NoobyNull/CNC-Display/README.md

# CNC Display

Touch-panel firmware for a [FluidNC](https://github.com/bdring/FluidNC) CNC router:
a pendant you mount by the machine and run jobs from. It runs on an
**Elecrow CrowPanel Advance 7.0** (ESP32-S3, 800×480, GT911 touch) with
[LVGL](https://lvgl.io) 8.3, and talks to the controller over a 1 Mbaud UART.
Built for one machine (a FoxAlien Masuter 3S 8040 on a Corgi board with an
OpenATC tool rack), but every control is gated on what the controller's own
config says it has.

<p>
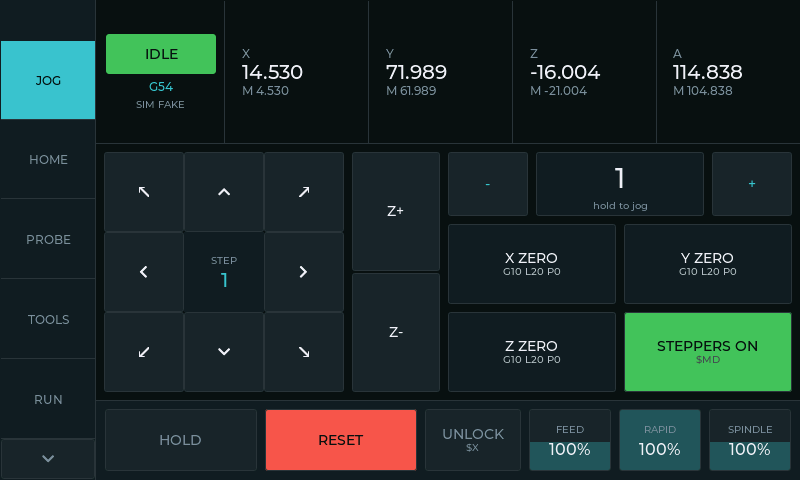
[picture p1: docs/screenshots/jog.png]
Jog page

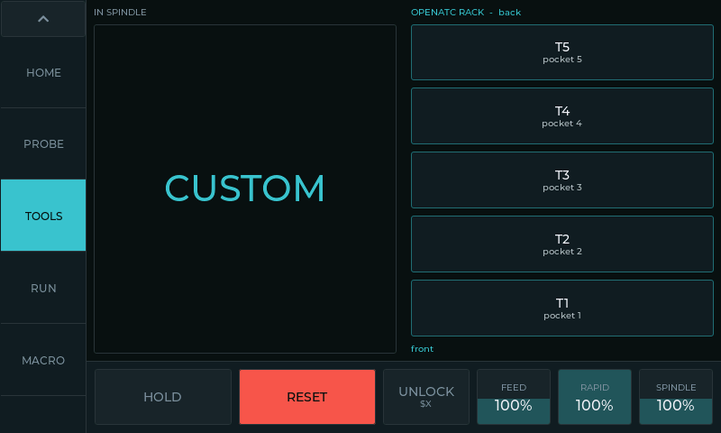
[picture p2: docs/screenshots/tools.png]
Tools page with the OpenATC rack

</p>

## What it does

- **DRO and jog** — work and machine position for every axis the controller
  reports; continuous hold-to-jog, step jog, tap an axis to type a target.
- **Homing walk-through** — when position can't be trusted (fresh link,
  controller restart, an alarm that loses position) a card walks you through a
  checklist, HOME ALL, and an optional tool-length measurement.
- **Tool changes** — a TOOLS page laid out like the machine: five buttons, one per
  OpenATC cartridge, in a column with T1 at the front. Anything else in the spindle
  is the custom tool, fitted and removed by hand. What a tool's card offers follows the
  controller's config: with an M6 macro, tap a tool and LOAD or CANCEL, and the
  macro does the rest; with `atc_manual`, LOAD / CURRENT / UNLOAD and honest text
  about what each will do. Either way the card shows the plan first, every
  by-hand step gets its own card, and jobs that pause for a tool say *which* tool.
- **Overrides** — feed, rapid and spindle open a full-width slider card.
- **Safety** — HOLD / RESET / UNLOCK on every page, never covered by a popup;
  STEPPERS OFF disarms hard limits so pushing the gantry by hand can't trip a
  reset that silently re-enables the motors.
- **Probe, offsets, macros, run from the controller's SD card, calibration,
  diagnostics** — see the screenshots below.
- **Network update** — the panel fetches its own firmware over Wi-Fi, resuming
  a stalled download.

## Screenshots

All of these are the real UI, rendered by the desktop simulator below.

| | | |
|---|---|---|
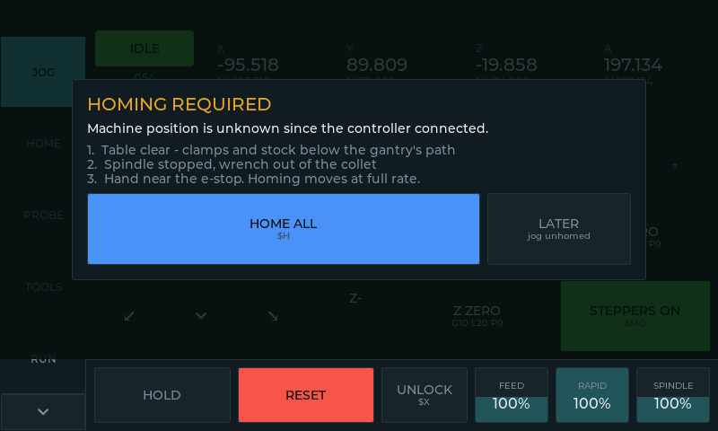
[picture p3: docs/screenshots/homing-walkthrough.png]
Homing walk-through
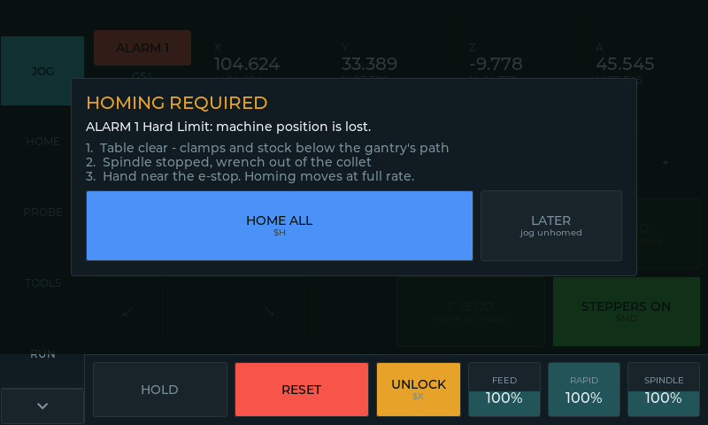
[picture p4: docs/screenshots/alarm.png]
Alarm
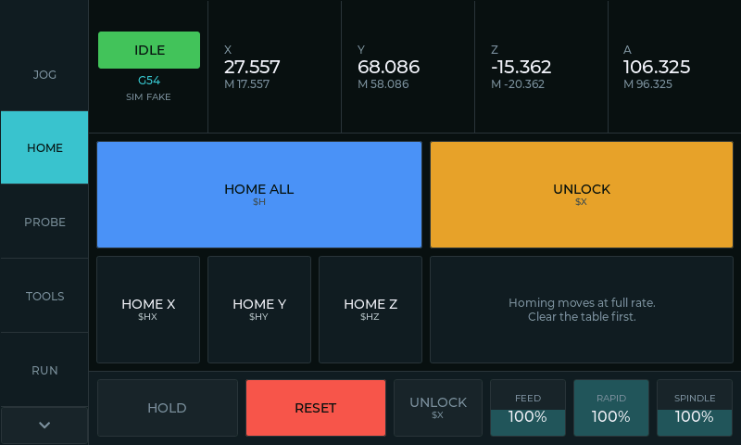
[picture p5: docs/screenshots/home.png]
Home
|  Homing walk-through |  After a hard-limit alarm |  Home |
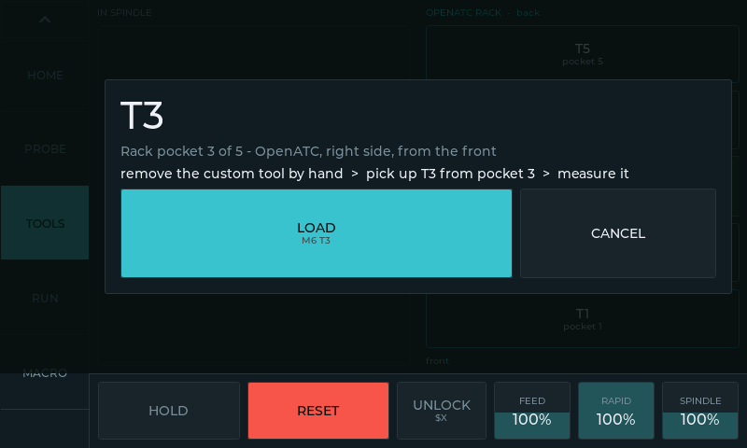
[picture p6: docs/screenshots/tools-load-card.png]
Tools load card
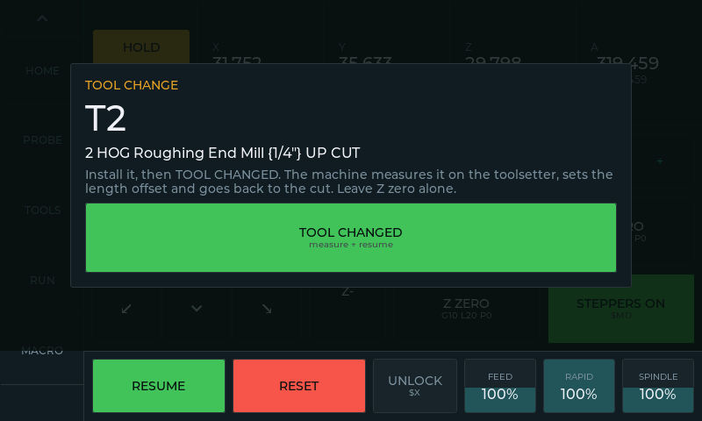
[picture p7: docs/screenshots/tool-change-card.png]
Tool change card
|  Tap a tool: the plan, LOAD / CANCEL |  A job paused for a tool | Tools Tools |
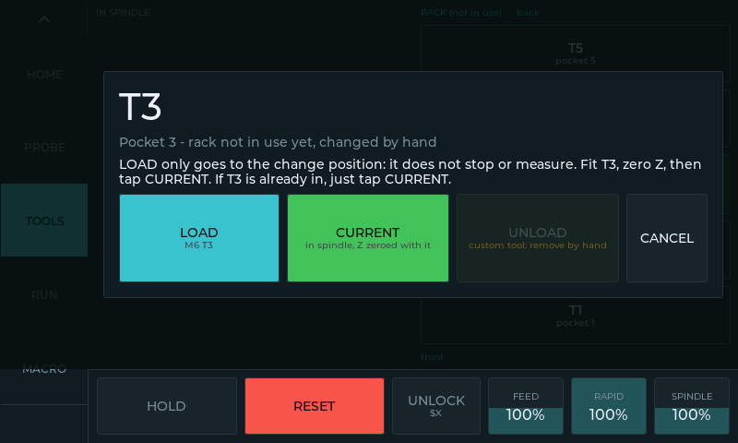
[picture p8: docs/screenshots/tools-manual-card.png]
Tools with atc_manual
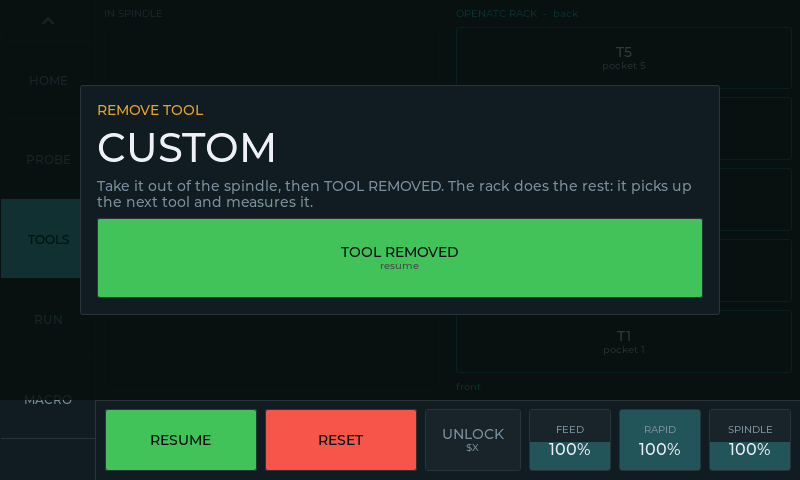
[picture p9: docs/screenshots/tools-remove-card.png]
Remove tool
|  The same card under `atc_manual` |  A custom tool coming out before a pickup | |
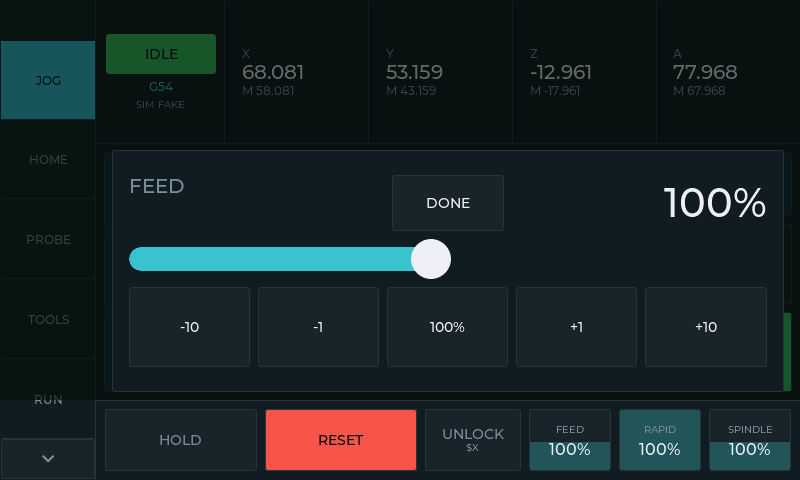
[picture p10: docs/screenshots/feed-override.png]
Feed override
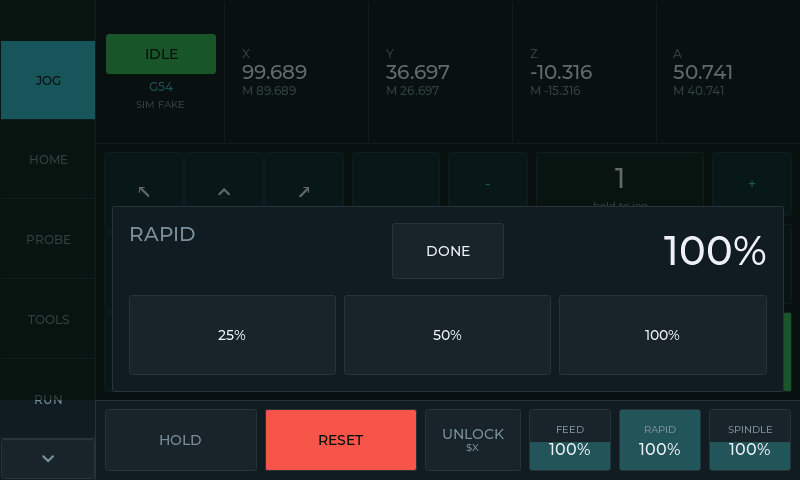
[picture p11: docs/screenshots/rapid-override.png]
Rapid override
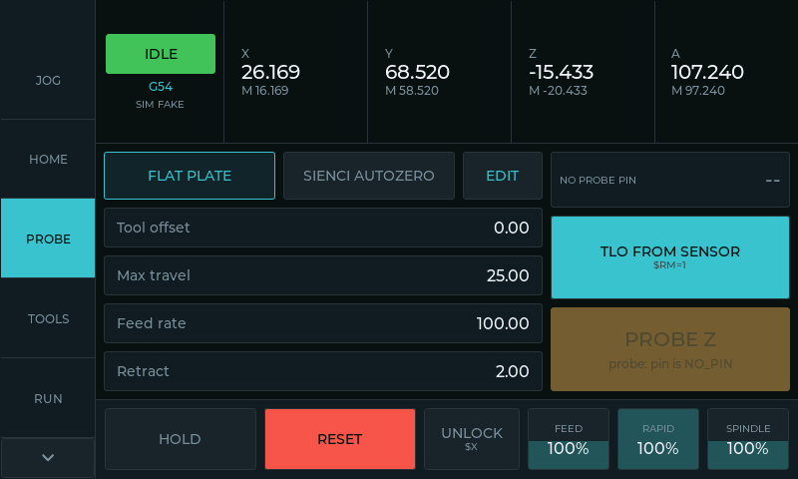
[picture p12: docs/screenshots/probe.png]
Probe
|  Feed override |  Rapid override |  Probe |
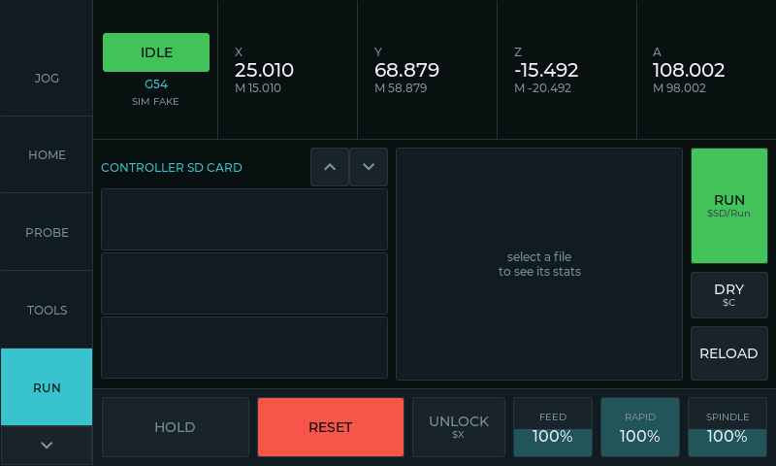
[picture p13: docs/screenshots/run.png]
Run
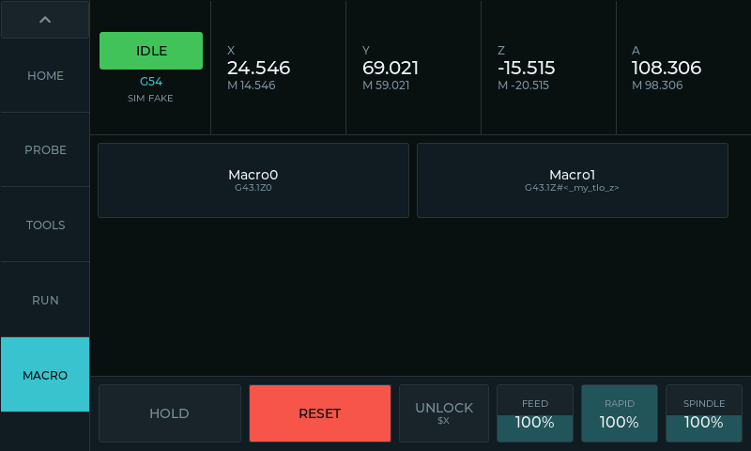
[picture p14: docs/screenshots/macro.png]
Macro
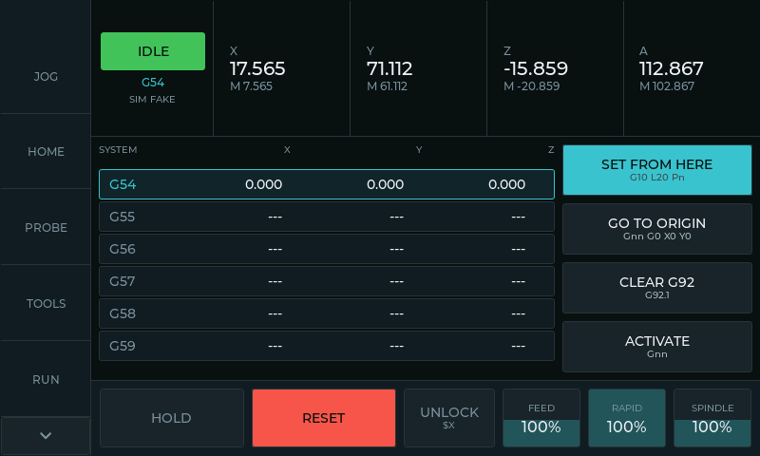
[picture p15: docs/screenshots/offsets.png]
Offsets
|  Run (controller SD card) |  Macros |  Work offsets |
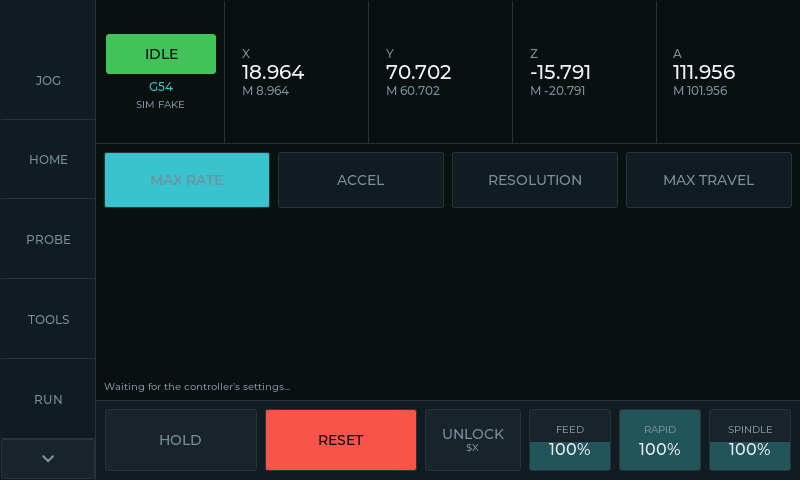
[picture p16: docs/screenshots/motion.png]
Motion
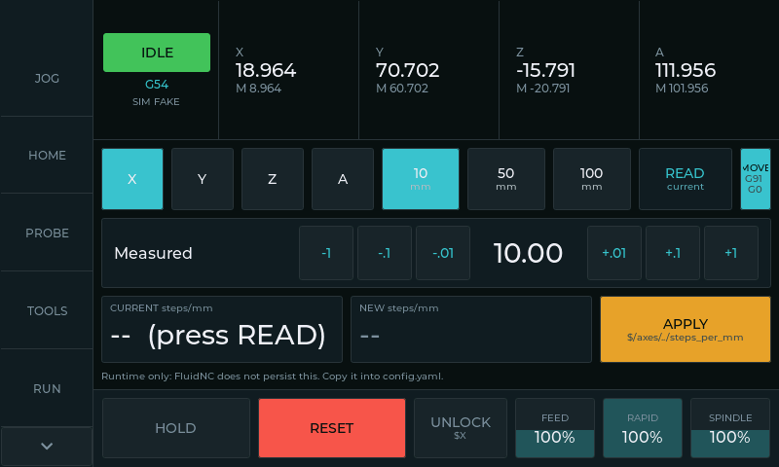
[picture p17: docs/screenshots/calibrate.png]
Calibrate
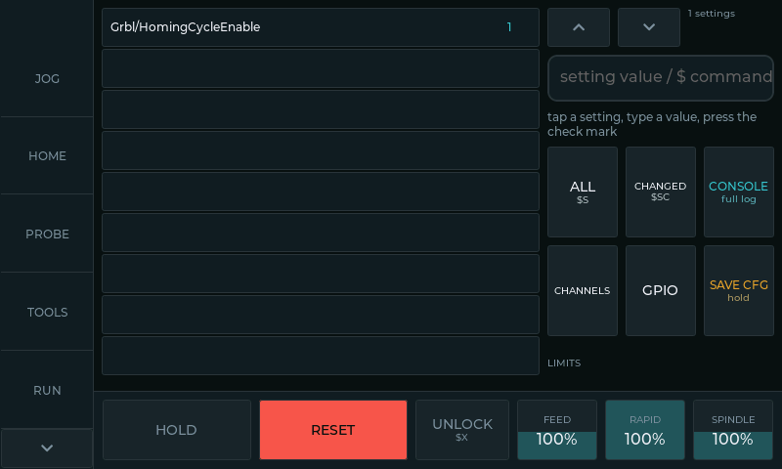
[picture p18: docs/screenshots/diag.png]
Diag
|  Motion settings |  Steps/mm calibration |  Diagnostics |
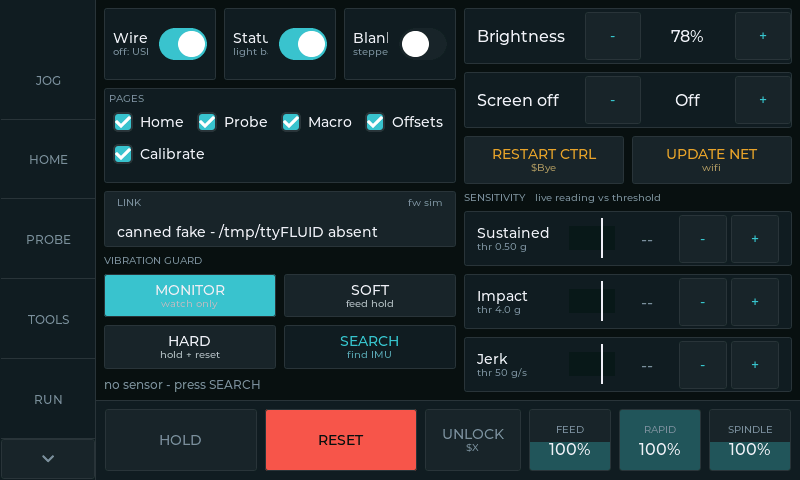
[picture p19: docs/screenshots/setup.png]
Setup
|  Setup | | |

## Building and flashing

[PlatformIO](https://platformio.org) builds everything:

```bash
pio run -e crowadv                 # the firmware
pio test -e native                 # host unit tests (parsers, models)
```

Flashing: the board's ROM bootloader over USB. `tools/flash.sh` and
`tools/flash_cnc101.sh` are the scripts used here (the latter flashes over SSH
from the PC the panel is plugged into). Once a panel is running, **Setup →
UPDATE NET** updates it over Wi-Fi from the URL in `src/model/settings.cpp`.

**Before building your own:** the Wi-Fi network and update URL defaults in
`src/model/settings.cpp` are this shop's; in the public copy the password and
access token read `REDACTED…`. Put your own in, or the network update has
nothing to connect to.

## Simulators

Two ways to run the real UI on a desktop without the hardware. Both compile
`src/ui` and `src/model` unmodified against SDL2 (needs `libsdl2-dev`).

### Desktop panel (`src/sim`)

The panel in a window, against a built-in fake controller:

```bash
pio run -e sim && .pio/build/sim/program
.pio/build/sim/program --page 10 --shot tools.bmp           # one frame, headless (page index)
.pio/build/sim/program --toolchange 2 --shot card.bmp       # a job pausing for T2
```

Window keys: `1`–`5` force Idle / Run / Hold / Alarm / Jog, `6` plays the next
tool change of a sample job, `space` freezes the DRO, `s` saves a screenshot.
`--tap "x,y;x,y>x2,y2"` scripts touches, which is how the screenshots above were
made. The fake controller runs an M6 macro by default; `--atc-manual` makes it
behave like `atc_manual` instead. `--link host:port` or `--link /dev/ttyX` drives a real FluidNC instead.

### FluidNC bench (`sim/`)

A fake FluidNC that loads an actual `config.yaml` and derives everything from
it — which axes, which limit and probe pins, whether homing exists — with a web
page to flip inputs and watch the controller:

```bash
make -C sim
./sim/run.sh              # the bring-up profile
./sim/run.sh equipped     # limits, probe, coolant, door, all present
# then open http://127.0.0.1:8080
```

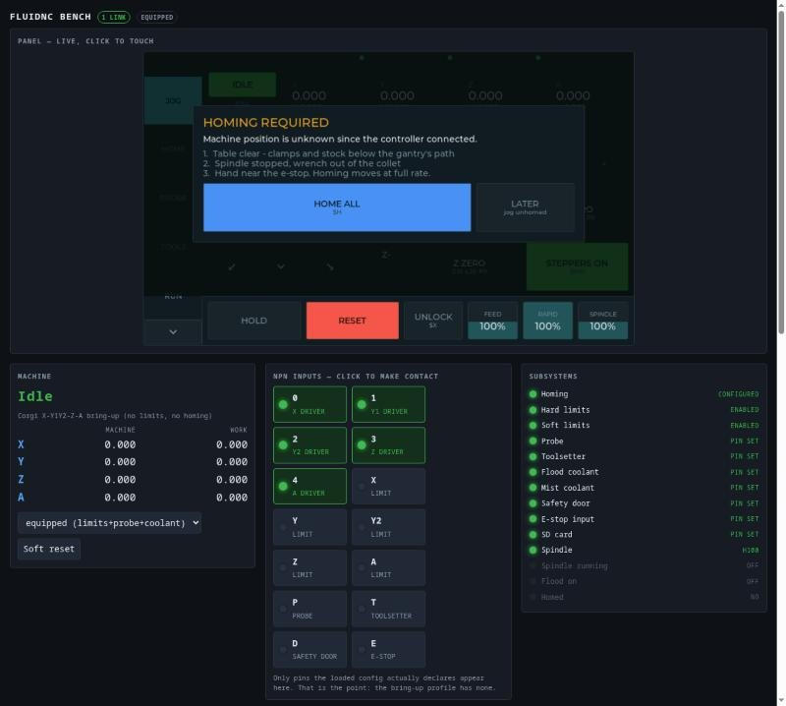
[picture p20: docs/screenshots/bench.jpg]
FluidNC bench


See [`sim/README.md`](sim/README.md) for what is real and what is faked.

## Layout

```
src/ui/        pages, the shell (rail, DRO, safety bar), cards and popups
src/model/     the FluidNC model: state, capabilities, homing, tools, offsets
src/hw/        display, touch, IMU, status LEDs, network update
src/transport/ the UART link and XModem
src/sim/       desktop simulator stand-ins
sim/           FluidNC bench simulator
test/          host unit tests (pio test -e native)
tools/         flashing, config upload, G-code generators
cad/           the panel's mounts and enclosures (FreeCAD)
docs/          engineering notes and handoffs, screenshots
```

The controller side of tool changes — the FluidNC `m6_macro` that drives the
OpenATC rack — lives with the machine's config, not in this repo.

## Credits

The FluidNC model and protocol handling started from Mitch Bradley's
[FluidDial](https://github.com/bdring/FluidDial) (GPLv3; the copy
that was vendored here is in the git history before the rework), and the parser is his
[GrblParser](https://github.com/MitchBradley/GrblParser).

## License

[GNU General Public License v3.0](LICENSE). This project builds on FluidDial,
which is GPLv3, so the whole is too: you may use, modify and share it, and
anything you distribute that is built from it must be shared under the same
terms, with its source.
