NoobyNull/CNC-Display/docs/HANDOFF.md

# Handoff — CNC Console, 2026-08-11

## Session 2026-10-07 — jog crawl, remote update, OTA fixed end to end — read this first

- **Jog/Go-To crawled** (100 mm at ~250 mm/min, seemingly random axis/direction).
  They read `Grbl/MaxRate/<axis>` from the `$S` table on every move, and Diag
  (All/Changed) and Motion edits clear that table and re-request it. In that
  window the lookup fell to `JOG_FALLBACK_RATE` (500 x jog%). Fixed: both keep
  the last rate seen per axis (`page_jog.cpp`, `goto_popup.cpp`).
- **Remote update trigger.** Telnet to FluidNC (192.168.0.5:23) and send
  `$LM=*PANEL:UPDATE` (or `$Msg/Channel=uart_channel2,PANEL:UPDATE`). The panel
  sees `[MSG:PANEL:UPDATE]` and runs `fwupd_net()` — the same function as the
  Setup UPDATE NET button — only when Idle/Alarm; the tap-to-cancel countdown
  still runs. Failures are broadcast back as `[MSG:PANEL-UPDATE FAILED: ...]`.
  Verified live: app1 written, otadata switched to it, panel relinked.
- **Network OTA had been broken twice over:**
  1. Cloudflare's minimum TLS on yax.family had been raised to 1.3. The panel's
     mbedTLS is TLS 1.2 only (`CONFIG_MBEDTLS_SSL_PROTO_TLS1_3` unset) -> HTTP -1
     "fatal alert". Min TLS set back to 1.2 (1.3 stays enabled). **If OTA starts
     failing with HTTP -1 again, check that setting first.**
  2. `Update.begin()` was called before the download and again before flashing;
     the second is refused with no error code ("No Error"). Now called once.
- `display_release_internal_ram()` moves the LVGL draw buffer to PSRAM before
  WiFi. Added on a wrong guess (internal heap turned out fine: 139K/61K free);
  harmless because every radio-up update ends in a reboot.
- **USB flashing via CNC101:** the panel is plugged into CNC101 (ssh alias
  `cnc101`, user cnc, fish shell — wrap remote commands in `bash -c`).
  `tools/flash_cnc101.sh` builds and flashes app0 at 115200 (460800 fails).
  This machine cannot reach 192.168.0.5 directly; CNC101 can.
- Seen in passing: FluidNC rapid override was at 5% (`Ov:100,5,100`, byte 0x98 —
  not the panel, which only sends 100/50/25); reset to 100.
- **The machine is no longer the bring-up config.** Live (synced to
  `CNC-Wiring/config.yaml`): limits, homing, probe/ETS, XY 10000 mm/min @ 800,
  Z 1000 @ 800, 39.882 steps/mm XY, 400 Z. `sim/profiles/corgi_bringup.yaml`
  is now a historical fixture (its tests need a no-homing machine), not the
  live config the sim README describes.
## Session 2026-09-16 — the IMU records now, and two sensor defaults were wrong

The vibration guard kept only `sqrt(ax²+ay²+az²)` and threw the three axes away
every sample. That is enough to notice a machine shaking and useless for working
out **what** is shaking: a scalar cannot be rotated into the machine frame
afterwards and cannot separate an X reversal from Z chatter. The sensor on this
machine is bolted to the **spindle** in an orientation nobody wrote down, so the
frame has to be recovered in post — which only works on raw axes.

**New `src/model/imu_log.{h,cpp}`** — raw 3-axis recorder, two sinks:

- **SD card**, `/imu/NNNN.csv`, the real one. Runs with the link up, so every
  sample carries the FluidNC state and machine position it happened at.
  Controlled by **IMU LOG on the Diag page**.
- **USB console**, 115200, `t_us,ax,ay,az` only. Alive solely when the Setup
  "Wired UART" toggle is OFF, so there is no link and no position — but the host
  PC can hold FluidNC's own CP2102 at the same time (different cable, different
  chip) and own that half of the correlation. `~/imu_capture.py` on the shop PC
  is the other end. Console keys: `r` record, `s` stop, `t` stream, `?` status,
  `h` help.

Samples go into a 2048-record PSRAM ring; `imulog_poll()` drains it from
`loop()`, never from a UI callback — an SD write can stall for tens of ms and
the FluidNC RX ring is only 16K (~160 ms at 1 Mbaud). A full ring drops the
**newest** sample and counts it: a log with a hole that says so is usable, one
silently resampled is not. The card never waits on the console; when both are
running, console lines that will not fit are skipped and counted separately.

### Two ICM-20948 defaults that were quietly wrong

SparkFun's `startupDefault()` leaves the accelerometer at **±2 g** with its
low-pass filter **disabled** (`acc_d473bw_n499bw`, ~500 Hz of noise bandwidth)
and the ODR at 1125 Hz. Both are now set explicitly in `imu_apply_config()`:

- **Aliasing.** Sampling 500 Hz of bandwidth at 50 Hz folds every spindle
  harmonic above 25 Hz back into the band, where it is indistinguishable from
  real low-frequency machine motion. The guard has been reading that since the
  port. The DLPF is now re-picked whenever the rate changes, always below
  Nyquist for the rate actually sampled.
- **±2 g clips below the 4.0 g impact threshold the guard ships with**, so
  `THRESHOLD_ESTOP_PEAK_G` could never fire however hard the machine was hit.
  Not a tuning problem — an unreachable number. Now ±8 g, which still resolves
  0.00024 g.

**This changes what the guard sees.** Less aliased noise in the band, and an
impact threshold that can now actually trigger. Re-check the sensitivity
settings on the Setup page against a real cut before trusting the old numbers.

### Rate

`IMU_RATE_HZ` is 50 (the comment above it claiming 200 has been stale since the
port). 50 Hz resolves 25 Hz — fine for catching an impact, too narrow for bench
and gantry resonances, which live in the tens of Hz. `imu_set_rate()` is new;
the recorder holds 200 Hz while a sink is open and hands it back afterwards,
because 200 Hz costs several percent of the shared I2C bus and that is visible
in the UI. `imu_skips()` counts samples lost to GT911 contention and belongs
next to any log taken at a raised rate.

## Session 2026-08-25 — the Corgi runs FluidNC **v4**, and $S changed — read this first

The controller is **FluidNC v4.0.3**, not v3. This invalidates an assumption
the panel was built on, and it is the root of several things that looked like
UI bugs. Captured live off 192.168.0.5 over the telnet channel (port 23):

- **`$S` on v4 returns the Grbl-compat settings ONLY** — `$Grbl/MaxRate/X`,
  `$Grbl/Acceleration/X`, `$Grbl/HomingCycleEnable` and the network keys. 55
  lines. It does **not** expose the config tree the way v3 did. There is no
  `/probe/pin`, no `/axes/x/motor0/limit_neg_pin`.
  - Consequence: `page_diag.cpp` scanned `$S` for `"/probe/pin"` to decide
    whether the probe lamp exists. On v4 that string never appears, so the
    lamp could never light. Fixed — it now asks `caps.cpp`.
  - The `fnc_settings.h` comment about "~150 lines on the 4-axis config" is a
    v3-era number.
- **Pins live in `$CD`** (the config dump, i.e. config.yaml). That is the only
  way to find out on v4 whether a probe, coolant or door input is configured.
- **`$RI=200` is rejected** (`error:3`). Auto-reporting is configured in the
  YAML instead — the Corgi's `uart_channel2` sets `report_interval_ms: 75`.
- `$Files/ListGCode=/sd` works and is correctly formed. `$Files/List` does not
  exist on v4; `$SD/List` and `$LocalFS/List` do.

**New: `src/model/caps.h`** — one place that answers "what can this machine
do", fed by `$S` and `$CD`. Capabilities are tri-state; anything not reported
stays `CAP_UNKNOWN` and leaves the control **enabled**, because a query that
failed is not evidence the hardware is missing. The Home and Probe pages and
the nav rail all gate off it.

**New: `sim/`** — the desktop bench. Runs the real `src/ui` and `src/model`
against a fake FluidNC v4.0.3 that has the actual Corgi config behind it, so
config-driven UI can be developed without the machine. See `sim/README.md`.

Two bugs fixed and pinned with tests (`pio test -e native`):

- `filelist.cpp` scanned from the first `{`, which is the outer
  `{"files":[...]}` object — so every listing showed its **first file twice**.
- The `$CD` scanner initially ate the `$S` reply, because both are queued at
  link-up and their replies each end in `ok`. It now ignores `$`/`[`/`<`/`{`
  lines and only honours a terminator once the YAML has actually started.

Still open: **the panel only ever browses `/sd`.** Controller flash holds no
G-code on this machine (just `config.yaml`, `favicon.ico`, `index.html.gz`), so
there is nothing to show there — but there is also no way to look.

## Session 2026-08-20 — CrowPanel Advance 7.0 V1.4
## From the parallel session — jog rework notes (since built on the branch)

## Next — jog rework (decided, not built)

Agreed design, with the constraints that shaped it. Nothing here is
implemented; `page_jog.cpp` is untouched.

**Continuous jog speed comes from a panel-side percentage**, not from the step
size. Today `continuous_feed()` is `STEPS[s_step] * 300` — FluidDial's "5x the
step per second" — so 1mm crawls at 300mm/min and the step selector is secretly
a speed selector. Replace with `axis maxrate * jog%`, reading
`$Grbl/MaxRate/<axis>` the way `goto_popup.cpp` already does, and keep `jog%` in
NVS with a -/+ control.

Panel-side rather than the controller's own overrides, and that was a real
fork:
- **RAPID has no +/-.** `Realtime.h` offers only Reset(100%), Medium(50%),
  Low(25%); ExtraLow is marked NOT SUPPORTED. It is a three-position selector,
  not a dial.
- **FEED has fine/coarse +/-** but governs cutting moves. Borrowing it for jog
  means the number set while jogging also scales the next G1 — a nasty surprise
  mid-job.
- Panel-side costs one piece of state the controller does not have, and buys
  full range with no semantic collision and nothing to verify about how FluidNC
  applies overrides to `$J=` (untested, do not assume).

**Step selector becomes `-` / number / `+`**, tap the number for a custom size
via the keypad already built for the goto popup. Step by decade. Keep
`CONTINUOUS_MAX_MM` as a DISTANCE test — it currently reads `STEPS[s_step]`,
and a custom 250mm step must still disable hold-to-jog.

**The coast on release is bounded in TIME, not distance**, and this is why
raising the feed is acceptable. Chunks are sized to `JOG_TICK_MS` (150ms), so
releasing a key completes at most one chunk: 0.15s of motion at any feed. The
distance scales with speed, the exposure does not, and no stop command is
needed — motion ends when chunks stop arriving. That is why JogCancel being
broken on v4.0.4 has never actually bitten. `JOG_TICK_MS` is the single safety
knob; shortening it presses directly on the still-open blocking-send bug, so
change it only after that is fixed.

**Backstops if a jog runs past travel**, checked against the config the
simulator runs (confirm against what is actually in the Corgi's flash, which
HANDOFF records as different):
- `fault_pin: 'gpio.35:low'` and `estop_pin: gpio.36` ARE configured, so a
  closed-loop driver stall raises an alarm — but only if the HB808C `ALM`
  outputs are physically wired. Continuity check at the cabinet, not something
  the panel can report.
- `soft_limits: false` everywhere, and meaningless until the machine homes.
- `hard_limits: false`, even where a `limit_neg_pin` is assigned.

So exactly one of the three is armed, and it depends on unverified wiring.
Endstops are planned; this note is precautionary.

Also worth doing while in here: surface `fault_pin` state on the panel, so a
driver fault reads as "driver fault" rather than an unexplained alarm.

---

## Session 2026-08-20 — CrowPanel Advance 7.0 V1.4 — read this first

The Waveshare 7B went back on warranty (U13 mux dead, section below), and the
firmware now targets the **Elecrow CrowPanel Advance 7.0 V1.4** (env `crowadv`,
800×480, same N16R8 module). Everything below this section describes the 7B and
stands as history; where it contradicts this section, this section wins.

**The link works end-to-end for the first time**: panel → UART0-OUT →
pigtail → Airedale pendant RJ12 → Corgi uart2 (gpio.27 TX / 25 RX @ 1M).
Verified live: DRO tracks, boot log shows `IO Expander BOARD:Airedale v1.1`.

Port facts, each of which cost real time — details in the code comments and in
auto-memory (`crowpanel-advance-wiring`, `corgi-config-mismatch`):

- Pin truth came from Elecrow's factory example
  (`example/V1.3_and_V1.4_and_V1.5/PlatformIO`) and the V1.4 Eagle schematic,
  not from third-party pinout sites — those were garbled.
- **UART0-OUT is 3.3V direct; UART0-IN is a BSS138 shifter pulled to 5V.** The
  IN connector is for 5V Arduino hosts; using it against a 3.3V controller was
  ruled out on purpose.
- **Console and link share GPIO 43/44** (the USB-C is a CH340K on the same
  nets; no native USB). The Setup "Wired UART" toggle picks the owner at boot.
  Flashing over the wire requires the link cable unplugged — or skip the wire:
  **SETUP → hold UPDATE FW flashes `/update.bin` from the SD card** (two-slot
  partition table as of today; the repartition itself was the last forced wire
  flash).
- Backlight/touch-reset/buzzer live on an **STC8H1K28 at I2C 0x30**: one byte
  0–245 sets brightness (0 = full), 250 pulses the GT911 reset. GT911 INT is
  GPIO 1, I2C is 15/16, SD is SPI on 4/5/6 with the **function DIP on
  TF-CARD** (that position also disconnects UART1-OUT and the audio — one of
  three, not à la carte).
- **FluidNC only auto-reports on a uart_channel after it has received
  something** (`UartChannel::_active`). A silent pendant hears silence forever;
  every passive listen during bring-up was doomed. Poll first.
- **`$CD=config.yaml` is FluidNC's undocumented persistent save** — dumps the
  live config tree over the boot file. The DIAG page has a hold-button for it,
  and a free-text `$` command line (tap the edit box with no setting selected).
- **The Corgi's flash config is not `~/Desktop/CNC/corgi_config.yaml`.** Flash
  runs a 3-axis FoxAlien-named config (uart2 pins correct); the desktop file is
  the intended 4-axis spec, fixed but not uploaded. Reconcile before machine
  work.
- Boot splash in `src/ui/splash.cpp`; its timeline starts in `splash_begin()`
  *after* blocking init, because the anim clock is wall-time and boot would
  otherwise spend the whole sweep invisibly.

Build `pio run -e crowadv`; tests unchanged (`pio test -e native`, 83 cases).

---

The firmware moved from the Elecrow CrowPanel Advance 7.0" to the **Waveshare
ESP32-S3-Touch-LCD-7B**. The old board was abandoned because it could not be put
into download mode: its CH340's TX line was dead and EN was shorted to IO0. None
of that survives here — the 7B flashes over native USB.

---

## Session 2026-08-12 (evening) — read this first

**75/75 host tests pass**, flash 14.5%, RAM 20.8%.

### The GT911 was never broken. The watchdog was.

The previous session shipped a watchdog that hard-reset the touch controller
after 5s without a frame, built on the belief that *a healthy GT911 free-runs at
5-10 frames/s while untouched*. **That belief is false**, and it was measured
from a panel already assumed to be broken — the exact trap the previous handoff
warned about, walked into anyway.

What this chip actually does, measured with a finger on the glass:

```
idle=115s                                 <- quiet for two minutes, "stalled"
[touch] frame 64 t=115870 status=0x81     <- finger lands
[touch] press 63,342 t=115870
[touch] frame 65..68  (10-40ms apart)     <- scanning at its 8ms refresh
[touch] lift t=116005
idle=0s  down=1  scans 63->74->88  int=0  <- LVGL received it
```

It reports only while something is happening. Untouched it emits three frames
after reset and then nothing, indefinitely. **Idle silence is its resting state,
not a fault.** So the watchdog spent every session resetting a working
controller every 5 seconds — 27 resets in 170s — each costing 300ms of blocked
UI and a forced `touch_down = false` that ate any press in flight. Its own
backoff could never fire: each reset yielded three frames, which looked like
progress and cleared the futile-reset counter.

Removed entirely: `touch_watchdog()`, `FRESH_STALE_MS`, `s_last_fresh_ms`,
`s_fresh_at_reset`, `s_futile_resets`, `s_reset_count` and its accessor. The
I2C error recovery stays — a real bus fault shows up as `staterr`, not silence.
**Do not add a no-frames watchdog back.** There is a blunt comment in
`touch.cpp` where it used to live.

The chip's stored config was read for the first time and is intact — checksum
valid, 1024x600, INT falling-edge, 8ms refresh, `lowpower=3s`. `lowpower` looked
like the culprit until the frame timestamps showed the quiet starting ~20ms
after reset, not 3s. `gt911_dump_config()` prints all of it at boot; it is
one-shot and only runs with a USB host attached.

### Jog keys are disabled when there is no controller

`send_jog_line()` is ack-gated on UART, so every press parks in
`fnc_send_line()`'s `while (_ackwait)` until the 2000ms timeout — inside the
same `lv_timer_handler()` pass that reads touch. Held past 400ms it is worse:
`jog_chunk()` re-sends every 150ms, each send costing more than the tick that
scheduled it, so the timer is permanently overdue, the input read is starved,
and the release that would call `jog_stop()` never arrives.

`page_jog_tick()` now greys the ten direction keys out while
`state == Disconnected`. `lv_obj_hit_test()` rejects `LV_STATE_DISABLED`
outright, so the press never reaches an event handler.

**This makes the jog page inert on a bench with no controller.** Run the
simulator (below) and the keys come back by themselves.

### STILL OPEN — the blocking send

Disabling the keys does **not** fix the dangerous case. A *connected* controller
that stops acking — busy planner, ALARM, XOFF, a cable glitch — blocks
identically, because `state != Disconnected`. That is the case that happens
mid-cut, when a frozen panel means no HOLD and no RESET.

It is not jog-specific either: `zero_cb` and `motors_off_cb` go `send_linef` ->
`vsend_linef` -> `send_line` -> `fnc_send_line(s, 2000)`. X/Y/Z ZERO and
STEPPERS OFF freeze the panel ~2s per press with the link down.

The fix is one place — the UI must never wait on an ack. `show_ok()` already
exists in `FluidNCModel.cpp` and already decrements a jog-window counter, so
acks are visible app-side: a chunk can **skip** when one is outstanding instead
of blocking, which also stops the planner queue growing.

### The simulator is fixed — five faults, stacked

`~/Projects/FluidNC`, run from `simrun/`. The previous handoff blamed
`ttybridge.py`; **the bridge was innocent**.

> **FluidNC ITSELF MUST STAY STOCK.** Every fix below lives in `simrun/` —
> config and NVS data, nothing else. The first attempt at this fixed four of the
> five by editing `capture/Platform.h`, `capture/i2s_out.cpp` and
> `platformio.ini`, and that was thrown away. A simulator that only works
> against a patched FluidNC proves nothing about the real controller, and the
> patch is a permanent liability every time upstream moves. If a future fix
> seems to need a FluidNC source change, it is the wrong fix.

The host build's constraints are fixed, so the config bends to them: ESP32-S3
pin table (legal `0-21` and `35-48`), `MAX_N_I2SO 0`, `MAX_N_UARTS 2`,
`Spindles/VFD/*` excluded. `MAX_N_SIMULATOR 1` and
`DEFAULT_STEPPING_ENGINE = SIMULATOR` come from stock `posix/Platform.h`.

| Fault | Fix, entirely in `simrun/` |
|---|---|
| Telnet 23 / HTTP 80 are privileged ports. Arduino-Emulator's `EthernetServer::begin_()` loops `while (::bind(...) < 0) { delay(1000); }` **for ever**, so startup never completed | `native_nvs/Telnet.Enable` + `HTTP.Enable`, one `0x00` byte each (`EnumSetting` loads via `get_i8`, `OFF = 0`; the key's `/` becomes `.` in the filename) |
| `gpio.23/32/33` do not exist in the S3 pin table | remapped in config to `gpio.20/40/41`. Motion parameters untouched |
| Every `I2SO.n` disable pin is an "Unknown pin type", and the `i2so:` section an ignored key | `i2so:` section dropped; the five `disable_pin`s are `NO_PIN`. The simulator engine never drives them |
| `uart2` (expansion) exceeds `MAX_N_UARTS 2`, and `Huanyang:` is an ignored key because the host build excludes the VFD sources | `uart2:`, `uart_channel2:` and `Huanyang:` sections dropped. No spindle and no Airedale in the sim |
| `engine: I2S_STREAM` is not a registered host engine, so it silently fell back to `step_engines[0]` (Timed) — which demands gpio step pins, failing all five motors | `engine: Simulator` with `sim.0-3` step/dir pins; `StandardStepper::validate()` has an explicit `sim` escape hatch |

Any one of them alone kept it in Alarm with `$X` refusing to clear
(`error:152`). Verified against **stock** FluidNC: zero `ERR` lines at boot,
`Stepping:Simulator`, `$J=G91F1000X10` -> `ok`, MPos 0 -> 10 -> 20, and the
panel links over the FTDI at `state=5`.

**`sim.N` is an axis, not a pin** — `sim.0`=X, `sim.1`=Y, `sim.2`=Z — and the
same sim pin is valid for both step and dir. Y1 and Y2 share `sim.1`.

**Two gotchas, both of which cost real time:**

1. FluidNC's host build reads `simrun/native_localfs/config.yaml`, **not**
   `simrun/config.yaml`. They are different files; the outer one is stale and
   unused. Edit the localfs copy.
2. FluidNC's config parser takes the rest of the line as the value, so a
   trailing `# comment` after a pin becomes **part of the pin name** —
   `Cannot write to pin NO_PIN        # SIM ONLY...`. Notes go on their own line.

### Next on the sim

After the handshake `rx` froze at 51 and `tx` at 59 — the link is up and acking,
but no status reports flow, so the DRO will not track a jog live. Unsolved.

### Diagnostics added, all deliberately kept

`[touch] press x,y` / `lift` on every touch, `[touch] frame N t= status=` for the
first 8 frames after a reset, `int=` and `stat=` on the 2s status line, and
`[jog] chunk blocked Nms` when a jog send costs more than 20ms. The press log is
what proved the controller healthy; the frame timestamps are what killed the
`lowpower` theory.

---

## Session 2026-08-12 (earlier)

Everything below the next divider is still accurate except where this section
contradicts it. **73/73 host tests pass**, flash 14.4%, RAM 20.6%.

### Added

| | |
|---|---|
| Screen blanking | SETUP -> "Screen off", 0-60min in 5s, **default Off** (opt-in) |
| Brightness | now 10-100% in 5% steps; storage stays 0-255 |
| Jog | hold a direction key for continuous motion at <=1mm; tap the pad centre to cycle the step x10 |
| CAL page | new nav slot: command 10/50/100mm, measure, apply corrected steps_per_mm |
| Sensor bars | SETUP thresholds are horizontal bars of live-vs-threshold; guard buttons 2x2; jerk histogram removed from the UI |
| Touch | now INT-driven (~7 reads/s, was 50); presses latched so a tap between two LVGL reads is never lost; stall watchdog with backoff |
| IMU | 200Hz -> 50Hz. **Do not go lower**: jerk is rate-independent arithmetic but bandwidth is not — 10Hz resolves 5Hz and a 20ms impact falls between samples, leaving the guard blind while still appearing armed |

### Two bugs shipped and fixed the same session — both worth remembering

**The backlight never came back.** `screen_idle_tick()` decided whether to touch
the backlight by comparing the screensaver's state before and after updating it,
but the touch driver clears that same flag when it swallows the wake tap. No
transition left to observe, `EXIO_DISP` never re-enabled, panel dark until a
power cycle. Fixed by tracking what the backlight *is* doing against what the
screensaver *wants*. **Never infer a hardware edge from state another layer can
also move.**

**A stuck touch killed the panel.** The wake-tap swallow waited for a release.
The GT911 holds its last reported state when it stops producing fresh scans, so
`touch_down` stayed asserted, the release never came, every sample was swallowed
for ever. Fixed with a 600ms cap on the swallow. **Any gate that can only be
opened by an event from hardware is a gate hardware can leave shut.**

Neither was caught by the host tests, and the first could not have been — the
pure module was correct both times, the faults were in the hardware follower.
The regression test for the second one fails against the old implementation.

The console line now carries `scroff=<n>min idle=<n>s [BLANK]`. That diagnostic
turned "I don't think the timeout worked" into a fact in one reading, twice.
Leave it in.

### Verified on hardware this session

- Blanking fires at exactly `idle=301s` on a 5min setting, and stays blank.
- Panel links to a real FluidNC v4.0.4 (the simulator) over the FTDI, locks
  115200, primes offsets and the file list, tracks state live.

### NOT verified

- **The CAL page has never talked to a controller.** `$/axes/<x>/steps_per_mm`
  read-back and apply are untested against anything real.
- **The jog changes have never moved a machine.**
- **The vibration bars have never seen an IMU.**

### Open questions left on the table

1. **Panel power.** Do **not** run the panel off the Airedale's RJ12 5V — that
   port was sized for a FluidDial (~100mA), and a 7" panel with backlight is
   500-800mA through 26AWG phone cable. ~0.5V drop at 800mA over 2m, and 5V has
   no headroom. Feed it at its own PH2.0 `POWER/GND/5V` input from a buck at the
   panel, **cut the RJ12 5V conductor**, keep RJ12 GND for the UART reference.
2. **File flow undecided.** The panel already does both directions —
   `upload_start()` sends `$XR=`, `pathload_start()` sends `$XS=`. If G-code
   lives on the controller's SD (put there over WiFi), nothing more is needed:
   list it and `$SD/Run=`. A panel-side copy needs a new sink in
   `path_loader.cpp:19`. Decide before building.
3. **USB thumb drive is a dead end.** The 7B's native USB-C has 5.1K pulldowns
   on CC1/CC2 (sink) and VBUS hard-tied to the 5V rail with no switch — it is
   wired as a device. Confirmed from the Waveshare schematic. A microSD
   extension ribbon solves the real problem; keep it **short**, the card runs
   SDMMC 1-bit at 20MHz (`sdcard.cpp:27`), not SPI.
4. **`JogCancel` (0x85) did not stop a jog on FluidNC v4.0.4** — neither raw
   (which is what `GrblParserC.c:572` sends) nor UTF-8 encoded, while `!` worked
   every time. Unexplained. Continuous jog therefore re-issues bounded chunks
   and never depends on that byte. Worth settling on real hardware.

### The GT911 stalls, and it is not cured

**The open bug.** After a burst of touch activity the GT911 stops setting its
data-ready bit and never resumes. Not a bus fault: `polls` climbs, `scans`
freezes, `lockfail=0`, `staterr=0` — the chip answers every transaction and
reports no frames. `touch_poll()` keeps the last state when no frame arrives, so
`touch_down` freezes and the panel looks dead. A power cycle clears it.

**Each watchdog reset yields exactly three more frames, then stalls again.**
103 -> 106 -> 109, every time. That regularity is the lead.

**Untried:** this driver has never written a GT911 config — no refresh rate, no
INT trigger mode — it runs on whatever the chip has stored, and we now drive INT
as an interrupt without knowing what mode it thinks it is in. Read
`0x8047..0x80FF` and check the INT trigger byte at `0x804D` before writing
anything; a bad checksum at `0x80FF` bricks touch until the chip is re-flashed.

**Ruled out, with evidence — do not re-test:** bus wedging (`staterr=0`), the IMU
starving the bus (`lockfail=0`), a GPIO4/RGB conflict (RGB uses
14/38/18/17/10/39/0/45/48/47/21/1/2/42/41 + 46/3/5/7), screen blanking
(reproduced seconds after boot, screen lit), the screensaver swallowing input
(`idle` climbs during the stall), and the interrupt conversion itself.

**Two wrong turns worth not repeating.** "Idle silence is normal for a GT911" is
false — a healthy chip produces ~5-10 frames/s untouched. That was concluded from
a chip already wedged, and a watchdog was narrowed to the wrong condition on the
strength of it. *Never characterise normal behaviour from the device you are
debugging.* And the first watchdog storm-reset every 5s at 300ms of blocked UI
each; it now backs off after three futile attempts.

Full write-up: `/tmp/HANDOFF-display-responsiveness-fix.md`.

### The simulator rig is broken

`~/Projects/FluidNC/simrun` no longer answers commands on the pty or a pipe. It
boots fully (config parses, `fault_pin`/`estop_pin` reported) then loops on
`Emulator - Error: bind failed` after `HTTP started on port 80`. Root cause not
isolated. It was working earlier the same day; the confound was three orphaned
`program` instances fighting over ports 80/23, and clearing them did **not**
restore it.

`ttybridge.py` gained `--serial <port> --baud <n>` to serve the pty and a real
UART at once. The pty half stopped delivering once the panel joined. Suspect
that change before suspecting the simulator.

**Kill simulator processes by PID, never by pattern.** `pkill -f`, and any
`/proc` scan matching a string that also appears in your own command line, kills
the agent session (exit 144). Happened again this session.

---

## Status

**First hardware bring-up is done.** The panel draws, touch works, the UI is up
and interactive. `13.6%` flash of a 6 MB app partition, `20.6%` RAM, 58/58 host
tests pass.

The jog acceptance test passes: press a jog key, slide off without lifting, the
axis stops (`LV_EVENT_PRESS_LOST`). That only worked after the GT911 press-state
fix below — before it, the press never survived long enough to be lost.

**The link is proven, against a stand-in controller.** An FTDI on the UART
terminal answering `?` with a 4-axis Grbl status report brings the panel fully
up: it locks the baud, leaves `Disconnected`, fires `$#` and
`$Files/ListGCode=/sd` from `prime_link_if_up()`, and the DRO grows its **A
column and tracks it live**. So the transport, GrblParserC, the priming path and
the multi-axis layout are all confirmed — only the real machine at the far end
is untested.

Reproduce it with `fakefluidnc.py` (see below): it answers status polls and
pushes a report every 200ms, which is what `$RI=200` asks for. Without the
periodic push the panel decides the link went away.

**Still not verified against hardware:**

- **The real controller.** See the Airedale baud/parity note under *Still open* —
  the stand-in worked because it spoke 115200 8N1, which is what the panel
  already hunts for. The Corgi as configured does not.
- **The vibration guard.** No IMU has ever successfully sat on this bus, so the
  jerk histogram, thresholds and smoothed peak are covered by host tests only.
  The one that was wired held an I2C line low and took out all touch until it
  was unplugged — see below.

---

## Bringing the panel up with no machine attached

An FTDI on the UART terminal is enough to exercise everything above the wire.
`tools/fakefluidnc.py` answers `?` with a 4-axis report and `ok` to every line,
so `send_line()` never spins in `_ackwait`:

```bash
python3 tools/fakefluidnc.py /dev/ttyUSB0 115200 120
```

Two things that cost time working this out:

- **"Wired UART" persists in NVS.** With the Setup toggle off, `s_active` stays
  `TRANSPORT_NONE` and `fnc_putchar()` writes nothing at all — the panel is
  silent on the wire and it looks exactly like miswiring. Check the toggle before
  suspecting TX/RX.
- **The UART1/UART2 switch (SW1)** routes GPIO 43/44 through the FSUSB42UMX mux
  (U13) to either the CH343 USB-C port ("UART1") or the H3 PH2.0 terminal
  ("UART2"). The earlier revision of this doc had it right; the "two terminals"
  correction was wrong — per the Waveshare wiki, "6 and 7 [USB TO UART port and
  UART terminal] are the same UART, selected by switch". H3 pin order is
  **3V3 · GND · RX · TX**.
- **This board's H3 terminal is factory-dead** (confirmed 2026-08-15): 0 V even
  on its 3V3 pin with a seated plug, while the I2C header next to it reads 3.3 V
  with the same cable. Firmware, GPIO 43/44, mux, and switch all verified good —
  internal loopback passes, and a full two-way link ran through the CH343 side.
  Root cause isolated 2026-08-16: **U13 (FSUSB42UMX mux) is internally dead on
  its terminal-side channel**. Proven by elimination: ESP→R107→mux common side
  reads 499Ω and carried live 1 Mbaud data via the CH343 path; mux→H3 traces
  beep; H3 legs reflowed. Fix: warranty swap, hot-air replace U13, or bypass
  bodge (R107 mux-side pad → H3 pin 4, module RXD0 castellation → H3 pin 3,
  SW1 left on UART2).
- `init_fnc_uart()` now logs setup error codes and runs a silicon-internal
  loopback self-test at boot (`[uart] internal loopback: n=4 data=PING` = the
  transmitter provably works, wiring problems are downstream of the chip).
- **Which Type-C is which:** `303a:1001` is the native USB (flashing + `Serial`
  console); `1a86:55d3` is the CH343 USB-UART. The VID tells you which port the
  cable is in when the silkscreen does not.

---

## Bring-up: what actually went wrong

Five days of assumptions died on contact with the hardware. In order of how long
each cost:

### The panel was white because LovyanGFX cannot express these timings

`Bus_RGB::config_t` stores every porch and pulse width in an **`int8_t`**
(`Bus_RGB.hpp:85-90`, still true on upstream master). Waveshare's real values —
`hsync_pulse_width 162`, `hsync_back_porch 152` — wrap to **-94** and **-104**.
The horizontal timing generator gets garbage, the panel never syncs, and the
screen sits white with the backlight lit.

Everything else checked out and wasted hours: the pin map matches Waveshare's
`rgb_lcd_port.h` exactly, so do the timings, the PCLK and the io-extender.

### Then it was static, because LovyanGFX has no bounce buffer

`Panel_RGB::initFrameBuffer()` unconditionally puts the whole framebuffer in
PSRAM — its `use_psram` field is literally marked `unimplemented`, and the code
comments itself as "provisional implementation ... ToDo: split allocation".
Streaming 1.2 MB per frame straight out of PSRAM while LVGL writes into it
produces static-TV noise. Dropping PCLK to 21 MHz reduced it; nothing removed it.

**The driver is now ESP-IDF `esp_lcd_rgb_panel` directly** (`display_hw.cpp`):
`uint32_t` timings so the true 162/152 are restored, two DRAM bounce buffers
(`1024*10` px), full 30 MHz. LovyanGFX is no longer in the display path.

### Touch worked all along; we were throwing the press away

`touch_poll()` treated GT911 status `0x00` as a finger lift. It means "no fresh
scan since you last cleared the buffer" — the normal case, since we poll at 50Hz
and the controller refreshes slower. `touch_down` was dropping to false between
refreshes, flickering the press faster than LVGL samples the input device.
Press-and-hold on a jog key was impossible. Now the previous state stands unless
bit 7 is set.

### An SD card can stop the board booting entirely

A faulty microSD in the slot pulls the 3.3 V rail down hard enough that the chip
never starts — **no USB enumeration at all**, which is below firmware and below
boot mode. Symptom is indistinguishable from a dead board or a charge-only cable.
A known-good card behaves perfectly. If the panel is completely dark, pull the
card before suspecting anything else.

### A miswired I2C device takes out every input on the panel

An ICM-20948 wired wrong held a line low and wedged the bus. `ESP_ERR_INVALID_STATE`
on every transaction from then on — and since the GT911 shares SDA 8 / SCL 9,
**all touch died, safety bar included**. `touch_poll()` now counts consecutive
failures and re-inits the bus after 25 (~0.5 s), and `imu_probe()` recovers the
bus after a failed probe, because SparkFun's `begin()` against a missing device
is what wedges it in the first place.

---

## WiFi was removed

The WiFi/Telnet transport is gone: `wifi_link.{h,cpp}` deleted, `TRANSPORT_WIFI`,
the Telnet host/port settings and the Setup credentials UI with it.

The ESP32-S3's WiFi stack blacks out the flash cache, and arduino-esp32 ships its
prebuilt libs with **`CONFIG_LCD_RGB_ISR_IRAM_SAFE` unset** — so the RGB panel's
ISR cannot run during those blackouts, the DMA loses sync and the display tears
and drifts. Bounce buffers do not cover it. It cost 623 KB of flash and the
machine link is a cable anyway.

`display_resync()` survives that removal and is called after every **NVS write**,
which blanks the cache the same way — the brightness +/- buttons write a key per
press.

---

## Hardware

ESP32-S3-WROOM-1-**N16R8** (16 MB flash, 8 MB octal PSRAM), 1024×600 RGB565
panel behind an ST7262, GT911 touch, CH32V003 I2C io-extender, CH343P USB-UART,
native USB, RS485 (SP3485) and CAN (TJA1051).

### GPIO map

| Pins | Use |
|---|---|
| 0,1,2,3,5,7,10,14,17,18,21,38,39,40,41,42,45,46,47,48 | RGB panel |
| 4 | GT911 TP_IRQ — also the address strap, see below |
| 8 (SDA), 9 (SCL) | I2C: GT911 `0x5D`, io-extender `0x24` |
| 11 (CMD), 12 (CLK), 13 (D0) | TF card, **SDMMC 1-bit** |
| 15 (TX), 16 (RX) | RS485 terminal, unused so far |
| 19, 20 | native USB **or** CAN — the io-extender picks |
| **43, 44** | UART0 pads → FluidNC link (UART2 peripheral) |
| 26–37 | octal PSRAM + flash, unusable |
| 6 | genuinely free and unconnected. The only one. |

### io-extender (0x24)

Not a plain expander — a CH32V003 with a register map. `src/hw/io_expander.cpp`
reimplements Waveshare's driver because theirs seeds the output shadow with
`0xFF`, and bit 5 is `CAN_SEL`.

| Line | Function |
|---|---|
| EXIO1 | GT911 reset |
| EXIO2 | backlight enable (DISP) |
| EXIO3 | panel reset |
| EXIO4 | TF card DAT3 — **must idle high** for SDMMC mode |
| EXIO5 | `0` = USB-C is native USB, `1` = it becomes the CAN PHY |
| EXIO6 | panel VCOM rail |
| PWM reg `0x05` | backlight brightness, **inverted**: 0 is brightest |

---

## Flashing

Plug into the Type-C marked **USB** (not the one marked UART). That is the
native USB-Serial-JTAG peripheral on GPIO 19/20, and it is both the flashing
port and the debug console.

```bash
pio run -e ws7b -t upload
```

If the port does not enumerate, hold BOOT while plugging in, then release.

The board switch labelled UART routes GPIO 43/44 to *either* the CH343 or the
UART terminal. **Set it to the terminal and leave it.** The FluidNC link lives
there permanently and never has to be given up to update the board — which is
what the old UPDATE/PENDANT link mode existed to work around. That mode, its
NVS key and its Setup-page buttons are gone.

---

## What changed in the port

- **`platformio.ini`** — 16 MB flash, `partitions_16mb.csv`, `ARDUINO_USB_MODE=1`
  + `ARDUINO_USB_CDC_ON_BOOT=1`. Still the pioarduino platform: `espressif32@6.9.0`
  cannot add octal PSRAM to the heap, and the N16R8 has the same OPI PSRAM the
  CrowPanel did.
- **`src/hw/io_expander.{h,cpp}`** — new, replaces `lib/PCA9557` (deleted).
- **`src/hw/display_hw.cpp`** — new pin map, 1024×600, Waveshare's timings.
  Backlight is no longer a LovyanGFX `Light_PWM`; it is a register write.
- **`src/hw/touch.cpp`** — `gt911_reset()` added. The GT911 latches its I2C
  address from INT at the moment RST is released, and RST is on the extender
  while INT is a GPIO, so both have to be driven by hand and in order.
- **`src/hw/sdcard.cpp`** — `SD` over SPI became `SD_MMC` 1-bit. There is no CS
  on a GPIO to give the SPI library, and the slot is wired for SDMMC anyway.
- **`src/ui/theme.h`** — `SCREEN_W/H` now come from `display_hw.h` instead of
  being a second copy. `CONTENT_H` grew from 256 px to 376.
- **`src/ui/view_expanded.cpp`** — canvas and log-line count derive from the
  screen size rather than being 800×400 and 13.

---

## Things a future session should not have to rediscover

- **The first `ioexp_write()` publishes all eight bits.** Seeding the shadow
  byte with `0xFF` sends `CAN_SEL` high, which hands the USB-C to the CAN
  transceiver and disconnects the port you flash and debug through.
- **Panel timings are Waveshare's, not a generic ST7262 table.** A 162-clock
  hsync pulse looks wrong and is correct for this panel.
- **PCLK is the tuning knob.** 30 MHz × 2 bytes is 60 MB/s out of PSRAM while
  LVGL writes to it. Tearing, shearing or a rolling band → drop
  `LCD_PCLK_HZ` in `display_hw.cpp` to 21 MHz first.
- **`Wire.begin(8, 9)` must run before `ioexp_init()`**, which must run before
  `display_init()` — the extender gates the VCOM rail and the backlight.
- **No IMU on this board.** The CrowPanel had an ICM-20948; the 7B does not.
  `imu_begin()` reports absent and the vibration guard stays inert until one is
  plugged into the I2C terminal. Intended, not a bug.
- **`touch.cpp` is adapted, not copied.** The hotkey project's version delayed
  LVGL's press report by 120 ms to tell taps from swipes and suppressed input
  after 30 px of movement. A jog key must register on contact.
- **Never chain `send_line()` calls at boot.** `fnc_send_line()` spins in
  `while (_ackwait)` until the previous line is acked or its 2000 ms timeout
  expires; with no controller attached that freezes the panel before the first
  frame is painted.
- **`handle_other_line()` must sit above the early returns** in `handle_other()`.
  The file-list reply is the `'{'` case that returns into `handle_json()`.
- **`myAxes` is the WORK position** — `show_dro()` has already subtracted WCO.
  Machine position is `myAxes + myWco`.
- **CNC-TW's jerk threshold is unsafe as written** (see below).

## A defect found in CNC-TW worth fixing there too

`/home/matthew/Desktop/CNC-TW` escalates to e-stop on **jerk alone**. Jerk is a
per-sample delta over the sample interval, so any vibration large enough to
reach the 0.5 g RMS hold threshold also produces jerk far above 50 g/s — at its
200 Hz sample rate a 0.5 g swing is already 100 g/s. The feed-hold tier is
therefore unreachable and every rough cut becomes an e-stop.

This port gates jerk on magnitude: it only counts when the deviation is also at
least half the peak threshold — an impact is fast **and** large.
`test_sustained_vibration_does_not_escalate_to_estop` pins the behaviour.

---

## Reference

| | |
|---|---|
| Spec | `docs/superpowers/specs/2026-08-08-cnc-console-design.md` |
| Plan + execution notes | `docs/superpowers/plans/2026-08-08-cnc-console.md` |
| Layout study | https://claude.ai/code/artifact/29f1b135-2fd7-40dc-b26b-bc20692e0f22 |
| Board wiki | https://www.waveshare.com/wiki/ESP32-S3-Touch-LCD-7B |
| Vendor demos | https://github.com/waveshareteam/ESP32-S3-Touch-LCD-7B |
| Build | `pio run -e ws7b` |
| Tests | `pio test -e native` (65 cases) |
| Repo | `https://git.yax.family/matthew/CNC-Disply` |

### Topology

```
Waveshare 7B ──UART 1M──► Airdale (passthrough) ──► Corgi (FluidNC)
```

The Airdale is a passthrough, not the controller. FluidNC runs on the Corgi, and
its SD card is unreachable inside a sealed box — which is why the panel's own
card is the G-code source.

### Layout: everything derives from the panel now

The port left the CrowPanel's constants in place and the extra 120 px showed as
dead space on every page. All of it is now computed from `CONTENT_H` / `SCREEN_H`
rather than fixed, so a future panel reflows on its own:

| Was | Now | Where |
|---|---|---|
| `NAV_VISIBLE 5` | 6 | `shell.cpp` — 5 exactly filled the 480px CrowPanel |
| `ROWS 3` (files) | 4 | `page_run.cpp` |
| `ROWS 5` (settings) | 8 | `page_diag.cpp` |
| `VISIBLE_ROWS 6` (WCS) | 9 | `page_offsets.cpp` — G54–G59 with no scrolling |
| `PAD = U*30` | `CONTENT_H - U*2` | `page_jog.cpp` |

The derivation reproduces every one of the old constants exactly when fed the
CrowPanel's 240px page — which is how we know they were stale rather than chosen.

**The DRO follows `n_axes` from FluidNC** instead of clamping to 3, so the Corgi's
A axis appears on its own. Readout font steps 40 → 28 → 20 px as cells narrow,
picked off cell width, since a 40px `-1234.567` clips at four columns.

### Still open

- **RS485 on GPIO 15/16 is unused.** It is the better long-cable link to the
  machine if the Corgi end ever gets a transceiver.
- ~~**`corgi_config.yaml:184`** passthrough baud mismatch~~ — **not a mismatch.**
  `passthrough_baud`/`passthrough_mode` are read only by `Uart::enterPassthrough()`
  (`Uart.cpp:99`), reached only via the `$Uart/Passthrough` command, which
  forwards firmware uploads through the Corgi to a downstream MCU. Normal pendant
  traffic uses `uart2`'s own `baud: 1000000` / `mode: 8N1` — exactly what
  `transport.cpp:12` probes first. 57600/8E1 is the Airedale's reflash rate and
  should stay.
- **The keyboard is a singleton** — `w_keyboard()` returns one object and both
  `page_diag.cpp` and `page_setup.cpp` used to attach their own `kb_done_cb` to
  it. Setup's is gone with the WiFi fields; if a second page ever needs the
  keyboard, the handlers will fight.
- **LVGL's shift key is labelled `ABC`**, bottom-left of the second row. Not
  discoverable. Custom keymaps would fix it, ~20 lines.
- **CNC-TW still escalates to e-stop on jerk alone** (see above). Not fixed
  there. Its `smoothed_peak`, `rms_rate` and `margin` feed a 5-level feed-override
  ladder this panel does not have — only `smoothed_peak` was ported.
- **`xtensa/config/core.h` includes `"../hal.h"`, which does not exist.** GCC
  survives on search-path fallback; clangd does not, so every file reaching
  `<Arduino.h>` shows one editor-only error. The build is unaffected.
