NoobyNull/CNC-Display/cad/lean_to_mount_template.pdf

## Lean-to - table drill template (PRINT AT 100% SCALE, Letter landscape)

Seen from above. Bottom edge of the dashed outline = FRONT (operator side).

4 x 1/4-20, drill at the crosshairs. Circles = the part’s 6.8 mm holes.

Centres 181.26 mm across, 48.10 mm front to back; front pair 10.6 mm behind the front edge.

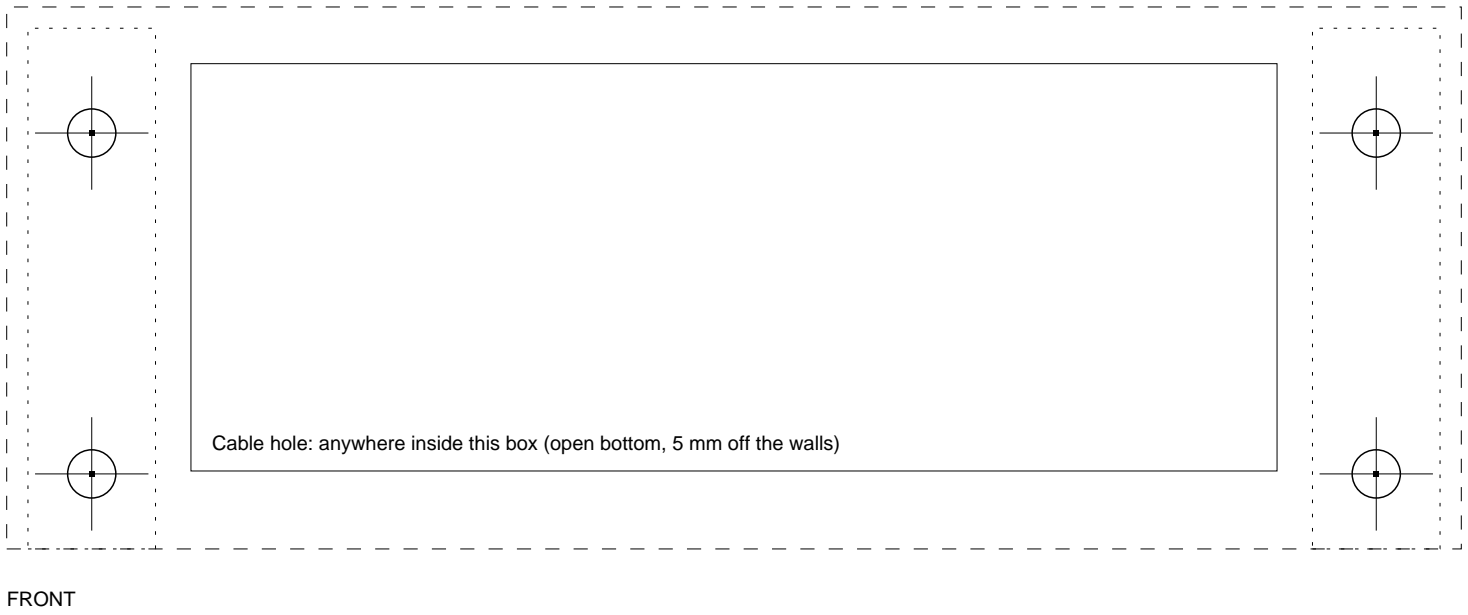
[picture p21: figure]
FRONT

Cable hole: anywhere inside this box (open bottom, 5 mm off the walls)

= 100.0 mm exactly, or the print is scaled

Check against the printed shell before drilling: it should sit on the dashed outline.
