NoobyNull/CNC-Display/cad/switch_plate_template.pdf

## Corgi switch plate - wood cutout template (PRINT AT 100% SCALE)

Solid line = cut line, 149 x 99 mm, slop included. Dashed = finished plate footprint.

= 100.0 mm exactly, or the print is scaled

Corners: R4 or tighter; square corners are fine (extra clearance).
