NoobyNull/CNC-Display/cad/renders/arm-joint-section.png

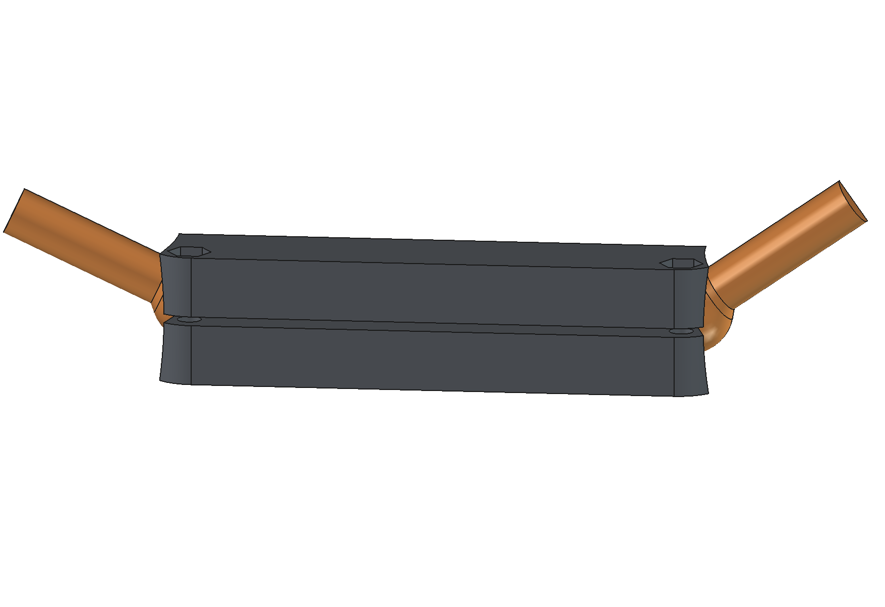
cad/renders/arm-joint-section.png
