NoobyNull/CNC-Display/cad/renders/arm-tray.png

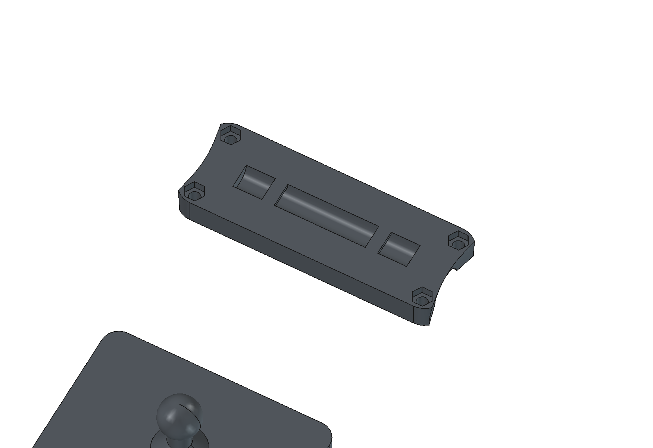
cad/renders/arm-tray.png
