NoobyNull/CNC-Display/cad/renders/back-vesa-face.png

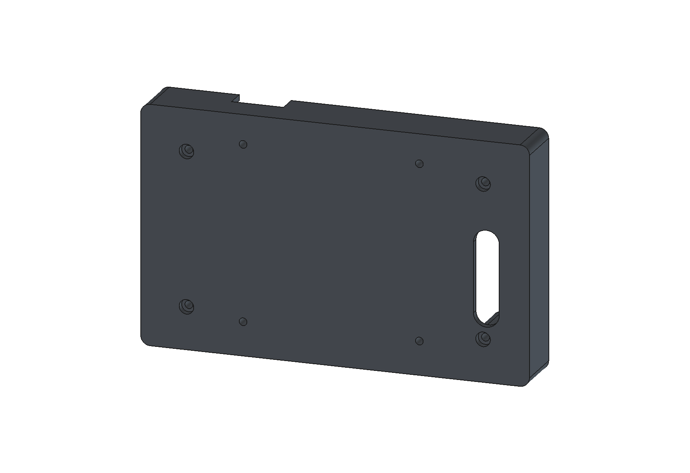
cad/renders/back-vesa-face.png
