NoobyNull/CNC-Display/cad/renders/cable-route.png

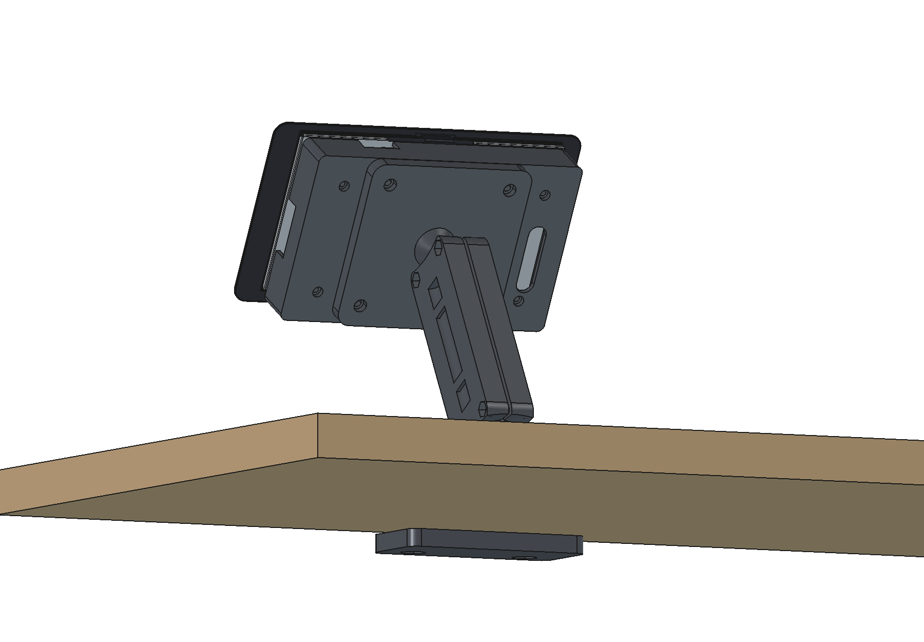
cad/renders/cable-route.png
