NoobyNull/CNC-Display/cad/renders/fitted.png

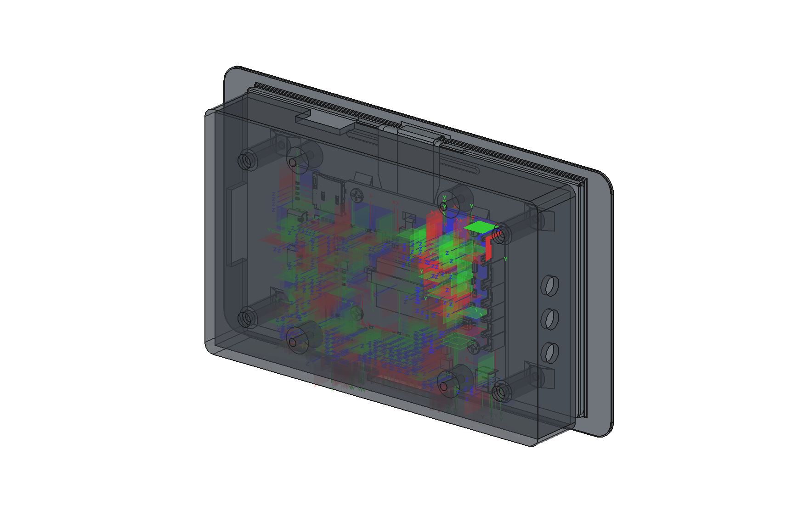
cad/renders/fitted.png
