NoobyNull/CNC-Display/cad/renders/inside.png

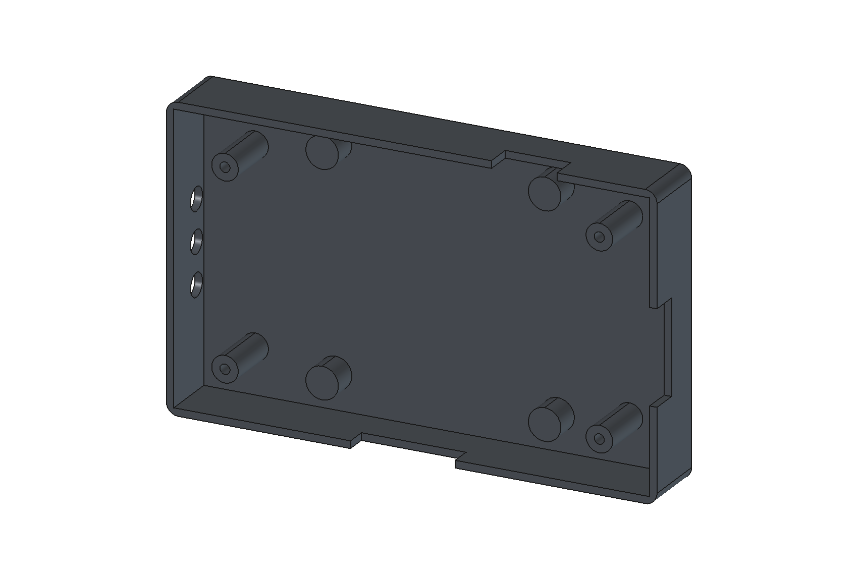
cad/renders/inside.png
