NoobyNull/CNC-Display/cad/renders/arm-parts.png

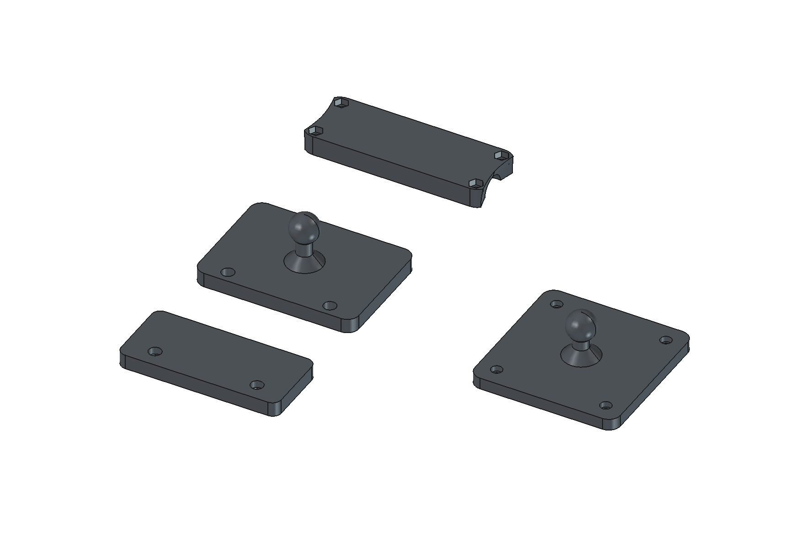
cad/renders/arm-parts.png
