NoobyNull/CNC-Display/cad/switch_plate_print.3mf

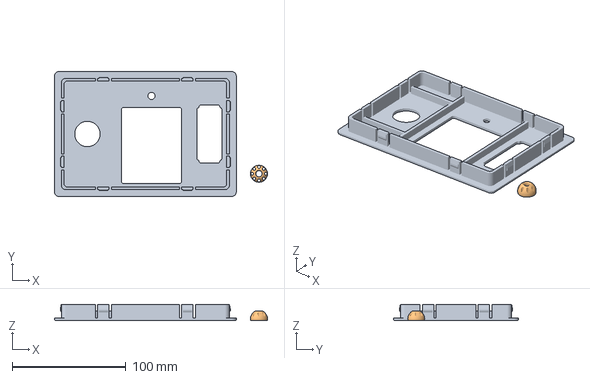
[picture p29: CAD file, 2026-10-01]
cad/switch_plate_print.3mf
187.5 x 110.0 x 14.4 mm
