NoobyNull/CNC-Display/cad/lean_to.step

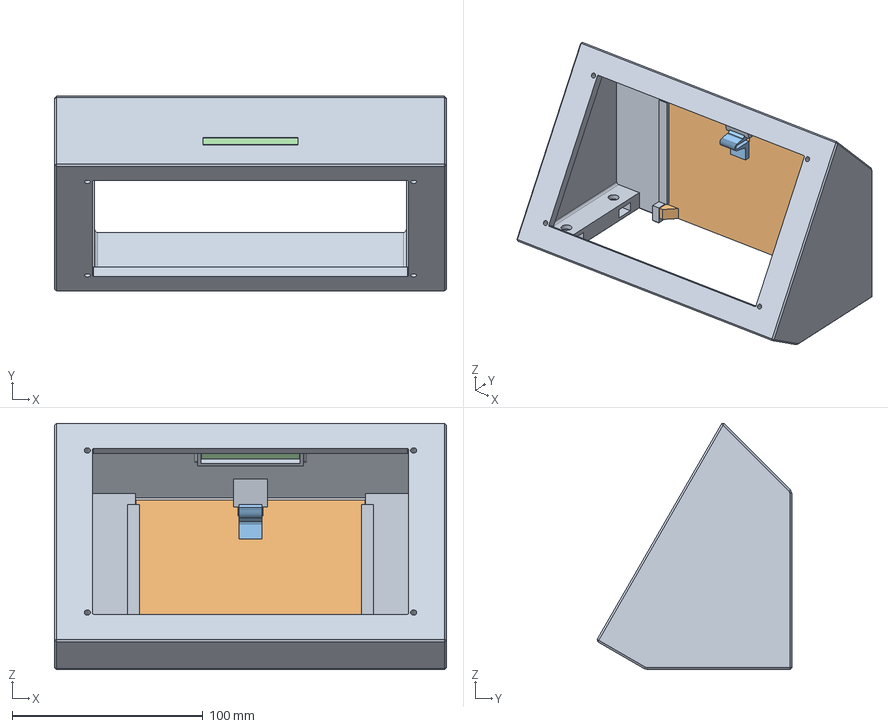
[picture p30: CAD file, 2026-10-01]
cad/lean_to.step
205.3 x 102.0 x 128.9 mm
