NoobyNull/CNC-Display/cad/switch_plate.step

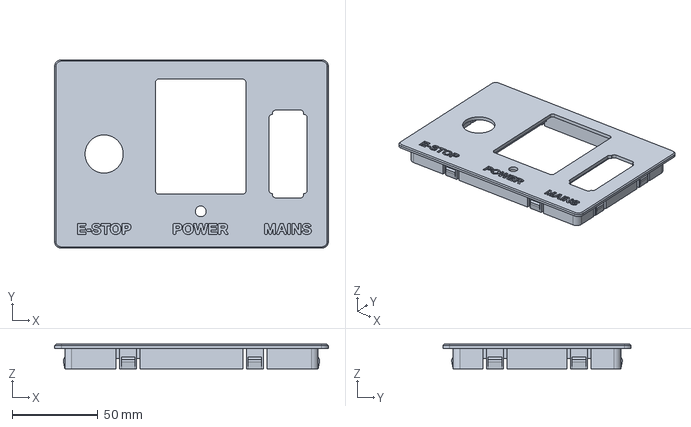
[picture p31: CAD file, 2026-09-07]
cad/switch_plate.step
160.0 x 110.0 x 14.4 mm
