NoobyNull/CNC-Display/cad/estop_box.step

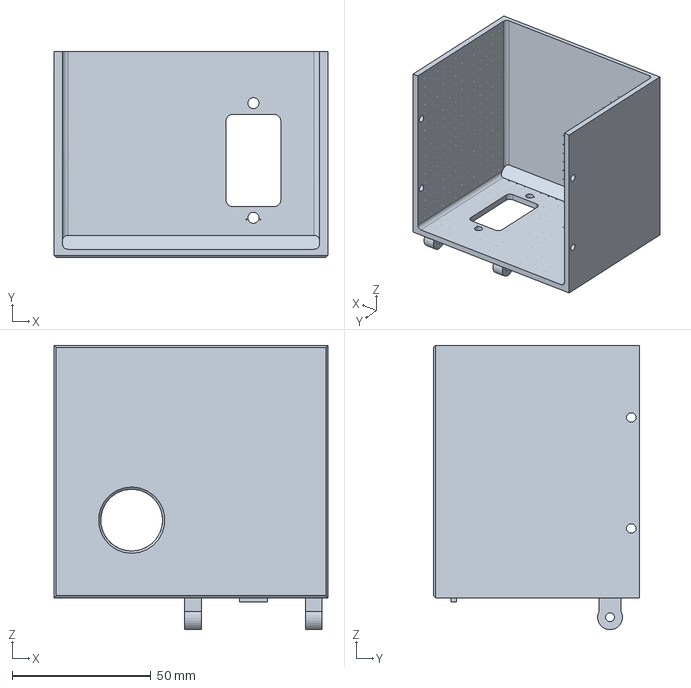
[picture p32: CAD file, 2026-08-23]
cad/estop_box.step
98.8 x 74.3 x 102.5 mm
