NoobyNull/CNC-Display/cad/psu_post.step

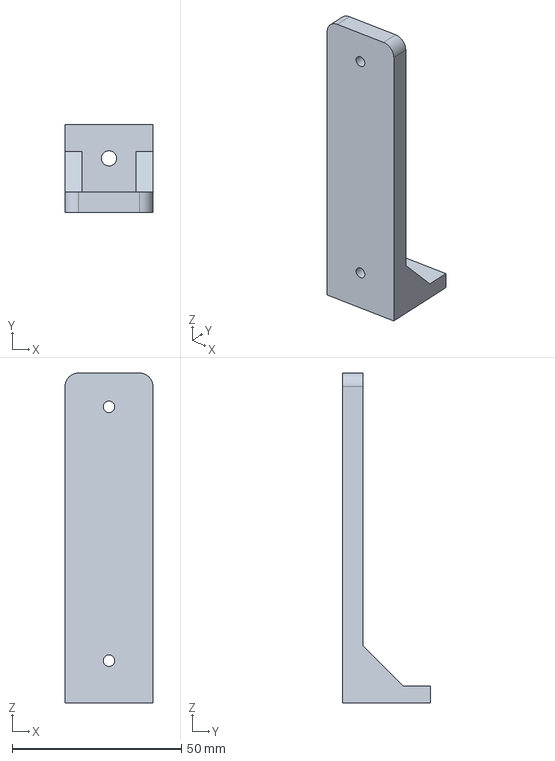
[picture p33: CAD file, 2026-08-23]
cad/psu_post.step
26.0 x 26.0 x 97.5 mm
