NoobyNull/CNC-Display/cad/psu_plate.step

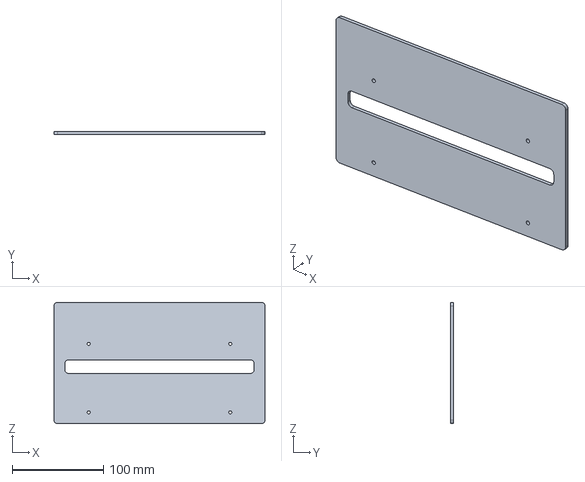
[picture p34: CAD file, 2026-08-23]
cad/psu_plate.step
231.0 x 3.00 x 133.0 mm
