NoobyNull/CNC-Display/cad/advance_plate.step

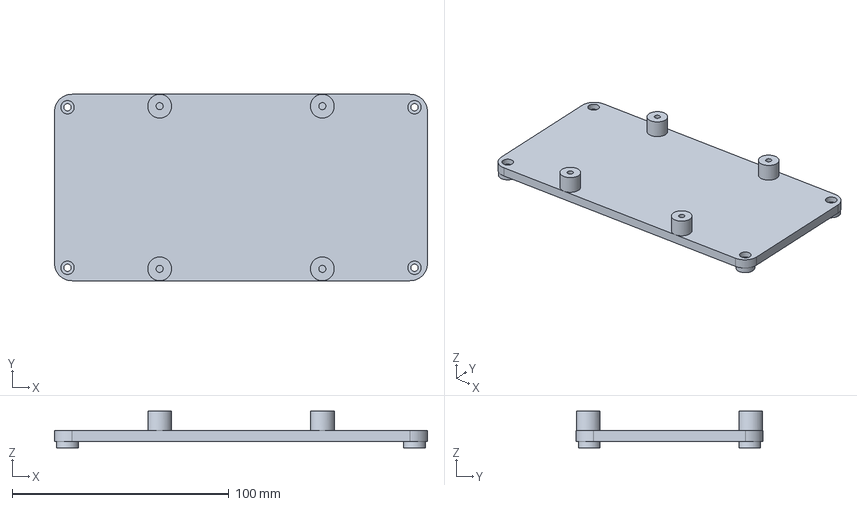
[picture p35: CAD file, 2026-08-22]
cad/advance_plate.step
172.0 x 86.0 x 17.0 mm
