NoobyNull/CNC-Display/cad/cabinet_lid.step

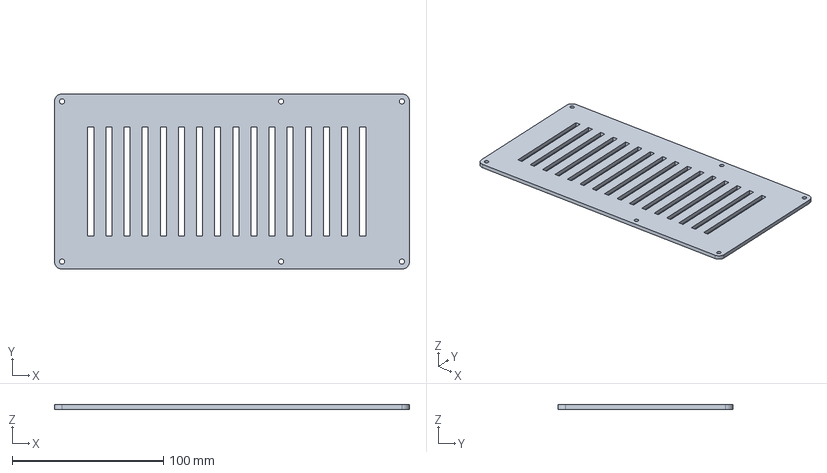
[picture p36: CAD file, 2026-08-22]
cad/cabinet_lid.step
234.9 x 116.0 x 3.00 mm
