NoobyNull/CNC-Display/cad/cabinet_tray.step

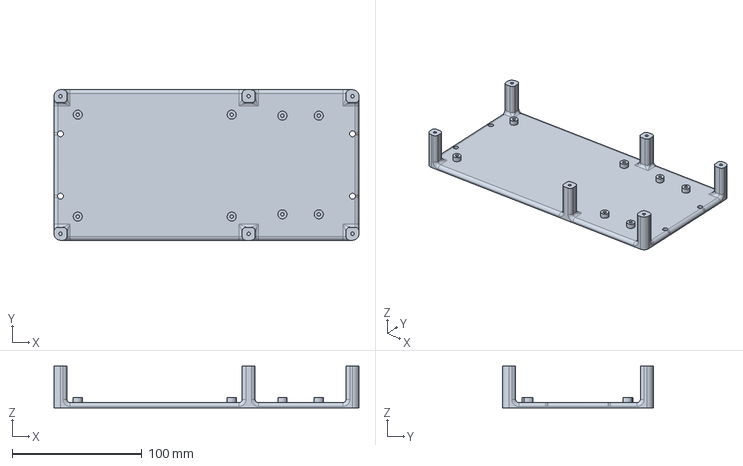
[picture p37: CAD file, 2026-08-22]
cad/cabinet_tray.step
234.9 x 116.0 x 32.0 mm
