NoobyNull/CNC-Display/cad/arm_armhalf.step

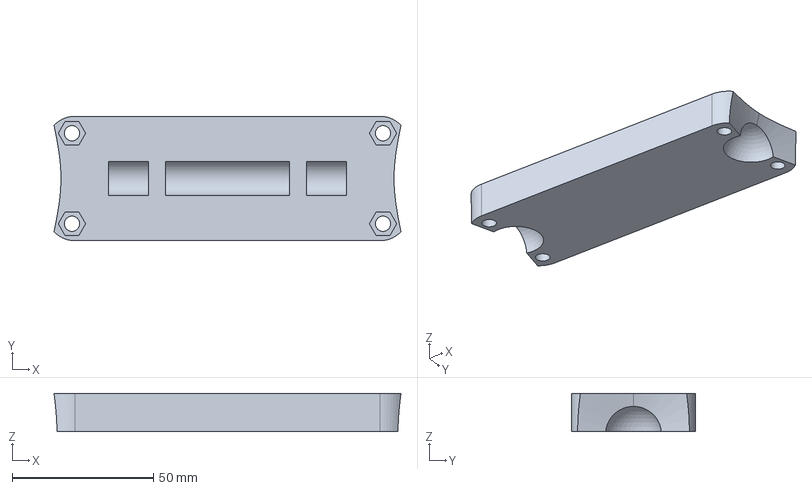
[picture p38: CAD file, 2026-08-21]
cad/arm_armhalf.step
122.7 x 44.0 x 13.5 mm
