NoobyNull/CNC-Display/cad/arm_vesaplate.step

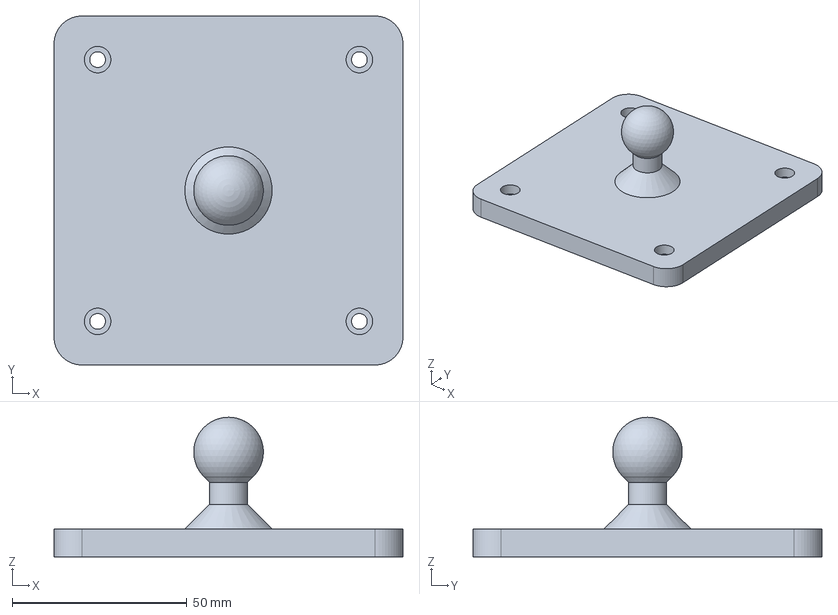
[picture p39: CAD file, 2026-08-21]
cad/arm_vesaplate.step
100.0 x 100.0 x 40.0 mm
