NoobyNull/CNC-Display/cad/back_cover.step

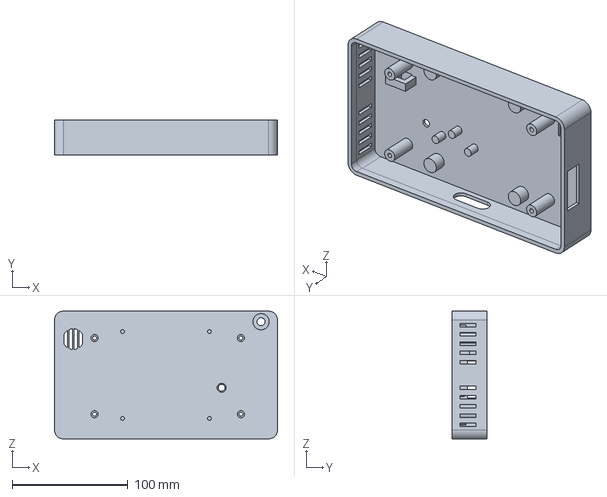
[picture p40: CAD file, 2026-08-21]
cad/back_cover.step
192.4 x 30.4 x 110.2 mm
