NoobyNull/CNC-Display/cad/arm_baseplate.step

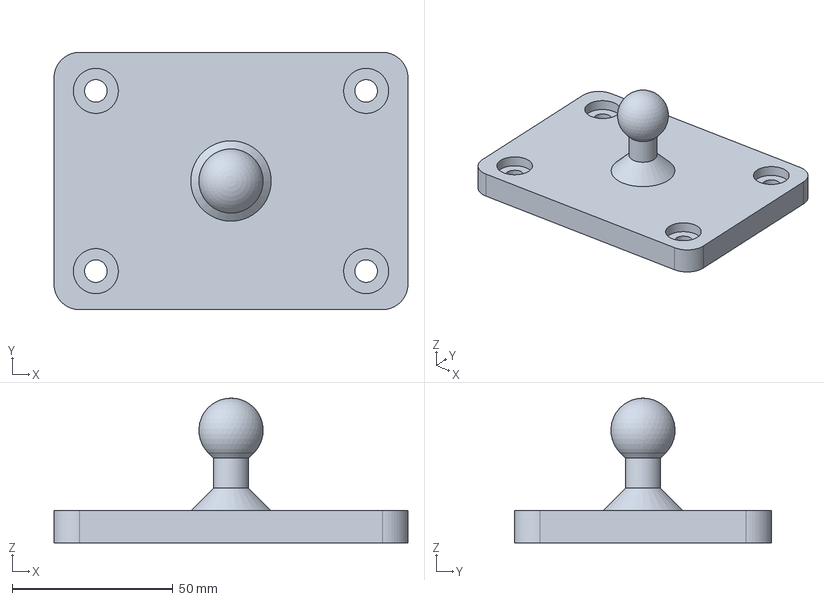
[picture p41: CAD file, 2026-08-21]
cad/arm_baseplate.step
110.0 x 80.0 x 45.0 mm
