NoobyNull/CNC-Display/cad/arm_clampbar.step

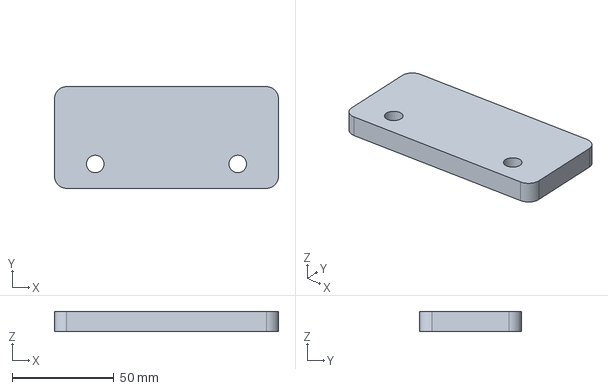
[picture p42: CAD file, 2026-08-11]
cad/arm_clampbar.step
110.0 x 50.0 x 10.0 mm
