NoobyNull/CNC-Display/(list of files, cad)

Other CAD files:
lean_to.FCStd
