NoobyNull/CNC-Display/cad/renders/assembled-side.png

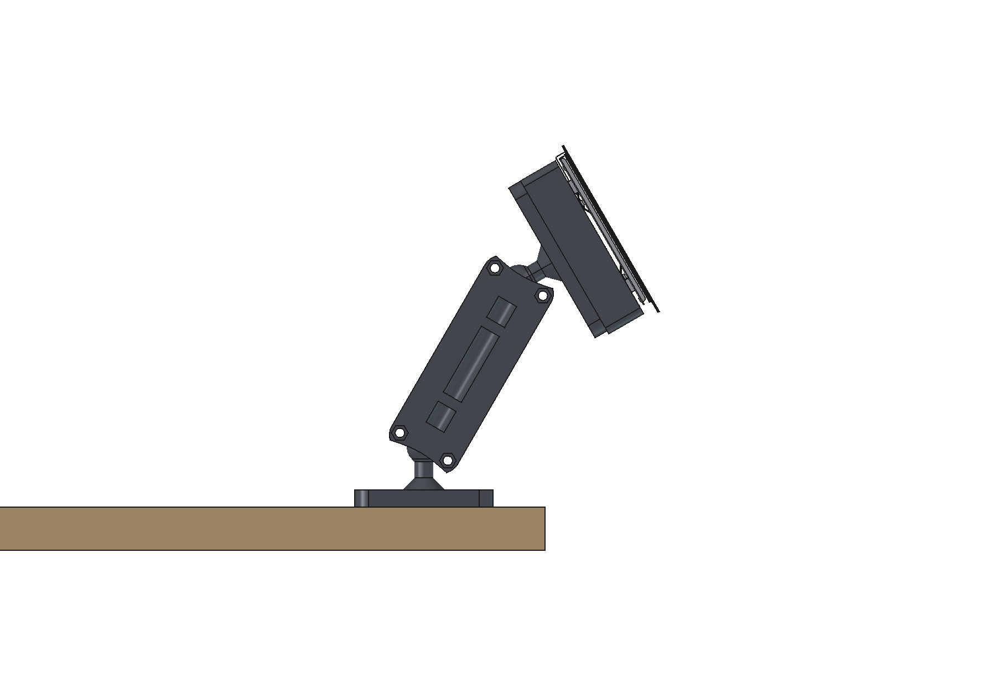
cad/renders/assembled-side.png
