NoobyNull/CNC-Display/cad/renders/assembled.png

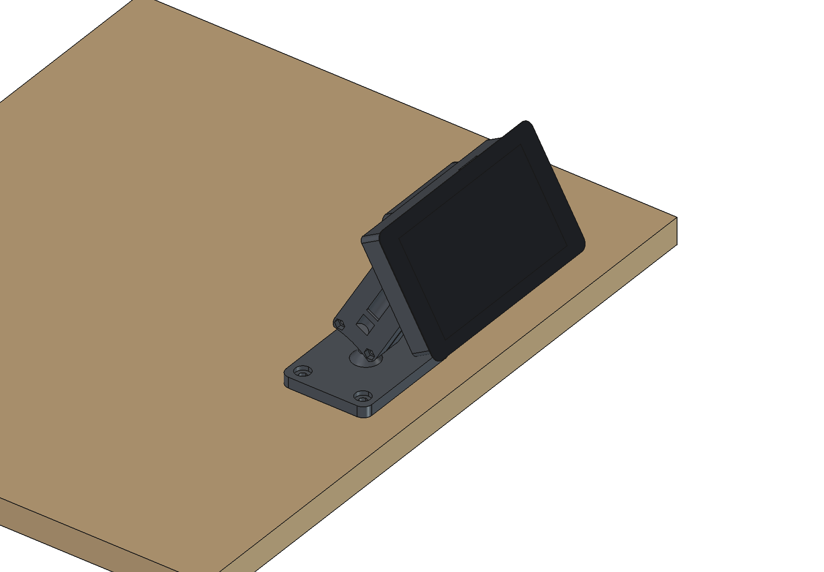
cad/renders/assembled.png
