NoobyNull/CNC-Display/cad/renders/assembly_front.png

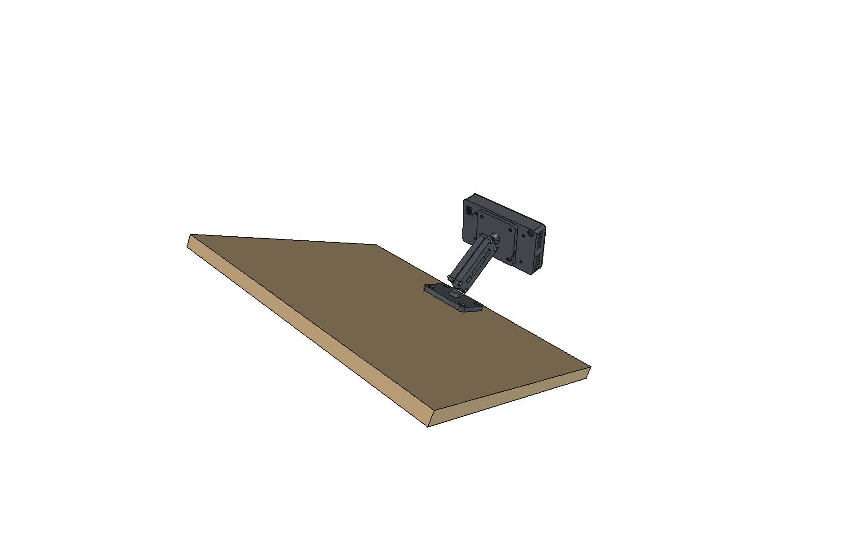
cad/renders/assembly_front.png
