NoobyNull/CNC-Display/cad/renders/assembly_interior.png

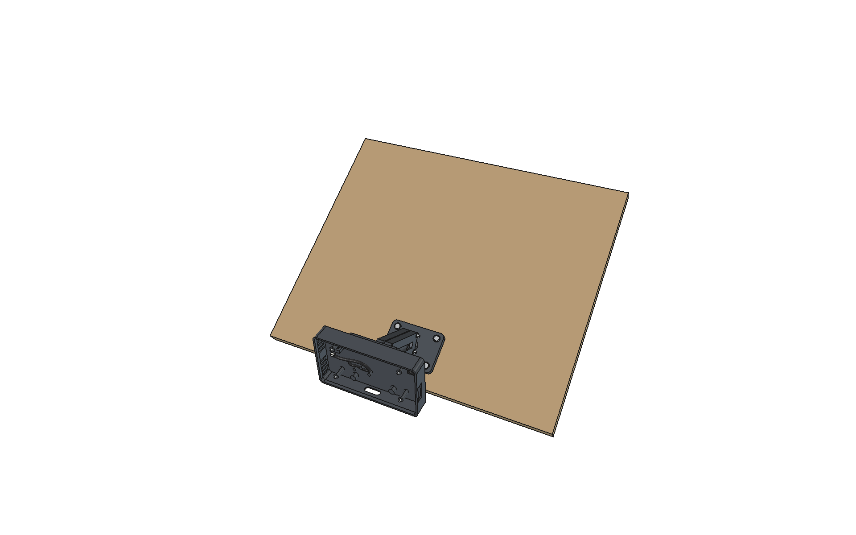
cad/renders/assembly_interior.png
