NoobyNull/CNC-Display/cad/renders/assembly_rear.png

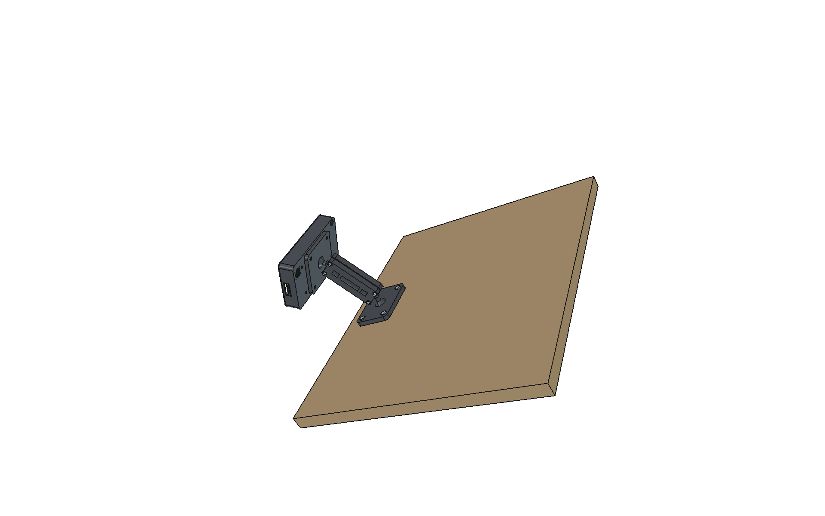
cad/renders/assembly_rear.png
