NoobyNull/CNC-Display/src/model/caps.cpp

#include "model/calibration.h"
#include "model/config_store.h"
#include <ctype.h>
#include "model/caps.h"
#include "model/fnc_settings.h"
#include "model/FluidNCModel.h"
#include <string.h>
#include <stdio.h>
#include <stdlib.h>

static cap_state_t s_homing      = CAP_UNKNOWN;
static cap_state_t s_hard_limits = CAP_UNKNOWN;
static cap_state_t s_soft_limits = CAP_UNKNOWN;
static cap_state_t s_probe       = CAP_UNKNOWN;
static cap_state_t s_toolsetter  = CAP_UNKNOWN;
static cap_state_t s_flood       = CAP_UNKNOWN;
static cap_state_t s_mist        = CAP_UNKNOWN;
static cap_state_t s_door        = CAP_UNKNOWN;
static cap_state_t s_estop       = CAP_UNKNOWN;

static uint32_t s_gen = 0;
static bool     s_settled = false;

static size_t s_mcount = 0;
static char   s_mname[CAPS_MACRO_MAX][CAPS_MACRO_NAME_MAX];
static char   s_mbody[CAPS_MACRO_MAX][CAPS_MACRO_NAME_MAX];
static int    s_mtlo = -1;
static caps_atc_t s_atc = CAPS_ATC_NONE;

struct axis_t {
    char  letter;
    float v[CAPS_FIELD_COUNT];
    bool  seen;
};
static axis_t s_axes[CAPS_MAX_AXES];
static int    s_naxes = 0;

// $CD scan state: which top-level YAML section the scanner is inside.
static bool     s_dumping  = false;   // $CD sent, reply not finished
static bool     s_started  = false;   // the YAML itself has begun arriving
static uint32_t s_deadline = 0;       // give up waiting for it to begin
static char     s_section[24] = "";
static int      s_axis = -1;            // axis whose block we are inside, within axes:
static float    s_ax_rate[6], s_ax_travel[6];

float caps_axis_max_rate(int a)   { return a >= 0 && a < 6 ? s_ax_rate[a] : 0.0f; }
float caps_axis_max_travel(int a) { return a >= 0 && a < 6 ? s_ax_travel[a] : 0.0f; }

// What the config uses each ESP32 GPIO for, e.g. 32 -> "x/motor0/limit_neg
// (pu low)". Built from the same $CD dump by tracking the YAML key path, so it
// follows whatever config the controller runs. Labels Diag's $GD output.
static const int CAPS_GPIO_MAX = 49;
static char s_gpio_role[CAPS_GPIO_MAX][44];
static char s_path[6][24];                 // key per indent level (2 spaces)
static uint16_t s_hlmask = 0;

static void note_pin_role(const char* line) {
    int indent = 0;
    while (line[indent] == ' ') indent++;
    const char* k = line + indent;
    if (*k == '-' || *k == '#') return;
    const char* colon = strchr(k, ':');
    if (!colon) return;
    const int depth = indent / 2;
    if (depth >= 6) return;
    size_t kl = (size_t)(colon - k);
    if (kl >= sizeof(s_path[0])) kl = sizeof(s_path[0]) - 1;
    memcpy(s_path[depth], k, kl);
    s_path[depth][kl] = 0;

    const char* v = colon + 1;
    while (*v == ' ' || *v == '\'' || *v == '"') v++;   // YAML writers may quote "a:b"
    // axes/<x>/motor<n>/hard_limits: true -> bit axis*2+n
    if (depth == 3 && strcmp(s_path[0], "axes") == 0 && strcmp(s_path[3], "hard_limits") == 0 &&
        strncmp(s_path[2], "motor", 5) == 0 && strncasecmp(v, "true", 4) == 0) {
        const char* ax = strchr("xyzabc", tolower((unsigned char)s_path[1][0]));
        const int   m  = s_path[2][5] - '0';
        if (ax && s_path[1][0] && (m == 0 || m == 1)) s_hlmask |= (uint16_t)(1u << ((ax - "xyzabc") * 2 + m));
    }
    if (strncmp(v, "gpio.", 5) != 0) return;
    char* end;
    const long n = strtol(v + 5, &end, 10);
    if (end == v + 5 || n < 0 || n >= CAPS_GPIO_MAX) return;

    // "axes/x/motor0/limit_neg_pin" -> "x/motor0/limit_neg"
    char role[44] = "";
    for (int d = 0; d <= depth; d++) {
        if (d == 0 && strcmp(s_path[0], "axes") == 0) continue;
        if (role[0]) strncat(role, "/", sizeof(role) - strlen(role) - 1);
        strncat(role, s_path[d], sizeof(role) - strlen(role) - 1);
    }
    const size_t rl = strlen(role);
    if (rl > 4 && strcmp(role + rl - 4, "_pin") == 0) role[rl - 4] = 0;
    // Attributes (":pu:low") in brackets, colons as spaces.
    if (*end == ':') {
        char attrs[16];
        snprintf(attrs, sizeof(attrs), "%s", end + 1);
        for (char* c = attrs; *c; c++) {
            if (*c == ':') *c = ' ';
            if (*c == '\'' || *c == '"') { *c = 0; break; }
        }
        snprintf(s_gpio_role[n], sizeof(s_gpio_role[n]), "%s (%s)", role, attrs);
    } else {
        snprintf(s_gpio_role[n], sizeof(s_gpio_role[n]), "%s", role);
    }
}

const char* caps_gpio_role(int gpio) {
    if (gpio < 0 || gpio >= CAPS_GPIO_MAX || !s_gpio_role[gpio][0]) return nullptr;
    return s_gpio_role[gpio];
}

static const char* AXIS_LETTERS = "XYZABC";

void caps_reset() {
    s_axis = -1;
    for (int i = 0; i < 6; i++) s_ax_rate[i] = s_ax_travel[i] = 0.0f;
    s_homing = s_hard_limits = s_soft_limits = CAP_UNKNOWN;
    s_probe = s_toolsetter = s_flood = s_mist = CAP_UNKNOWN;
    s_door = s_estop = CAP_UNKNOWN;
    s_naxes = 0;
    memset(s_axes, 0, sizeof(s_axes));
    s_dumping = false;
    s_section[0] = 0;
    s_settled = false;
    s_mcount = 0;
    s_gen++;
}

uint32_t caps_generation() { return s_gen; }
bool     caps_settled()    { return s_settled; }

size_t      caps_macro_count() { return s_mcount; }
const char* caps_macro_name(size_t i) { return i < s_mcount ? s_mname[i] : ""; }
const char* caps_macro_body(size_t i) { return i < s_mcount ? s_mbody[i] : ""; }
int         caps_tlo_macro() { return s_mtlo; }
caps_atc_t  caps_atc() { return s_atc; }
uint16_t    caps_hard_limit_mask() { return s_hlmask; }
int caps_macro_num(size_t i) {
    const char* n = caps_macro_name(i);            // "Macro0".."Macro3"
    if (strlen(n) != 6 || strncasecmp(n, "Macro", 5) != 0) return -1;
    return (n[5] >= '0' && n[5] <= '3') ? n[5] - '0' : -1;   // FluidNC has four slots
}

// A macro that runs a file named tlo_measure (the SD-card convention here:
// Macro1 = $SD/Run=/sd/.macros/tlo_measure.nc) applies the length offset
// inside the file, where the config text cannot show it.
static bool names_tlo_measure(const char* b) {
    static const char KEY[] = "tlo_measure";
    for (; *b; b++)
        if (strncasecmp(b, KEY, sizeof(KEY) - 1) == 0) return true;
    return false;
}

static bool applies_tlo(const char* b) {
    if (names_tlo_measure(b)) return true;
    static const char PAT[] = "G43.1Z";
    for (; *b; b++) {
        const char* p = b;
        size_t k = 0;
        while (*p && PAT[k]) {
            if (*p == ' ') { p++; continue; }
            if (toupper((unsigned char)*p) != PAT[k]) break;
            p++; k++;
        }
        if (PAT[k]) continue;
        while (*p == ' ') p++;
        if (*p == '#' || *p == '[') return true;
    }
    return false;
}

cap_state_t caps_homing()      { return s_homing; }
cap_state_t caps_probe()       { return s_probe; }
cap_state_t caps_toolsetter()  { return s_toolsetter; }
cap_state_t caps_flood()       { return s_flood; }
cap_state_t caps_mist()        { return s_mist; }
cap_state_t caps_hard_limits() { return s_hard_limits; }
cap_state_t caps_soft_limits() { return s_soft_limits; }
cap_state_t caps_safety_door() { return s_door; }
cap_state_t caps_estop()       { return s_estop; }

const char* caps_why(cap_state_t c, const char* what) {
    if (c != CAP_ABSENT) return nullptr;
    static char b[64];
    snprintf(b, sizeof(b), "no %s configured", what ? what : "hardware");
    return b;
}

// --- $S half ---------------------------------------------------------------

static const char* setting_value(const char* name) {
    for (size_t i = 0; i < fncset_count(); i++) {
        const fnc_setting_t* s = fncset_at(i);
        if (s && strcmp(s->name, name) == 0) return s->value;
    }
    return nullptr;
}

static cap_state_t bool_setting(const char* name) {
    const char* v = setting_value(name);
    if (!v) return CAP_UNKNOWN;
    return (v[0] == '0' && v[1] == 0) ? CAP_ABSENT : CAP_PRESENT;
}

void caps_refresh_from_settings() {
    // Homing: FluidNC reports 0 when no axis declares a homing cycle, which is
    // exactly the bring-up Corgi's state. $H answers error:5 there.
    s_homing      = bool_setting("Grbl/HomingCycleEnable");
    s_hard_limits = bool_setting("Grbl/HardLimitsEnable");
    s_soft_limits = bool_setting("Grbl/SoftLimitsEnable");

    s_naxes = 0;
    memset(s_axes, 0, sizeof(s_axes));
    for (int i = 0; AXIS_LETTERS[i]; i++) {
        char name[32];
        bool any = false;
        axis_t a{};
        a.letter = AXIS_LETTERS[i];
        for (int f = 0; f < CAPS_FIELD_COUNT; f++) {
            snprintf(name, sizeof(name), "Grbl/%s/%c", caps_field_name((caps_field_t)f), a.letter);
            const char* v = setting_value(name);
            if (v) { a.v[f] = strtof(v, nullptr); any = true; }
        }
        // An axis exists in $S only if the controller has one configured, so
        // presence of any of its four keys is the axis count.
        if (any && s_naxes < CAPS_MAX_AXES) {
            a.seen = true;
            s_axes[s_naxes++] = a;
        }
    }
    s_gen++;
}

void caps_poll() {
    // The settings table only ever grows within a dump, so its size is a
    // sufficient change signal — and unlike fncset_dirty_take() it can be read
    // by any number of consumers.
    static size_t last = (size_t)-1;
    size_t n = fncset_count();
    if (n != last) {
        last = n;
        caps_refresh_from_settings();
    }

    // A $CD that never produced a dump must not leave the scanner armed
    // forever, or a stray YAML-shaped console line months later would be read
    // as configuration. Firmware without $CD leaves every pin CAP_UNKNOWN,
    // which keeps the affected controls enabled.
    if (s_dumping && !s_started && (int32_t)(milliseconds() - s_deadline) > 0) {
        s_dumping = false;
        s_probe = s_toolsetter = s_flood = s_mist = CAP_UNKNOWN;
        s_door = s_estop = CAP_UNKNOWN;
        s_settled = true;      // gave up: the splash gate must not wait for ever
        s_gen++;
    }
}

int  caps_axis_count() { return s_naxes; }
char caps_axis_letter(int i) { return (i >= 0 && i < s_naxes) ? s_axes[i].letter : '?'; }

float caps_axis_value(caps_field_t f, int i) {
    if (i < 0 || i >= s_naxes || f < 0 || f >= CAPS_FIELD_COUNT) return 0.0f;
    return s_axes[i].v[f];
}

float caps_axis_steps(int i)  { return caps_axis_value(CAPS_STEPS, i); }
float caps_axis_rate(int i)   { return caps_axis_value(CAPS_RATE, i); }
float caps_axis_accel(int i)  { return caps_axis_value(CAPS_ACCEL, i); }
float caps_axis_travel(int i) { return caps_axis_value(CAPS_TRAVEL, i); }

const char* caps_field_name(caps_field_t f) {
    switch (f) {
        case CAPS_STEPS:  return "Resolution";
        case CAPS_RATE:   return "MaxRate";
        case CAPS_ACCEL:  return "Acceleration";
        case CAPS_TRAVEL: return "MaxTravel";
        default:          return "";
    }
}

const char* caps_setting_for(caps_field_t f, int axis) {
    static char b[32];
    snprintf(b, sizeof(b), "Grbl/%s/%c", caps_field_name(f), caps_axis_letter(axis));
    return b;
}

// --- $CD half --------------------------------------------------------------

void caps_request_config() {
    cfg_clear();
    s_dumping  = true;
    s_started  = false;
    s_deadline = (uint32_t)milliseconds() + 15000;
    s_section[0] = 0;
    // Assume absent, then let the dump prove otherwise: a configured pin always
    // appears in the dump, a missing one never does, so "absent" could not be
    // reached by waiting for a line that will not come.
    s_probe = s_toolsetter = s_flood = s_mist = CAP_ABSENT;
    s_door = s_estop = CAP_ABSENT;
    s_mcount = 0;              // empty slots are the common case, dump proves otherwise
    s_mtlo = -1;
    s_hlmask = 0;
    s_atc = CAPS_ATC_NONE;
    memset(s_gpio_role, 0, sizeof(s_gpio_role));
    send_line("$CD");
}

// "NO_PIN", empty, or absent all mean not configured.
static bool pin_set(const char* v) {
    if (!v) return false;
    while (*v == ' ') v++;
    if (!*v) return false;
    // Values can be quoted when they carry modifiers: 'I2SO.4:low'.
    if (*v == '\'' || *v == '"') v++;
    return strncasecmp(v, "NO_PIN", 6) != 0;
}

// Value after "key:" on a YAML line, or nullptr if this line is not that key.
static const char* yaml_value(const char* line, const char* key) {
    const char* p = line;
    while (*p == ' ') p++;
    size_t n = strlen(key);
    if (strncmp(p, key, n) != 0 || p[n] != ':') return nullptr;
    p += n + 1;
    while (*p == ' ') p++;
    return p;
}

// The dump's terminator. GrblParserC swallows "ok"/"error:N" (show_ok /
// show_error) before handle_other ever sees them, so without this call the
// scanner never learned the dump had ended: s_dumping stayed set for the whole
// session and swallowed every plain reply line after it -- $GD's GPIO dump
// arrived as a bare "ok" -- and caps never settled. Only a dump whose YAML has
// actually started is ended: $CD is queued behind other commands, whose own
// oks arrive first.
void caps_reply_end() {
    if (!s_dumping || !s_started) return;
    s_dumping = false;
    s_settled = true;
    s_gen++;
}

bool caps_feed_line(const char* line) {
    if (!s_dumping || !line || !*line) return false;

    // A config dump is YAML and contains none of these. Letting them through
    // rather than swallowing them means a mis-timed dump flag can never cost
    // the settings table, the console or the DRO their data — it only costs
    // this scanner a capability it will re-read on the next dump.
    if (line[0] == '$' || line[0] == '[' || line[0] == '<' || line[0] == '{') return false;

    // A top-level key (unindented, ends in ':') opens a section. Everything
    // else is read relative to whichever section is open, which is what makes
    // 'pin:' under 'probe:' distinguishable from any other 'pin:'.
    bool top = (line[0] != ' ' && line[0] != '\t' && line[0] != '#' && strchr(line, ':'));

    // Until the YAML actually starts, nothing is consumed and no terminator is
    // honoured. $CD is queued alongside $#, $S and the file list, and their
    // replies each end in their own "ok" — treating the first one seen as the
    // end of the config dump is what previously left every pin unread.
    if (!s_started) {
        if (!top) return false;
        s_started = true;
    }

    // FluidNC terminates command output with ok / error. Anything after that
    // belongs to the console again. (On the panel the parser consumes those
    // itself and reports them through caps_reply_end(); matching them here
    // covers a feed that passes them through.)
    if (strcmp(line, "ok") == 0 || strncmp(line, "error", 5) == 0) {
        caps_reply_end();
        return true;
    }

    note_pin_role(line);
    cfg_feed_line(line);   // the whole tree, for any screen to look up

    if (top) {
        const char* colon = strchr(line, ':');
        size_t n = (size_t)(colon - line);
        if (n >= sizeof(s_section)) n = sizeof(s_section) - 1;
        memcpy(s_section, line, n);
        s_section[n] = 0;
        s_axis = -1;
        return true;
    }

    // axes: / x: / steps_per_mm: ... Two-space keys that are one letter open an
    // axis block; deeper keys (motor0: and friends) are not the axis's own.
    if (strcmp(s_section, "axes") == 0) {
        int ind = 0;
        while (line[ind] == ' ') ind++;
        const char* k = line + ind;
        if (ind == 2 && k[1] == ':' ) {
            const char* ax = strchr("xyzabc", k[0] | 0x20);
            s_axis = (ax && *ax) ? (int)(ax - "xyzabc") : -1;
        } else if (ind == 4 && s_axis >= 0) {
            const char* av;
            if ((av = yaml_value(line, "steps_per_mm")))       cal_set_steps(s_axis, (float)atof(av));
            if ((av = yaml_value(line, "max_rate_mm_per_min"))) s_ax_rate[s_axis]   = (float)atof(av);
            if ((av = yaml_value(line, "max_travel_mm")))       s_ax_travel[s_axis] = (float)atof(av);
        }
    }

    const char* v;
    // Under whichever section names the spindle, so matched by key alone. An
    // atc wins, as it does in Spindle::tool_change().
    if ((v = yaml_value(line, "m6_macro")) && s_atc == CAPS_ATC_NONE && *v && *v != '\'' && *v != '"') s_atc = CAPS_ATC_MACRO;
    if ((v = yaml_value(line, "atc")) && *v && *v != '\'' && *v != '"') s_atc = CAPS_ATC_MANUAL;
    if (strcmp(s_section, "probe") == 0) {
        if ((v = yaml_value(line, "pin")))            s_probe      = pin_set(v) ? CAP_PRESENT : CAP_ABSENT;
        if ((v = yaml_value(line, "toolsetter_pin"))) s_toolsetter = pin_set(v) ? CAP_PRESENT : CAP_ABSENT;
    } else if (strcmp(s_section, "coolant") == 0) {
        if ((v = yaml_value(line, "flood_pin"))) s_flood = pin_set(v) ? CAP_PRESENT : CAP_ABSENT;
        if ((v = yaml_value(line, "mist_pin")))  s_mist  = pin_set(v) ? CAP_PRESENT : CAP_ABSENT;
    } else if (strcmp(s_section, "control") == 0) {
        if ((v = yaml_value(line, "safety_door_pin"))) s_door  = pin_set(v) ? CAP_PRESENT : CAP_ABSENT;
        if ((v = yaml_value(line, "estop_pin")))       s_estop = pin_set(v) ? CAP_PRESENT : CAP_ABSENT;
    }
    // Macro0..Macro3 are read wherever they appear, not only under a 'macros:'
    // header: the dump this controller sends has the Macro lines without it, and
    // a section test made every macro vanish ("no TLO macro in config").
    {
        const char* sp = line;
        while (*sp == ' ') sp++;
        if (strncasecmp(sp, "Macro", 5) == 0 && sp[5] >= '0' && sp[5] <= '3' && sp[6] == ':') {
            const char* colon = strchr(sp, ':');
            if (colon && s_mcount < CAPS_MACRO_MAX) {
                char name[CAPS_MACRO_NAME_MAX];
                size_t n = (size_t)(colon - sp);
                if (n >= sizeof(name)) n = sizeof(name) - 1;
                memcpy(name, sp, n); name[n] = 0;
                const char* val = colon + 1;
                while (*val == ' ') val++;
                // Values can be quoted; the subtitle wants the bare g-code.
                char body[CAPS_MACRO_NAME_MAX];
                size_t bn = strlen(val);
                while (bn && (val[bn-1] == ' ' || val[bn-1] == '\r')) bn--;
                if (bn >= 2 && ((val[0] == '\'' && val[bn-1] == '\'') ||
                                (val[0] == '"'  && val[bn-1] == '"'))) { val++; bn -= 2; }
                if (bn >= sizeof(body)) bn = sizeof(body) - 1;
                memcpy(body, val, bn); body[bn] = 0;
                // Empty slots must not become buttons.
                if (body[0]) {
                    if (s_mtlo < 0 && applies_tlo(val)) s_mtlo = (int)s_mcount;
                    snprintf(s_mname[s_mcount], CAPS_MACRO_NAME_MAX, "%s", name);
                    snprintf(s_mbody[s_mcount], CAPS_MACRO_NAME_MAX, "%s", body);
                    s_mcount++;
                }
            }
        }
    }
    return true;
}
