NoobyNull/CNC-Display/src/hw/fw_update.cpp

#include "hw/fw_update.h"
#include "hw/sdcard.h"
#include "hw/display_hw.h"
#include "hw/stc8.h"
#include "hw/touch.h"
#include "ui/theme.h"
#include "model/console_log.h"
#include "model/settings.h"
#include "transport/transport.h"

#include <Arduino.h>
#include <Update.h>
#include <WiFi.h>
#include <WiFiClientSecure.h>
#include <HTTPClient.h>
#ifdef HAS_SD_CARD
#include <SD.h>
#endif
#include <lvgl.h>
#include <stdio.h>
#include <string.h>

// Firmware fetched over WiFi from the repo, staged in PSRAM (or on the SD card
// in a HAS_SD_CARD build), then flashed from there. WiFi exists
// ONLY inside the update: the RGB panel ISR is not IRAM-safe, so the radio
// (and the OTA writes themselves) glitch the scanout — which is fine, because
// the whole affair ends in a reboot. The radio is forced off on every exit
// path. The update is blocking, and a power loss mid-write is safe — the boot
// selector keeps pointing at the running slot until Update.end() commits.

// Staging file on the panel's SD, and how hard the download tries.
#ifdef HAS_SD_CARD
static const char* const FW_PART        = "/fw/update.part";
#endif
static const int         FETCH_TRIES    = 5;
static const uint32_t    FETCH_STALL_MS = 15000;
// Both phases copy through this; static because a 4K stack array next to a
// TLS session is a lot to ask of the loop task's stack.
static uint8_t buf[4096];

// Where the download is staged: the SD card when the slot is wired in (DIP on
// TF-CARD), else PSRAM (DIP on WM, where the status bar takes the pin). Both
// resume the same way; the card only adds room to spare.
#ifdef HAS_SD_CARD
static bool     s_to_sd;
static File     s_part;
#else
static const bool s_to_sd = false;   // built without the card
#endif
static uint8_t* s_ram;
static size_t   s_ram_cap, s_ram_len;

static bool stage_open(size_t* have) {            // what is already staged
#ifdef HAS_SD_CARD
    if (s_to_sd) {
        s_part = SD.open(FW_PART, FILE_APPEND);
        *have = s_part ? s_part.size() : 0;
        return (bool)s_part;
    }
#endif
    *have = s_ram_len;
    return true;
}
static void stage_restart() {                     // server ignored the range
#ifdef HAS_SD_CARD
    if (s_to_sd) { s_part.close(); s_part = SD.open(FW_PART, FILE_WRITE); return; }
#endif
    s_ram_len = 0;
}
static bool stage_reserve(size_t total) {         // RAM only, once the size is known
    if (s_to_sd || s_ram) return true;
    s_ram_cap = total ? total : 4 * 1024 * 1024;  // chunked: room for any app slot
    s_ram     = (uint8_t*)ps_malloc(s_ram_cap);
    return s_ram != nullptr;
}
static bool stage_write(const uint8_t* p, size_t n) {
#ifdef HAS_SD_CARD
    if (s_to_sd) return s_part.write(p, n) == n;
#endif
    if (s_ram_len + n > s_ram_cap) return false;
    memcpy(s_ram + s_ram_len, p, n);
    s_ram_len += n;
    return true;
}
static void stage_close() {
#ifdef HAS_SD_CARD
    if (s_to_sd && s_part) s_part.close();
#endif
}

// ---------------- progress modal ----------------
static lv_obj_t *s_m, *s_note;
static volatile bool s_cancel = false;

// The updates run INSIDE an LVGL event callback, i.e. inside lv_timer_handler
// — which refuses re-entrant calls, silently. So nothing here may lean on the
// timer loop: painting is lv_refr_now (re-entrant safe), touch is read from
// the GT911 driver directly, and nothing here animates:
// a moving widget is a framebuffer write while the flash cache is off. This is
// why the modal was once completely invisible.
static void ui_pump() {
    // WiFi activity and OTA flash writes blank the flash cache; the RGB ISR is
    // not IRAM-safe, so the DMA desyncs and the screen turns to garbage.
    // Restart it on a frame boundary a few times a second to stay readable.
    static uint32_t s_last_resync = 0;
    uint32_t now = millis();
    if (now - s_last_resync > 300) {
        s_last_resync = now;
        display_resync();
    }
    touch_poll();                              // its timer is frozen with us
    lv_refr_now(NULL);
}

static void ui_open(const char* title) {
    s_cancel = false;
    s_m = lv_obj_create(lv_layer_top());
    lv_obj_remove_style_all(s_m);
    lv_obj_set_size(s_m, LV_HOR_RES, LV_VER_RES);
    lv_obj_set_style_bg_color(s_m, C_BG, 0);
    lv_obj_set_style_bg_opa(s_m, LV_OPA_COVER, 0);
    lv_obj_add_flag(s_m, LV_OBJ_FLAG_CLICKABLE);
    lv_obj_add_event_cb(s_m, [](lv_event_t*) { s_cancel = true; }, LV_EVENT_CLICKED, nullptr);

    lv_obj_t* t = lv_label_create(s_m);
    lv_label_set_text(t, title);
    lv_obj_set_style_text_font(t, &lv_font_montserrat_28, 0);
    lv_obj_set_style_text_color(t, C_TEXT, 0);
    lv_obj_align(t, LV_ALIGN_CENTER, 0, -U * 8);

    s_note = lv_label_create(s_m);
    lv_label_set_text(s_note, "updating - do not power off - reboots itself when done");
    lv_obj_set_style_text_font(s_note, &lv_font_montserrat_14, 0);
    lv_obj_set_style_text_color(s_note, C_WARN, 0);
    lv_obj_align(s_note, LV_ALIGN_CENTER, 0, -U * 4);

    ui_pump();
}

static void ui_note_set(const char* txt, lv_color_t c) {
    lv_label_set_text(s_note, txt);
    lv_obj_set_style_text_color(s_note, c, 0);
    ui_pump();
}

static void ui_close() {
    if (s_m) { lv_obj_del(s_m); s_m = nullptr; }
}

// Armed-with-escape: buttons fire on a plain tap (long-press proved flaky on
// the glass), so the modal counts down and any tap during it cancels.
static bool ui_countdown() {
    uint32_t start = millis();
    for (int sec = 3; sec > 0; sec--) {
        char b[48];
        snprintf(b, sizeof(b), "starting in %d - touch to cancel", sec);
        ui_note_set(b, C_ACCENT);
        uint32_t t0 = millis();
        while (millis() - t0 < 1000) {
            ui_pump();
            delay(20);
            // Direct read: LVGL's input timer is frozen while we block. The
            // 400ms grace lets the launching tap's finger clear the glass.
            if ((s_cancel || touch_is_down()) && millis() - start > 400) return false;
        }
    }
    return true;
}

static bool cancelled() {
    clog_add("[MSG:UPDATE: cancelled]");
    ui_close();
    display_resync();
    return false;
}

// True from the moment WiFi.begin runs. Once the radio has been up, the only
// reliable way back to a clean screen is a reboot: the radio leaves the RGB
// scanout desynced in ways display_resync cannot always undo (seen live —
// persistent scanline glitches after a failed update, unfixable by resync).
static bool s_radio_used = false;

static void fail(const char* what) {
    char e[96];
    snprintf(e, sizeof(e), "[MSG:UPDATE: %s]", what);
    clog_add(e);
    // Also up the link as a broadcast, so a remote $LM=*PANEL:UPDATE sees why
    // on telnet -- the glass is the only other place it shows, and the panel
    // reboots 4s later. Raw bytes: the send queue is not pumped in here.
    char up[128];
    snprintf(up, sizeof(up), "$LM=*PANEL-UPDATE FAILED: %s\n", what);
    for (const char* p = up; *p; ++p) fnc_putchar((uint8_t)*p);
    Update.abort();
    WiFi.mode(WIFI_OFF);
    // The reason goes on the glass: after a radio failure the panel reboots,
    // and the console log dies with it.
    char n[120];
    snprintf(n, sizeof(n), "FAILED: %s%s", what,
             s_radio_used ? " - rebooting" : "");
    ui_note_set(n, C_CRIT);
    uint32_t t0 = millis();
    while (millis() - t0 < 4000) { ui_pump(); delay(30); }
    if (s_radio_used) ESP.restart();
    ui_close();
    delay(50);
    display_resync();      // radio never ran; a resync is enough
}

// ---------------- network update ----------------

#ifdef HAS_SD_CARD
// One-time credential bootstrap: /wifi.txt on the SD card, lines
//   ssid
//   password
//   url            (optional; default is the repo's fw branch)
// cached into NVS so later network updates need no card at all.
static bool creds_from_sd() {
    if (!sd_open("/wifi.txt")) return false;
    static char buf[256];
    size_t n = sd_read((uint8_t*)buf, sizeof(buf) - 1);
    sd_close();
    if (!n) return false;
    buf[n] = 0;
    char* lines[3] = { nullptr, nullptr, nullptr };
    int li = 0;
    lines[li++] = buf;
    for (char* p = buf; *p && li < 3; p++) {
        if (*p == '\n') { *p = 0; lines[li++] = p + 1; }
    }
    for (int i = 0; i < li; i++) {              // trim CR and trailing junk
        char* e = lines[i] + strlen(lines[i]);
        while (e > lines[i] && (e[-1] == '\r' || e[-1] == '\n' || e[-1] == ' ')) *--e = 0;
    }
    if (!lines[0] || !*lines[0] || !lines[1]) return false;
    settings_set_wifi(lines[0], lines[1]);
    if (li > 2 && lines[2] && *lines[2]) settings_set_update_url(lines[2]);
    clog_add("[MSG:UPDATE: wifi credentials read from SD]");
    return true;
}
#endif

bool fwupd_net() {
    // The modal opens FIRST: every failure after this point is on-screen.
    // "Held the button and nothing happened" must not be a reachable state.
    ui_open("NETWORK UPDATE");
    if (!ui_countdown()) return cancelled();
#ifdef HAS_SD_CARD
    // wifi.txt on the SD overrides stored creds whenever it is present — not
    // only when none are stored, or a baked-in default with a bad password
    // could never be corrected without a cable.
    creds_from_sd();
#endif
    if (!*settings_wifi_ssid()) {
#ifdef HAS_SD_CARD
        fail("no wifi creds - put wifi.txt (ssid/pass) on the SD");
#else
        fail("no wifi creds");
#endif
        return false;
    }
    ui_note_set("joining wifi...", C_DIM);

    s_radio_used = true;
    display_release_internal_ram();
    WiFi.mode(WIFI_STA);
    WiFi.begin(settings_wifi_ssid(), settings_wifi_pass());
    uint32_t t0 = millis();
    while (WiFi.status() != WL_CONNECTED) {
        if (millis() - t0 > 20000) {
            // A bare timeout is undiagnosable. Scan and say whether the SSID
            // is even visible from here (ESP32 = 2.4GHz only) and how loud:
            // not visible = wrong band / out of range; visible = bad password
            // (or an AP mode the S3 cannot join, e.g. WPA3-only).
            ui_note_set("join failed - scanning...", C_DIM);
            WiFi.disconnect();
            int n = WiFi.scanNetworks();
            char e[96];
            bool found = false;
            int  rssi  = 0;
            for (int i = 0; i < n; i++) {
                if (WiFi.SSID(i) == settings_wifi_ssid()) {
                    found = true;
                    rssi  = (int)WiFi.RSSI(i);
                    break;
                }
            }
            if (found) snprintf(e, sizeof(e), "join timeout - '%s' visible at %ddBm - check password",
                                settings_wifi_ssid(), rssi);
            else       snprintf(e, sizeof(e), "join timeout - '%s' not in scan (%d nets) - 2.4GHz? range?",
                                settings_wifi_ssid(), n);
            fail(e);
            return false;
        }
        ui_pump();
        delay(50);
    }
    char ip[48];
    snprintf(ip, sizeof(ip), "%s  fetching...", WiFi.localIP().toString().c_str());
    ui_note_set(ip, C_DIM);

    // Phase 1: download. A stall or a dropped connection costs a reconnect,
    // not the download: the retry asks for the missing bytes only (HTTP
    // Range; Gitea behind Cloudflare answers 206). Each update starts fresh,
    // so a part left by an older image is never resumed into a newer one.
#ifdef HAS_SD_CARD
    s_to_sd = sd_present();
    if (s_to_sd) { sd_mkdir("/fw"); SD.remove(FW_PART); }
#endif

    const char* url = settings_update_url();
    const bool https = strncmp(url, "https:", 6) == 0;
    size_t total = 0;          // whole image, once a response has said
    bool   ok    = false;
    for (int attempt = 1; attempt <= FETCH_TRIES && !ok; attempt++) {
        size_t have;
        if (!stage_open(&have)) { fail("SD card: cannot write /fw"); return false; }

        WiFiClientSecure tls;
        WiFiClient       plain;
        HTTPClient       http;
        if (https) tls.setInsecure();           // Cloudflare cert chain, no store
        if (!http.begin(https ? (WiFiClient&)tls : plain, url)) { stage_close(); fail("bad update URL"); return false; }
        // Cloudflare fronting the Gitea returns error 1010 without a browser-ish UA.
        http.setUserAgent("Mozilla/5.0 (X11; Linux) CNC-Console");
        http.setFollowRedirects(HTTPC_STRICT_FOLLOW_REDIRECTS);
        http.setTimeout(15000);
        if (have) {
            char r[32]; snprintf(r, sizeof(r), "bytes=%u-", (unsigned)have);
            http.addHeader("Range", r);
        }
        const int code = http.GET();
        if (code == HTTP_CODE_OK && have) {      // server ignored the range: start over
            stage_restart(); have = 0;
        } else if (code != HTTP_CODE_OK && code != HTTP_CODE_PARTIAL_CONTENT) {
            // -1 is "connect failed" and says nothing more; the TLS error and
            // the internal heap are what tell DNS, handshake and out-of-RAM apart.
            char tl[48] = "";
            if (https && code < 0) tls.lastError(tl, sizeof(tl));
            char e[96]; snprintf(e, sizeof(e), "HTTP %d %s (int heap %u/%u)", code, tl,
                                 (unsigned)heap_caps_get_free_size(MALLOC_CAP_INTERNAL),
                                 (unsigned)heap_caps_get_largest_free_block(MALLOC_CAP_INTERNAL));
            http.end(); stage_close();
            if (code > 0) { fail(e); return false; }   // a real answer: retrying will not help
            clog_add(e);
            continue;
        }
        const int len = http.getSize();          // this response's body; -1 when chunked
        if (len > 0) total = have + (size_t)len;
        if (total && total < 0x40000) { http.end(); stage_close(); fail("file too small to be firmware"); return false; }
        if (!stage_reserve(total)) { http.end(); fail("no PSRAM for download buffer"); return false; }

        WiFiClient* stream = http.getStreamPtr();
        uint32_t idle = millis();
        size_t   shown = (size_t)-1;
        while (http.connected() && (!total || have < total)) {
            size_t avail = stream->available();
            if (!avail) {
                if (millis() - idle > FETCH_STALL_MS) break;      // stalled: reconnect
                ui_pump();
                delay(10);
                continue;
            }
            idle = millis();
            size_t n = stream->readBytes(buf, avail > sizeof(buf) ? sizeof(buf) : avail);
            if (n && !stage_write(buf, n)) {
                http.end(); stage_close();
                fail(s_to_sd ? "SD card write failed" : "download bigger than its buffer");
                return false;
            }
            have += n;
            const size_t pct = total ? have * 100 / total : 0;
            if (pct / 5 != shown) {
                shown = pct / 5;
                char note[64];
                snprintf(note, sizeof(note), "Downloading%s %u%%%s -- do not power off",
                         s_to_sd ? " to SD" : "", (unsigned)pct, attempt > 1 ? " (resumed)" : "");
                ui_note_set(note, C_WARN);
            }
        }
        http.end();
        stage_close();
        ok = total ? have == total : have > 0x40000;   // chunked: end of stream is the end
    }
    WiFi.mode(WIFI_OFF);
    if (!ok) { fail("incomplete download"); return false; }

    // Phase 2: flash from the staged copy. The writes glitch the scanout no matter
    // what, so say what happens, cut the backlight, and burn it in the dark —
    // the reboot into the splash is the "done" signal. Update.end() verifies
    // the image before the boot selector moves, so a bad file cannot brick.
    ui_note_set("Updating -- please wait for the reboot", C_WARN);
    uint32_t t_note = millis();
    while (millis() - t_note < 1800) { ui_pump(); delay(30); }    // let it be read
    stc8_display(false);

#ifdef HAS_SD_CARD
    File f;
    if (s_to_sd) f = SD.open(FW_PART, FILE_READ);
    const size_t size = s_to_sd ? (f ? f.size() : 0) : s_ram_len;
#else
    const size_t size = s_ram_len;
#endif
    ok = size && Update.begin(size);
    if (ok) {
        size_t w = 0;
        while (w < size) {
            const uint8_t* src;
            size_t n;
#ifdef HAS_SD_CARD
            if (s_to_sd) { n = f.read(buf, sizeof(buf)); src = buf; }
            else
#endif
            { n = size - w > sizeof(buf) ? sizeof(buf) : size - w; src = s_ram + w; }
            if (!n || Update.write((uint8_t*)src, n) != n) { ok = false; break; }
            w += n;
        }
        ok = ok && Update.end(true);
    }
#ifdef HAS_SD_CARD
    if (f) f.close();
    if (ok && s_to_sd) SD.remove(FW_PART);
#endif
    if (ok) {
        delay(200);
        ESP.restart();                     // boot restores the backlight
    }
    stc8_display(true);
    display_resync();
    fail(size ? Update.errorString() : "SD card: cannot read the download");
    return false;
}
