NoobyNull/CNC-Display/src/transport/transport.h

#pragma once
#include <stdint.h>

// The wired UART link to the FluidNC controller, fixed at FNC_BAUD. GrblParserC
// only ever sees fnc_putchar/getchar, so nothing above this layer knows how the
// bytes get there.
//
// A WiFi/Telnet transport used to sit alongside this one and was removed: the
// ESP32-S3's WiFi stack blacks out the flash cache, and the RGB panel's ISR is
// not IRAM-safe in arduino-esp32's prebuilt libs, so the display tore and
// drifted whenever the radio worked. The machine link is a cable. The baud
// hunt went the same way once OTA landed: the pendant end is known hardware.

void        transport_init();
void        transport_poll();       // reconnection poke while the controller is silent
const char* transport_label();      // e.g. "UART 1M", "NO LINK"
const char* transport_detail();     // longer status for the Setup page

// Called when the Setup "Wired UART" toggle changes so the link comes up
// without a reboot.
void transport_settings_changed();

extern "C" {
void fnc_putchar(uint8_t c);
int  fnc_getchar();
bool fnc_rx_waiting();
}
