NoobyNull/CNC-Display/src/model/FluidNCModel.h

// Copyright (c) 2023 Mitch Bradley
// Use of this source code is governed by a GPLv3 license that can be found in the LICENSE file.

#pragma once
#include "GrblParserC.h"

// Same states as FluidNC except for the last one
enum state_t {
    Idle = 0,   // Must be zero.
    Alarm,      // In alarm state. Locks out all g-code processes. Allows settings access.
    CheckMode,  // G-code check mode. Locks out planner and motion only.
    Homing,     // Performing homing cycle
    Cycle,      // Cycle is running or motions are being executed.
    Hold,       // Active feed hold
    Jog,        // Jogging mode.
    DoorOpen,
    DoorClosed,
    GrblSleep,     // Sleep state.
    ConfigAlarm,   // You can't do anything but fix your config file.
    Critical,      // You can't do anything but reset with CTRL-x or the reset button
    Disconnected,  // We can't talk to FluidNC
};

// Variables and functions to model the state of the FluidNC controller

extern state_t     state;
extern const char* my_state_string;

extern int                n_axes;
extern pos_t              myAxes[6];   // WORK position (wco already subtracted)
extern pos_t              myWco[6];    // work coordinate offset; machine = myAxes + myWco
extern bool               myLimitSwitches[6];
extern bool               myProbeSwitch;
extern const char*        myCtrlPins;

// Stepper-driver health, carried in Pn: as digits (0=X 1=Y1 2=Y2 3=Z 4=A,
// present while the driver is online). Armed on first sighting.
bool drv_pin(int n);
bool drv_feature_armed();
bool drv_axis_ok(char axis);
extern const char*        myFile;
extern file_percent_t     myPercent;
extern override_percent_t myFro;
extern override_percent_t myRro;   // rapid override; FluidDial discarded this
extern override_percent_t mySro;
extern uint32_t           myFeed;
extern uint32_t           mySpeed;
extern int                lastAlarm;
extern bool               inInches;
extern uint32_t           mySelectedTool;

#include "cmd/cmd.h"
#include "link/link.h"

char        axisNumToChar(int axis);
const char* mode_string();

void set_disconnected_state();
