NoobyNull/CNC-Display/(commit log)

2026-08-09 Initial commit: design spec and FluidDial reference source
    Adds the approved design for a FluidNC control console on an Elecrow
    CrowPanel Advance 7.0" (800x480, ESP32-S3), talking to FluidNC over a
    wired UART at 1 Mbaud.
    Vendors FluidDial-main unmodified as reference. The spec cites specific
    line numbers in it (SystemArduino.cpp:133 for the 1 Mbaud UART init,
    ProbingScene.cpp:29 for the probe sequence, FilePreviewScene.cpp:78 for
    $SD/Run), and those citations are worthless unless the exact source they
    refer to is pinned alongside them.
    Claude-Session: https://claude.ai/code/session_013dTPh4PiMQaX7ihqXREgzx
2026-08-09 build: PlatformIO skeleton, panel bring-up, UART2 transport, G-code path parser
    touch.cpp is adapted rather than copied: its gesture layer delayed LVGL press
    reports by 120ms to disambiguate taps from swipes and suppressed input after
    30px of movement. A jog key must register on contact, and a swipe starting on
    one would change page mid-cut. The GT911 read path is unchanged.
    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
2026-08-09 model: offsets parser, console log, XModem-1K receiver — 32 host tests passing
2026-08-09 model: port FluidNCModel with compat shims for FluidDial's Scene/FileParser plumbing
    Every shim is either a real reimplementation (schedule_action, request_redisplay,
    resetFlowControl, bootlog_printf) or an honest no-op with its reason stated in
    model_compat.h. The handle_other() fan-out sits above the early returns because
    the file-list reply is the '{' case that returns into handle_json().
    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
2026-08-09 fix: machine DRO, file-list repaint on scroll, rapid override
    Three defects found by self-review after the build was green:
    - myAxes is the WORK position (show_dro subtracts wco), so the DRO printed the
    same value twice and labelled one 'M'. The model now keeps myWco[] and the
    machine line is myAxes + myWco.
    - The Run page's scroll buttons moved s_scroll but page_run_tick() early-returned
    on the file-list dirty flag, so rows never repainted. Split view-dirty from
    model-dirty.
    - show_overrides() received the rapid override and dropped it. Added myRro and
    populated all three override cells, tinted when off 100%.
    Cla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
2026-08-09 fix: no boot wait on the controller link
    setup() chained send_line("$#") and filelist_request(). fnc_send_line() spins
    in while(_ackwait) until the previous line is acked or its 2000ms timeout
    expires, so with no controller attached the panel froze for ~2s before the
    first frame was painted.
    Boot now sends only XON and a status-report request (single putchar, no ack
    expected) and paints frame one immediately. Offsets and the file list are
    primed once from loop(), the first time state != Disconnected.
    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
2026-08-09 fix: I2C init and the OPI PSRAM toolchain
    Flashing exposed two defects that only appear on real hardware.
    Wire.begin(19, 20) was never called, so every GT911 and PCA9557 transaction
    failed with 'NULL TX buffer pointer'. The bus must come up before
    display_init(), which drives the PCA9557 immediately.
    espressif32@6.9.0 (arduino-esp32 2.0.17 / IDF 4.4) could not add this board's
    OPI PSRAM to the heap: 'External RAM could not be added to heap!' followed by
    an abort loop at cpu_start, and only 434KB of PSRAM visible when it did limp
    through. That pin came from FluidDial, which targets an M5 Stamp S3 and a
    plain-ESP32 CYD - neither has OPI PSRAM. Switched to the pioarduino platform
    that Elcrow-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
2026-08-09 tools: two-adapter flash script, link watchdog, UART byte counters
    The CrowPanel's onboard CH340 has a dead TX line. Proven by putting the chip in
    ROM download mode and sending a hand-built SLIP sync packet: CH340 got 0 bytes
    back, an FTDI on the same pin got 1344. Its DTR->GPIO0 and RTS->EN still work,
    so it drives reset fine. tools/flash.sh uses the CH340 for reset and the FTDI
    for data.
    Also adds a 1Hz link watchdog. Previously the boot-time status request was the
    only one ever sent, so a link that was not ready at boot stayed dead forever.
    It now re-pokes a disconnected link and logs state plus RX/TX byte counts,
    which is what distinguishes 'wired wrong' (rx stays 0) from 'wrong baud'
    (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
2026-08-09 feat: runtime transport selection with UART/WiFi toggles in Setup
    The wired pins and the WiFi link are now both first-class transports chosen at
    runtime, not at build time. transport.cpp owns fnc_putchar/fnc_getchar and
    dispatches to whichever is live; uart.cpp's entry points became uart_putc/getc.
    - Setup page: switches for Wired UART and WiFi, an SSID/password pair with an
    on-screen keyboard, and a live link-status readout. All NVS-backed.
    - Hunting: while disconnected, cycles UART between 1M and 115200 (the same pins
    carry the Airdale pendant or an FTDI) and falls back to WiFi when enabled.
    Stops the moment FluidNC answers, resumes if the link drops.
    - WiFi is Telnet, discovered vi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
2026-08-09 feat: panel SD card as G-code source, uploaded to the controller via $XR
    The controller lives in a sealed box, so its SD card is unreachable. The panel's
    own slot becomes the source: browse it, then push the file to the controller
    with $XR=<path> and run it with $SD/Run= as usual.
    Copying rather than streaming line-by-line is deliberate. Once the file is on
    the controller it runs from the controller's own storage, so the pendant can be
    unplugged mid-cut without stopping the job. A streaming sender would make the
    panel a single point of failure for the whole run.
    - xmodem_tx.cpp: XModem-1K transmitter, the mirror of the receiver. Data is
    pulled through a callback, so a 1MB job never needs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
2026-08-09 feat: browse and edit FluidNC settings from the Diag page
    Editing live $ settings rather than rewriting config.yaml: most take effect
    immediately with no restart, and a bad value is rejected with an error instead
    of leaving the controller with a config file it cannot parse.
    - fnc_settings.cpp parses the '$<name>=<value>' reply lines from $S and $SC,
    including the URI decoding FluidNC applies to characters Grbl would misread
    (ProcessSettings.cpp:125). A repeated name updates in place rather than
    appending a duplicate row.
    - Diag page is now a paged list of ~150 settings: tap one, edit the value with
    the on-screen keyboard, and it writes '$name=value'. FluidNC's ok or error:N
    reply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
2026-08-09 feat: ICM-20948 vibration guard with monitor/soft/hard modes
    Ports CNC-TW's sensor and analysis onto the display. The IMU shares the panel's
    existing I2C bus (SDA 19 / SCL 20) alongside the GT911 at 0x5D and the PCA9557
    at 0x18 — the ICM-20948 sits at 0x68/0x69, so no address clash and no new pins.
    Reads take the same i2c mutex touch uses, and skip the sample rather than block
    if the bus is busy: a missed sample at 200Hz is invisible, a stalled UI is not.
    Found and fixed a real defect while porting. CNC-TW escalates to e-stop on jerk
    alone, but jerk is a per-sample delta over the sample interval, so any vibration
    large enough to reach the 0.5g RMS hold threshold also produces jerk far abo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
2026-08-09 feat: UPDATE / PENDANT link mode so the board is always flashable
    GPIO 43/44 can be the programming console or the FluidNC link, never both —
    one is 115200 log text, the other a 1 Mbaud machine link. Until now that was a
    build-time decision, which meant flashing a pendant-mode build left no console
    and put app traffic on the pins esptool needs.
    UPDATE (default) console owns 43/44, wired transport disabled
    PENDANT FluidNC owns 43/44, console parks on the unconnected GPIO 42
    Defaults to UPDATE so a freshly flashed board is always recoverable and
    watchable. Settings load before Serial.begin() because they decide which pins
    the console gets. Switching takes effect on restart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
2026-08-09 docs: session handoff — wiring state, the flashing blocker, and hard-won details
    Records what a fresh session would otherwise have to rediscover: the GPIO map as
    measured, why the toolchain must be pioarduino, the CH340's dead TX line, and
    the EN/IO0 short that is currently preventing download mode.
    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
2026-08-11 feat: port to Waveshare ESP32-S3-Touch-LCD-7B
    The CrowPanel is abandoned: its CH340 TX line was dead and EN was shorted to
    IO0, so it could not be put into download mode. This board flashes over native
    USB on a Type-C that shares nothing with the machine link.
    Panel goes 800x480 -> 1024x600 with Waveshare's timings. The PCA9557 is replaced
    by the 7B's CH32V003 io-extender, which gates the VCOM rail, the backlight, the
    GT911 reset and the USB/CAN mux. Its driver is reimplemented rather than vendored
    because the vendor's seeds the output shadow with 0xFF, and bit 5 hands the USB-C
    to the CAN transceiver -- disconnecting the port we flash and debug through.
    The SD slot is wired for SDMMC with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
2026-08-11 feat(cad): rear enclosure for the 7B with a VESA 75 mount
    Enclosed back cover, 165.40 x 102.15 x 23.30, screwed to the display bracket's
    four M3 holes and carrying a VESA 75 pattern so the panel goes on a table arm.
    Built as a parametric script rather than a click-modelled body so the numbers
    stay editable and traceable. Every panel dimension is measured off Waveshare's
    STEP, not the datasheet picture, and the result is checked against that STEP by
    boolean interference -- zero clashes, with a positive control at +4mm that does
    clash, so the check is known to be live.
    Openings: three cable holes in the right wall next to the PH2.0 bank for power,
    UART and I2C; a slot in the left wall for bo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
2026-08-11 feat(cad): ball-and-socket table mount for the panel
    The other half of the mount: the back cover carried a VESA 75 pattern but
    nothing to bolt it to. Four printed parts -- base plate with a ball, under-table
    clamp bar, two identical arm halves forming a double socket, and a VESA plate
    with a ball.
    Range is measured, not assumed: sweeping each neck against the assembled socket
    in 5 degree steps gives +/-40 deg per joint before interference, plus free roll
    about each ball axis. The socket mouth is 19.80mm against a 20.00mm ball, so the
    ball is captive before the bolts are touched.
    The angles fall out of printability. A sphere on a vertical neck needs a 45 deg
    blend to avoid an unsupported un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
2026-08-11 feat(cad): pose the whole stack as one assembly
    Panel, back cover, VESA plate, arm, base, clamp bar and a slab of table, placed
    so the geometry can be checked before anything is printed. Zero interference
    among all printed parts, the panel and the table.
    Posed in panel coordinates -- the frame the vendor STEP already uses -- because
    the panel is the one thing already correctly placed, and that lets the vendor
    model drop in with no transform at all. The table comes out tilted in that
    frame; TABLE_NORMAL is world up.
    Both balls sit at 30 degrees, inside the measured +/-40, and the resulting pose
    falls out rather than being chosen: screen 30 degrees above horizontal,
    100-200mm above the table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
2026-08-11 feat(cad): route the loom out the back and down a tray on the arm
    The three side-wall exits put the cables into free space beside the panel with
    nothing to follow, which is exactly what snags. They are now one 11x30 stadium
    slot through the REAR wall, pointing down at the arm -- where the loom is going
    anyway. It sits in the corridor right of the VESA plate and between the two M3
    columns, so nothing around it is thin, and it is a stadium rather than a
    rectangle so no corner sits under a wire.
    The arm gets a Ø12 channel down its outer face with two moulded bridges
    spanning it: thread the loom under them and it is captive with no zip tie and
    nothing proud to catch. Both halves carry one, so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
2026-08-11 feat(cad): bolt the base flat to the bench, drop the clamp
    Four holes on an 84x56 rectangle, Ø7 through with a Ø14x4 flat counterbore so a
    1/4in lag or M6 head sinks flush on a washer. SCREW_CLR/SCREW_HEAD_D size them
    for anything else; a 90 degree countersink swaps in for flat-head screws.
    ClampBar is deleted along with the base's two M8 clamp holes, the edge-overhang
    positioning they needed, and the bar's nut traps. The plate is now symmetric and
    sits fully on the bench.
    The load is undemanding: the panel hangs 167mm forward of the base, 0.74 N.m of
    tipping, and with the screw rows 56mm apart that is 13 N shared between the rear
    pair -- under 7 N of pull-out each.
    Assembly updated to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
2026-08-11 feat(cad): export every part in its print orientation
    cad/export_print.py writes cad/print/ -- four STLs plus a combined 3MF. Each
    part comes out already the right way up and seated on Z=0, so they drop onto the
    plate with no rotating: cover rear-face down, arm half socket-face up, both
    plates ball-up.
    Meshed at 0.04mm linear / 0.2 deg angular. Not cosmetic -- the ball and socket
    are a running fit on 0.25mm of clearance and a coarse tessellation would eat
    most of it. All four verified solid, manifold and self-intersection free.
    Seating is done on the mesh, never on the shape. Shape.BoundBox is the loose
    NURBS-pole box on anything curved: on the arm half it reads ~9mm below the real
    undersi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
2026-08-12 fix(display): drive the RGB panel through esp_lcd, not LovyanGFX
    The panel came up white with the backlight lit. LovyanGFX's Bus_RGB::config_t
    stores every porch and pulse width in an int8_t, so Waveshare's real timings —
    hsync pulse 162, back porch 152 — wrapped to -94 and -104. The horizontal timing
    generator got garbage and the panel never synced. Still true on LovyanGFX
    master, so there was no version to upgrade to.
    Correcting that got a picture, and it was static. Panel_RGB::initFrameBuffer()
    puts the whole framebuffer in PSRAM unconditionally — use_psram is marked
    `unimplemented` and the code calls itself a provisional implementation — so
    1.2 MB per frame streams out of PSRAM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
2026-08-12 fix(touch): keep the press between GT911 refreshes, and unwedge the bus
    touch_poll() treated status 0x00 as a finger lift. It means "no fresh scan since
    you last cleared the buffer" — the normal case, since we poll at 50Hz and the
    controller refreshes slower. touch_down dropped to false between refreshes,
    flickering the press faster than LVGL samples the input device, which made
    press-and-hold on a jog key impossible and mostly read as no touch at all.
    Also recovers a wedged I2C bus. A miswired ICM-20948 on the I2C terminal held a
    line low; every transaction returned ESP_ERR_INVALID_STATE from then on, and
    since the GT911 shares SDA 8 / SCL 9 that took out all touch input including the
    sa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
2026-08-12 refactor: remove the WiFi/Telnet transport
    The ESP32-S3's WiFi stack blacks out the flash cache, and arduino-esp32 ships
    its prebuilt libs with CONFIG_LCD_RGB_ISR_IRAM_SAFE unset — so the RGB panel's
    ISR cannot run during those blackouts, the DMA loses sync, and the display tears
    and drifts whenever the radio works. Bounce buffers do not cover it, and the
    setting is not ours to change.
    The machine link is a cable. Telnet was a fallback that cost 623 KB of flash
    (1,476,535 -> 852,911) and 8% of RAM to keep.
    Deletes wifi_link.{h,cpp}, TRANSPORT_WIFI, the Telnet host/port settings, the
    SSID/password fields and the Setup toggle.
    display_resync() stays and now fires after every NVS write, wh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
2026-08-12 fix(ui): derive the layout from the panel, and show every axis FluidNC reports
    The port carried the CrowPanel's constants over and the 7B's extra 120 px showed
    as dead space on every page. Each of these exactly filled a 480px screen and
    nothing reflowed into the 600px one:
    NAV_VISIBLE 5 -> 6 rail ended 120px short of the bottom
    ROWS 3 -> 4 run: file list
    ROWS 5 -> 8 diag: settings
    VISIBLE_ROWS 6 -> 9 offsets: G54-G59 now fits without scrolling
    PAD = U*30 -> CONTENT_H - U*2 jog: pad and Z column
    They are computed from CONTENT_H / SCREEN_H now. The formula reproduces every
    old constant exactly when fed the CrowPanel's 240px page, which is how w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
2026-08-12 feat(vibration): jerk histogram, adjustable sensitivity, smoothed peak
    Three gaps against CNC-TW, the module this analyser was ported from.
    PEAK_DECAY was ported as 0.98 where CNC-TW uses 0.995. Per-sample decay
    compounds: at 200Hz that is 0.98^200 = 0.017 against 0.995^200 = 0.37, so an
    impact was wiped to under 2% within a second when it should still read 37%. The
    peak exists so a spike survives long enough to be seen; the fast value defeated
    that. Transcription slip, not a deliberate port change.
    smoothed_peak was never ported — CNC-TW smooths peak at alpha 0.10, slower than
    the 0.15 it uses for RMS. RMS already averages a 128-sample window while peak is
    a single decaying extreme, so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
2026-08-12 docs: record the bring-up, and make clangd usable
    HANDOFF.md rewritten around what actually went wrong on first hardware contact:
    the int8_t timing wrap, the missing bounce buffer, the GT911 press state, a
    faulty SD card that stops the chip enumerating at all, and a miswired I2C device
    taking out every input on the panel. Each cost real time and none is guessable
    from the code.
    Adds .clangd. compile_commands.json did not exist, and once generated every
    entry invokes xtensa-esp32s3-elf-g++ with flags clang does not know — clangd
    aborts a command at the first unrecognised flag, so it never reached the 352
    include paths and reported every LVGL type as unknown. Stripping them plus the
    toolcha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
2026-08-12 docs: the link is proven, and the stand-in that proves it
    An FTDI on the UART terminal answering '?' with a 4-axis Grbl report brings the
    panel fully up: it locks the baud, leaves Disconnected, fires $# and the file
    list from prime_link_if_up(), and the DRO grows its A column and tracks it live.
    Transport, GrblParserC, priming and the multi-axis layout are all confirmed
    against hardware now — only the real controller is untested.
    The handoff said all of that was unverified; it was committed twenty minutes
    before the test passed.
    Adds tools/fakefluidnc.py, plus the two things that cost time getting there: the
    Wired UART toggle persists in NVS and makes the panel silent on the wire in a wa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
2026-08-12 feat(ui): let the panel go dark when nothing is happening
    A shop panel left lit overnight is a shop panel with burn-in. Setup gets a
    "Screen off" row beside Brightness: 5-minute steps to an hour, 0 = Off, which
    is the default. A display that blanks unasked next to a running spindle is the
    wrong surprise, so it is opt-in.
    Two decisions worth stating:
    Only a machine that is genuinely still lets the panel blank. Idle, Disconnected
    and Sleep count as still; motion, homing, hold and every alarm state hold the
    screen lit, and going busy wakes a blanked panel rather than merely holding off
    the countdown. An alarm raised in the dark is an alarm nobody acts on.
    The tap that wakes it never reaches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
2026-08-12 feat(jog): hold to jog continuously, tap the centre to change step
    Two things the pad could not do. Holding a direction key moved exactly one step
    and stopped; the centre of the pad was a label.
    Holding now gives continuous motion in that direction, past LVGL's 400ms
    long-press. Feed tracks the selected step -- FluidDial's "5x the step per
    second" -- so the same key creeps at 0.01mm and traverses at 1mm, and the step
    selector doubles as a speed selector. Above 1mm it stays tap-only: a press at
    10mm is a deliberate discrete move, and a held key that ran away at coarse
    resolution is the wrong thing to have under a thumb.
    Tapping the pad centre walks the step by a factor of ten and wraps,
    0.0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
2026-08-12 fix(ui): the backlight never came back, and add steps/mm calibration
    The screen-off feature shipped with a bug that bricks the panel until it is
    power-cycled. screen_idle_tick() decided whether to touch the backlight by
    comparing the screensaver's state before and after updating it -- but the touch
    driver clears that same flag itself when it swallows the wake tap. By the time
    the tick ran there was no transition left to see, EXIO_DISP was never
    re-enabled, and since both sides then read "not blanked" forever, nothing could
    recover it. The panel stayed dark with touch working underneath, which reads
    exactly like a frozen display.
    display_hw.cpp now tracks what the backlight is actually doing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
2026-08-13 feat(ui): brightness in percent, and make the screensaver observable
    Brightness read 0-255 on screen, which means nothing to anyone standing at the
    machine. It is now 10-100% in 5% steps. Storage and set_backlight() stay 0-255 —
    only the display and the step are in human units. The 10% floor is the old
    "never fully dark" guard (25/255) kept deliberately: an unreadable panel next to
    a running spindle is a hazard.
    The link diagnostic now carries the screensaver's state — scroff, the LVGL idle
    seconds, and whether it is blanked. Added because "I don't think the screen
    timeout worked" could not be answered without it, and guessing produced two
    wrong theories before the data produced the rig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
2026-08-13 fix(ui): a stuck touch could disable the panel until a power cycle
    The wake-tap swallow waited for the finger to lift before letting input through
    again. The GT911 keeps its last reported state when it stops producing fresh
    scans, so touch_down stayed asserted, the release never arrived, and every
    sample was swallowed from then on. The panel looked frozen; touch was gone until
    it was power cycled. Reported from the machine, and visible in the console trace
    as idle= pinned at 0 for seventy seconds, since the swallow path also kept
    resetting LVGL's activity clock.
    The swallow is now bounded at 600ms as well as by the release. Comfortably past
    a tap, far short of anything anyone would call unr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
2026-08-13 feat(ui): sensor thresholds as horizontal bars against the live reading
    Three stacked -/value/+ rows told you what the thresholds were set to and
    nothing about the cut happening in front of you. Each row is now name and
    threshold, a bar, the live reading, then - and +.
    The bar measures the reading against its own threshold rather than against the
    setting's absolute range. 0.5g on a 0-5g scale is a bar that never moves; what
    matters is how much of the margin a cut is using. So the threshold sits at a
    fixed 70% on all three bars, they all read the same way, and the space past the
    tick is the overshoot you are not supposed to see. Green, amber from 75%, red
    past the tick — amber before it ra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
2026-08-13 fix(touch): recover a stuck press, and instrument the input
    Adds [touch] down/scans/resets to the console, and a watchdog that resets the
    GT911 when a press is stuck.
    The instrumentation earned its place immediately by disproving the theory it was
    written to support. The first version of this watchdog fired whenever the
    controller stopped reporting, on the assumption that a healthy GT911 scans
    continuously. It does not: the data-ready bit means "something changed", and
    with no finger on the glass it legitimately says nothing for as long as you
    leave it alone. Measured — a few scans after reset, then silence. So the
    watchdog was resetting the controller every five seconds for the crime of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
2026-08-13 fix(touch): watch for stalled frames, with a backoff, and locate stalls
    Counters for polls, mutex failures and status errors, so a dead panel says
    which of three indistinguishable things happened: the poll not running, the poll
    losing the I2C mutex to the IMU at 200Hz on the same bus, or the chip answering
    cleanly while no longer scanning.
    On a healthy panel: polls climbing, scans climbing continuously even untouched,
    lockfail 0, staterr 0, down going 0->1->0 per tap. So the IMU is not starving
    touch, and a stalled scan counter is the fault signal.
    That last point corrects what this file said an hour ago. An earlier reading
    showed three scans after each reset then silence, which looked lik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
2026-08-13 perf(touch): drive touch from INT, latch presses, drop the IMU to 50Hz
    Three changes against a sluggish UI and buttons that sometimes did not register.
    Touch reads on the GT911's INT line instead of asking 50 times a second. The ISR
    only raises a flag — I2C cannot be done from an ESP32 ISR — so the timer still
    does the reading, it just stops reading for nothing. Measured: ~7 reads/s where
    there were 50. A 100ms idle heartbeat stays, deliberately: interrupts are the
    latency path, not the only path, and a missed or mis-polarised edge would
    otherwise be indistinguishable from a wedged controller.
    Presses are latched. A tap can begin and end between two LVGL reads — touch
    sampled at 50Hz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
2026-08-13 docs: handoff for the GT911 stall
    The panel is usable but not trustworthy: it works, loses touch, and a power
    cycle clears it. Everything else this session is done and pushed, so the next
    session is one bug.
    Records what the stall actually looks like — polls climbing, scans frozen, zero
    I2C errors, zero mutex failures — and the clue nobody has followed: every
    watchdog reset yields exactly three more frames before stalling again. The
    untried lead is that this driver has never written a GT911 config and now drives
    INT as an interrupt without knowing what mode the chip believes it is in.
    Six theories are listed as ruled out with the evidence against each, so they are
    not re-tested. Two wr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
2026-08-13 fix(touch): delete the GT911 stall watchdog — it was the bug
    The watchdog hard-reset the touch controller after 5s without a frame, on
    the premise that a healthy GT911 free-runs at 5-10 frames/s while idle.
    That premise is false. It was measured from a panel already assumed to be
    broken, which is the trap the last handoff warned about.
    Measured with a finger on the glass: the chip reports only while something
    is happening. Untouched it emits three frames after reset and then nothing,
    indefinitely, while a press produces frames at its 8ms refresh (status
    0x81, INT asserted) and lifts cleanly. Idle silence is its resting state.
    So the watchdog reset a working controller every 5 seconds —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
2026-08-13 fix(jog): disable the direction keys when no controller is connected
    send_jog_line() is ack-gated on UART, so every press parks in
    fnc_send_line()'s `while (_ackwait)` until the 2000ms timeout — inside the
    same lv_timer_handler() pass that reads touch. Held past 400ms it is worse:
    jog_chunk() re-sends every 150ms, each send costing more than the tick that
    scheduled it, so the timer is permanently overdue, the input read is
    starved, and the release that would call jog_stop() never arrives. It
    sustains itself until a power cycle.
    lv_obj_hit_test() rejects LV_STATE_DISABLED outright, so disabling the ten
    direction keys stops the press ever reaching an event handler. Dimmed to
    LV_OPA_40 so a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
2026-08-13 docs: the simulator fix must not modify FluidNC
    The first pass fixed four of the five simulator faults by editing
    capture/Platform.h, capture/i2s_out.cpp and platformio.ini. That is not a
    legitimate fix: a simulator that only works against a patched FluidNC
    proves nothing about the real controller, and the patch is a liability
    every time upstream moves.
    Reverted, and redone entirely in simrun/ — config and NVS data. The host
    build's constraints are fixed, so the config bends to them instead: S3 pin
    table, no I2SO, two UARTs, no VFD sources. Verified against stock FluidNC:
    zero ERR at boot, Stepping:Simulator, jog acked, MPos advances, panel links
    over the FTDI.
    Also records the parser go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
2026-08-13 docs: spec for the jog go-to number pad
    Tap a DRO axis cell on the JOG page, type a target, GO. Sends
    $J=G90F<feed><axis><target> in the active WCS.
    Records the decisions and the rejected alternatives so they are not
    silently revisited: jog rather than G0 (cancellable, leaves modals alone),
    work rather than machine coordinates, JOG page only, a dedicated modal pad
    rather than the w_keyboard() singleton page_cal.cpp:12 warns about, and no
    panel-side typo or travel guard at all — the panel is a controller, not a
    safety device, and an out-of-range target is FluidNC's job via soft_limits.
    Pure entry logic goes in model/numentry.* with a host test, following the
    calibration.cpp / page_cal.cpp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
2026-08-13 fix(link): queue controller lines instead of blocking the UI on the ack
    fnc_send_line() opens with `while (_ackwait)`, spinning until the previous
    line is acked or its 2000ms timeout expires. Every UI caller reaches it
    from an LVGL event callback, i.e. from inside lv_timer_handler() -- which
    is also what drives touch_poll() and the input read. A slow or silent
    controller therefore did not slow the machine down, it froze the panel,
    with no way to press HOLD.
    Measured at link-up, not guessed: 2175ms then 6175ms of dead UI, the
    second being three consecutive ack timeouts from the priming lines. 8.4s
    every power-on. After this change the worst window is 399ms, which matches
    the no-controller ba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
2026-08-13 feat(touch): four-corner hold opens the console log
    An escape hatch to the log from anywhere: the moment you want it is the
    moment the UI is behaving oddly, so the way in must not depend on reaching
    a particular button on a particular page.
    The view already existed -- view_expanded.cpp has the console and its close
    button, wired at shell.cpp:154. Only the gesture is new.
    The driver read only point 0 despite knowing the contact count from
    0x814E's low nibble, so it now reads 8*n bytes from 0x8150 (track_id, x,
    y, size, reserved per point). Strictly additive: point 0 still feeds LVGL
    exactly as before, and the extra bytes are only read when fingers are
    down. Multi-touch cannot go through LVG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
2026-08-13 Revert "feat(touch): four-corner hold opens the console log"
    This reverts 9662e8e. The gesture worked, but it opened the FluidNC
    console -- controller traffic -- and what was actually wanted was the
    ESP32 system log. Not the same thing, so the gesture goes.
    Removing it also takes the multi-point read with it. Nothing else consumed
    it, and it cost a real outage: the point stride starts at 0x814F, where
    the track id lives, not at 0x8150. The old single-point code read four
    bytes from 0x8150 as x_lo/x_hi/y_lo/y_hi and was right; treating 0x8150 as
    the track id ate x_lo and shifted every field by a byte, so a tap at x=86
    was reported at x=16640. Presses still registered and the counters looked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
2026-08-13 docs: spec for enclosure rev 2
    Full-back cover to the glass outline, an 18650 UPS bay, a hardwired
    protected machine link, and a reachable restart button.
    Two findings changed the design during the discussion and are recorded so
    they are not re-derived:
    The board already has a lithium charger -- Waveshare item 13 is a 3.7V
    battery PH2.0 header with DONE/CHARGE/POWER indicators -- so the UPS needs
    no TP4056 and no boost converter. An earlier version of this design
    mounted both.
    Growing the shell to the glass moves every wall away from the port behind
    it, taking USB-C reach from 23mm to ~38mm, which defeats a normal
    overmould on what is also the flashing port. The walls are therefore
    locall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
2026-08-13 docs: measured RJ12 adapter board into the enclosure spec
    30 x 28mm, two M3-clearance holes 21mm apart, 4.25mm in from the 30mm
    edge. Two printed bosses plus an edge lip to stop it pivoting on a
    two-point mount.
    Replaces the outline/hole unknowns with one that matters more: the height
    of the tallest part on the board. A fitted 6P6C jack stands ~13mm, which
    with the board is ~15mm of a 20.3mm cavity, so where the board can sit
    depends on it. Unpopulated, the constraint goes away.
    Claude-Session: https://claude.ai/code/session_01U1qrgdcE2DcsWqGCwpPaBi
2026-08-13 docs: adapter stack measured at 17mm; bump-out shrinks to ~6mm
    The left strip has no PCB behind it -- USB_X_FACE = -55.03 is the panel
    PCB's left edge -- so the full 20.3mm of cavity depth is clear there. That
    was not accounted for when the bump-out was sized at 20mm.
    Consequences: the 17mm adapter stack needs no bump-out at all, and the
    cell needs only ~6mm for real retention rather than the 0.2mm margin a
    flush fit would leave. Worst-case depth from the glass drops from ~51mm to
    ~38mm, so the lump largely disappears.
    Cell and adapter stack vertically in that strip, ~101mm of the ~105mm
    available, both clear of the USB plugs at Y -12.55..-8.49.
    Keeping the adapter rather than falling bac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
2026-08-21 fix(uart): log setup errors and prove the transmitter with an internal loopback
    Silicon-internal loopback at init: TX routed to RX inside the chip, no pads
    involved. n=4 data=PING at boot means the peripheral and driver provably
    transmit, so any silence on the wire is downstream of the chip. Written while
    isolating the 7B's dead H3 terminal; just as useful on the next board.
    Claude-Session: https://claude.ai/code/session_016DtqammwErijmbLntESVR5
2026-08-21 feat(cad): enclosure rev 2 progress, assembly renders, cad gitignore
    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
2026-08-21 feat: port to Elecrow CrowPanel Advance 7.0 V1.4, with a machined boot splash
    The 7B went back on warranty (dead U13 mux); this board is the Advance HMI
    V1.4 — 800x480, same N16R8 module. Pin map and timings verbatim from Elecrow's
    V1.3-1.5 factory example; esp_lcd driver architecture unchanged. The CH32V003
    io-extender is replaced by the STC8H1K28 helper at I2C 0x30 (backlight byte,
    touch reset via command 250 with INT strapped on GPIO 1). SD back to SPI on
    4/5/6, function DIP on TF-CARD. Console and link now share UART0's pins — the
    CH340K sits on 43/44 and there is no native USB — so the Wired UART toggle
    decides at boot which one owns them, and the UART driver only installs when
    th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
2026-08-21 feat: SD firmware updates, a DIAG command line, and config save
    Two app slots in the partition table (spiffs was 10MB of nothing), and
    SETUP gains a hold-to-run UPDATE FW that flashes /update.bin from the SD card
    into the inactive slot — power loss mid-write boots the old firmware. Ends
    the unplug-the-link-to-flash ritual for everything short of partition changes.
    DIAG's edit box doubles as a free command line when no setting is selected,
    and a hold-to-run SAVE CFG sends $CD=config.yaml — FluidNC's undocumented
    persistent save, which dumps the live config tree over the boot file.
    Claude-Session: https://claude.ai/code/session_016Dt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
2026-08-22 feat: network OTA from the repo, live limit lamps, settings-write feedback
    UPDATE NET on SETUP: WiFi up, fetch the fw branch's update.bin from Gitea
    (tokenized read-only URL; wifi.txt on the SD overrides the baked defaults),
    then two-phase install — download to PSRAM with the screen alive, then radio
    off and backlight dark while flashing, because flash writes desync the RGB
    DMA faster than any resync can repair. The radio exists only inside this
    call; the no-WiFi rule for the running display stands. The reboot into the
    splash is the done signal.
    DIAG gains live limit/probe lamps driven from the Pn: field — the data was
    parsed into myLimitSwitches and never shown, which made working swit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
2026-08-22 feat(cad): Advance VESA adapter plate and Corgi+Airedale cabinet chassis
    The Advance is a cased display, so the 7B's rear enclosure collapses to one
    adapter plate: the shell's measured 160x74 M3 pattern to the same VESA 75
    boss interface, arm and ball joint unchanged. Standoff pads float the plate
    over the DIP recess and wireless bay.
    The cabinet box is an open-frame chassis after four walled layouts each
    buried a connector: base plate, six filleted posts with gusset feet, vented
    roof. Corgi west (USB-C edge open), Airedale east portrait (jacks open
    east), both boards' measured hole patterns, and the 8-inch interconnect
    verified against the modeled route.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
2026-08-22 fix(update): make the updater visible — never call lv_timer_handler from inside itself
    The update buttons fire from an LVGL event callback, which already executes
    inside lv_timer_handler — and lv_timer_handler silently refuses re-entry, so
    every repaint the blocking updater asked for was a no-op. The modal, the
    countdown, the errors: all ran invisibly, which read as 'the button does
    nothing'. The modal now paints via lv_refr_now, reads the GT911 directly
    (its poll timer is frozen with us), and drives the spinner arc and carriage
    bob by hand from millis().
    Buttons are plain taps now (long-press was unprovable on the glass); the
    modal arms with a 3s touch-to-cancel countdown instead. Ever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
2026-08-22 feat(ui): drop baud hunt and SD flash, merge hold/resume, full-height Setup/Diag
    Now that network OTA is proven, two accommodations go: the UART baud hunt
    (the link is known hardware at a fixed 1 Mbaud; transport just pokes a
    status report until FluidNC answers) and the SD-card /update.bin flash
    path with its UPDATE SD button. The Wired UART toggle stays — off still
    frees the USB debug console.
    Shell: HOLD and RESUME are one button — you cannot resume a machine that
    is not held — reading RESUME (green) while paused, HOLD (amber) while
    there is motion to hold, and dimmed when moot. Setup and Diag trade the
    DRO strip for content height; every other page keeps position on screen.
    Co-Aut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
2026-08-22 feat(diag): per-switch limit lamps from FluidNC's own monitor, page-scoped
    The Diag lamps now mirror the machine's actual switches instead of one lamp
    per axis letter. $Limits/Show supplies both halves: its preamble lists
    exactly which motors have limit pins (that defines which lamps exist), and
    its 500ms samples drive them — motor0 as X, motor1 as X2, probe as P, green
    while active. Three switches in config.yaml means three lights.
    The controller only monitors while the Diag page is on screen: entering
    starts the stream (Idle or Alarm — a hard-limit trip is exactly when you
    stand here), leaving sends the ! exit, which FluidNC treats as stop-monitor,
    not feed hold. The stream is swallow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
2026-08-22 fix(update): wifi.txt always overrides, and join timeouts name the cause
    The SD credential bootstrap only ran when no SSID was stored, and the baked
    default means one always is — so a wrong stored password could never be
    fixed without a cable. wifi.txt now overrides whenever present.
    A join timeout now ends in a scan: the fail line says whether the SSID is
    visible from the panel and at what RSSI (visible = check password / AP
    mode; absent = wrong band or out of range — the S3 is 2.4GHz only).
    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
2026-08-22 fix(diag): never forget a live limit monitor — stop it; give up after 2 dry runs
    The watchdog forgot a quiet monitor without sending the ! exit, and
    mon_stop refuses to fire once the flag is cleared — so a live monitor kept
    blocking every line command on the controller, which surfaced as settings
    writes silently hanging. The watchdog now stops the monitor for real, and
    two consecutive sampleless attempts park it until the page is next opened
    instead of restarting the controller loop forever.
    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
2026-08-23 feat(cad): E-stop pod (floor-mount toggle, safety cap, cross-grain brace) + PSU posts
    The desk-edge control pod evolved through bench reality: the Pronic paddle
    toggle floor-mounts (set down through the open back, screws + nuts from
    below — the paddle's root shield is wider than any slot it could thread
    through, killing the slide-in design), guarded by a hinged flip safety cap
    with a tunable snap catch. A separately printed brace shelf sits in the
    top dead zone: box prints face-down, brace prints flat, so their layer
    laminations cross at 90° and every screw bites cross-grain; it also takes
    the desk screws. Face carries only the 22mm E-stop, bottom quarter, below
    the apron-rail dead band.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
2026-08-23 fix(cad): cap hinge alignment, rounded knuckles, brace back lip
    The cap's ear pin sat 14mm too high — aligning the pin holes forced the
    cap crooked, which is why it neither closed flat nor latched. Pin now sits
    pin_drop below the rim so closed means flush and the catch nub engages.
    Lugs and ears get rounded knuckles about the pin axis. The brace gains a
    back lip hooking over the walls' rear ends (registers depth; print lip-up).
    Deliberate bonus: mount the switch OFF-toward-face and the closing cap's
    sweep shoves the paddle to OFF, missile-cover style.
    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
2026-08-23 feat(cad): stiffening rim around the box's back opening
    8mm inward flanges along both walls' rear edges and the floor's rear edge,
    each backed by a 45° wedge so the face-down print stays support-free. A
    push on the open back now loads a frame instead of folding free plate
    edges. The brace installs from the open top since the rim narrows the
    back opening; its lip still hooks the back.
    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
2026-08-23 feat(cad): back panel with outer lip replaces top brace and back rim
    The support is now a back-panel plug: body fits snugly inside the back
    opening, a 3mm lip runs the full outer circumference and seats on the
    box's rear edges — it cannot be pushed inward, stiffens the open back,
    and closes it against dust. Four wall screws bite its edges; wires leave
    through a rounded bottom slot. The box-side rim overhang is gone.
    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
2026-08-23 refactor(cad): fillets on concave inside corners only
    Outer-corner rounds removed — fillets here are stress relief, not
    decoration. Wall-floor inner joints join the face-wall verticals and the
    cutout corners in the concave set.
    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
2026-08-23 feat(cad): elephant-foot chamfers on every bed-contact edge
    0.8mm x 45 on each part's bed plane in its print orientation — box face,
    cap rim, panel lip — including the E-stop bore rim so first-layer squish
    cannot shrink the clamp hole.
    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
2026-08-23 feat(cad): 5mm drill-guide groove grid on the back panel's inside face
    0.4-wide, 0.3-deep grooves at 5mm pitch both ways, centred on the plug —
    ruled reference for future holes; a bit self-centres in the crossings.
    Inside surface only; it's the print's top face so it comes out crisp.
    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
2026-08-23 feat(cad): drill-guide dots on every inside surface, all three parts
    Ø0.4 x 0.3-deep divots at 5mm pitch, centred per face: box face-back,
    both wall interiors, floor top, cap tray floor, panel inside face
    (replacing the groove grid). A bit self-centres in a divot; dots over
    cutouts just cut air.
    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
2026-08-23 fix(cad): pivot relief on the safety cap's hinge corner
    A door cannot swing on a square corner: the cap's rear-top region is
    trimmed to a cylinder about the pin axis (radius 0.5 inside the pin's
    depth below the floor), so the rounded corner is the pivot surface and
    clears the floor through the whole swing.
    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
2026-08-27 feat(sim): desktop LVGL/SDL simulator running the real UI and model
    Adds [env:sim]: the actual src/ui and src/model drawn by LVGL into an SDL
    window, with src/sim standing in for the RGB panel, the GT911 and the
    controller. Same lv_conf.h and the same fonts as the firmware, so layout
    seen here is layout you get on the glass.
    The link is real rather than faked. sim_transport.cpp opens the pty that
    simrun/ttybridge.py publishes and moves raw bytes, so a stock FluidNC host
    build sits behind the real GrblParserC behind the real UI. Faking the
    model's variables directly would have been fewer lines and would have made
    the DRO a picture of numbers rather than the numbers themselves. A canned
    contr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
2026-08-27 fix(ui): text that never rendered — em dashes and clipped button captions
    Two ways the panel was silently dropping characters on the glass, both
    invisible in code review and neither reproducible without looking at a
    real frame.
    The bundled montserrat subset has no em dash: every "—" rendered as a
    missing-glyph box. Nine on-glass strings had one, six of them in
    fw_update.cpp — "updating — do not power off", "flashing — screen goes
    dark", "starting in %d — touch to cancel". That is the worst place for it,
    because the panel reboots and the console log dies with it, so the glass
    is the only copy of the message. Serial.println() strings are left alone;
    they go to a UTF-8 terminal.
    w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
2026-08-27 feat(model): read machine capabilities from the controller's config dump
    The console drew a fixed page set: a PROBE page on a machine with no probe,
    a MACRO page with six buttons on a firmware that has four slots. Controls
    that can only ever return an error teach an operator to ignore errors.
    caps.cpp parses $CD, not $S. On FluidNC v4 $S returns only the Grbl-compat
    settings and carries no config tree, so anything deciding "is there a probe"
    from $S reads no for ever — which is what left the Diag probe lamp dead.
    Bare $CD dumps to the channel; $CD=<file> would overwrite the boot config
    and is never sent from here.
    Three-valued on purpose. CAP_UNKNOWN is not CAP_NO: with no link, or a dum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
2026-08-27 feat(ui): hold the boot splash until the machine has described itself
    The layout the console draws is decided by the controller: axis count sets
    the DRO's column count and its font size, and the configured limit and probe
    pins decide which pages and lamps exist. Revealing the UI before the first
    status report meant drawing a 3-axis machine that may not be this machine,
    then reflowing it under the operator.
    The splash already had a full-screen overlay and tap-to-dismiss, so it
    becomes the gate rather than a second loading screen being built.
    It is a HOLD, never a lock. A panel that will not leave its loading screen
    without a controller is a panel you cannot reach SETUP on, and SETUP owns
    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
2026-08-27 feat(ui): split the rail into operation and configuration
    RUN mode is what an operator at a moving machine needs and nothing else:
    jog, home, probe, run a file, fire a macro — each present only if this
    machine actually has it. CONFIG mode holds what you set up once and stop
    looking at: panel settings, work offsets, calibration, diagnostics.
    Mixing them cost rail slots that operation needed and put a settings screen
    one mistaken tap from a running job. Five operational entries now fill the
    rail exactly, with no scrolling.
    Two fingers held for 600ms toggles between them. Held rather than tapped: a
    palm or knuckle brushing the glass registers two points for a moment and
    must not drop a runn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
2026-08-27 feat(ui): tap an axis to jog to a coordinate
    The step selector tops out at 10mm, so crossing 400mm was forty presses —
    or holding a key at a repeat rate that is deliberately slow, because
    hold-to-jog is capped at 1mm steps. Neither is a way to traverse a table.
    Sent as $J=G90/G91 F<rate><axis><target>: a jog, not a G0. A bare "G0 X400"
    is interpreted against whatever modal state the machine holds, and in G91
    that is a 400mm RELATIVE move — the same keystroke meaning two different
    things is not acceptable on something that moves a gantry. Jog also leaves
    the g-code modal state alone and is interruptible by feed hold.
    Absolute vs relative is stated in four places at once — the selected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
2026-08-27 test(caps): cover the negative cases that hide dangerous controls
    caps decides whether HOME, PROBE and MACRO exist and whether the no-limits
    banner shows. Every path had only ever been exercised against one live
    config that happened to have a probe, homing cycles and limit pins — so the
    negative cases, which are the ones that actually hide a control that would
    drive an axis into the frame, were never proven.
    Six cases against synthetic dumps, including the bug fixed earlier this
    session: a config declaring homing cycles whose endstops have been stripped
    must NOT offer $H. Also pins the rule that a dump which never arrives leaves
    everything UNKNOWN, because hiding a control on no evidence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
2026-08-27 feat(ui): invert page gating — show only what the controller confirms
    Optional pages now appear ONLY on CAP_YES. Previously CAP_UNKNOWN left a
    page visible, on the reasoning that hiding a control the machine might have
    is the worse error. Inverted: an unlinked panel knows nothing about the
    machine, so it offers nothing that depends on one — JOG and RUN, no more.
    A PROBE tab in front of an operator before the panel has any idea whether a
    probe exists is a control that errors on first use.
    Reachability is unaffected: SETUP and DIAG are not capability-gated and are
    reached by the two-finger gesture, so recovery never depends on the link.
    The limits banner inverts the other way, toward cau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
2026-08-27 Revert "feat(ui): invert page gating — show only what the controller confirms"
    This reverts commit 5dfe85167805b1df183e93ac7df9b927943a2d9f.
2026-08-27 feat(ui): pages are a checkbox in Setup, not a deduction
    Replaces automatic page hiding with five switches under Setup > PAGES:
    Home, Probe, Macro, Offsets, Calibrate. Stored as a bitmask in NVS,
    defaulting to every page on.
    The auto-detection worked, but it made the rail change shape for reasons
    invisible from the panel. A page vanishing because a config dump arrived
    slightly differently is not something anyone can debug standing at a
    machine, and it inverted who decides: whether a machine needs a PROBE tab
    is a property of how it is used, not only of what its config declares. A
    checkbox is a thing you can look at and change.
    JOG and RUN stay because they are the job; SETUP and DIAG stay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
2026-08-27 docs: record the agreed jog rework and what constrained it
    Design only; page_jog.cpp is untouched.
    Captures the decision to drive continuous jog from a panel-side percentage
    of the axis max rate rather than the step size, and why not the controller's
    own overrides: RAPID has no +/- (Reset/Medium/Low only, per Realtime.h) and
    FEED governs cutting moves, so borrowing it would scale the next G1 as a
    side effect of jogging.
    Also records the reasoning that made raising the jog feed acceptable at all
    — the release coast is bounded in time, not distance, because chunks are
    sized to JOG_TICK_MS — and which of the three over-travel backstops are
    actually armed on this machine. One of three, dep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
2026-08-27 feat(ui): jog speed from max rate, step size from a ladder you can leave
    Two things that were tangled are now separate: the step sets DISTANCE, a new
    panel-side percentage sets SPEED.
    continuous_feed() was STEPS[s_step] * 300 — FluidDial's "5x the step per
    second" — so 1mm jogging was pinned to 300mm/min and the step selector was
    secretly a speed selector. It is now `axis max rate * settings_jog_pct()`,
    read from $Grbl/MaxRate the way goto_popup already does, defaulting to 50%.
    The slowest involved axis governs: a diagonal is coordinated motion, so
    feeding it Z's rate would ask X to exceed its own maximum.
    Panel-side rather than the controller's overrides, because RAPID has no +/-
    (Res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
2026-08-27 refactor(ui): the panel reports, the controller decides
    Removes the display's two safety opinions.
    The no-limits banner is gone. It reported a real fact, but a panel that
    editorialises about the machine is a second authority over motion, and the
    controller is the one that can actually act.
    The goto popup's travel check is gone with it, and that one was not merely
    redundant — it was unsound. It compared the resolved position against
    $Grbl/MaxTravel, which is only meaningful once the machine has homed: until
    then machine coordinates have an arbitrary origin, so the warning could fire
    when nothing was wrong and stay silent when something was. A check that is
    wrong in both directions teaches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
2026-08-27 fix(ui): the jog pad's diagonals now look diagonal
    All four corner keys wore the same vertical chevron as the cardinals, so a
    diagonal move was indistinguishable from a straight one on the glass —
    despite PADDIR having driven both axes since the pad was written.
    Drawn rather than typed. LVGL's symbol font has no diagonal arrow and the
    montserrat subset carries no Unicode one either: U+2196 would render as a
    missing-glyph box, exactly as the em dashes did. So each corner draws a
    shaft along its travel direction with a two-barb head, sized off the grid
    quantum so it scales with the panel.
    The points are static per corner because lv_line_set_points() keeps the
    pointer rather than copying it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
2026-08-27 fix(ui): match the drawn diagonals to the cardinal glyphs
    At U*4 the corner arrows came out roughly double the weight of the chevrons
    beside them: an arrow spans its box corner to corner — 1.41x the edge —
    while a glyph sits inside its own, so equal boxes are not equal marks.
    Sized off lv_font_montserrat_14's line height rather than the grid quantum,
    scaled by 2/3 to cancel that out, and the stroke dropped to 2 to match. The
    two now track together if that caption font ever changes.
2026-08-27 fix(model): file list duplicated one entry and dropped another
    Two defects, either of which alone puts the wrong name in front of a RUN
    button, and neither of which reported anything.
    field() searched with an unbounded strstr, so the OUTER {"files":[... object
    found the first entry's "name" and was added as a file. Every listing
    silently duplicated its first entry.
    And FluidNC sends the document split across lines, with the break landing
    inside an object (...{"name / ":"surfacing-pass.nc"...). A line-based parse
    saw two fragments, neither a whole object, and dropped that file entirely.
    Together: three files on the card rendered as the first one twice and the
    last one missing. On a page wh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
2026-08-27 feat(sim): link to a controller over TCP as well as a pty
    --link host:port opens a socket instead of a device, so the simulator can
    drive a real FluidNC over its telnet channel. That channel is the same byte
    stream as the UART one — GrblParserC cannot tell them apart — and everything
    downstream of the fd already works unmodified on a socket.
    Verified against the Corgi at 192.168.0.5:23: real machine coordinates, real
    G54 offsets, and the page set derived from the real config rather than the
    host build's.
    Connect blocking then switch to non-blocking, because a half-open connect
    reads downstream as "controller silent" rather than as a failure. TCP_NODELAY
    because jog chunks are small and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
2026-09-03 fix(power): survive a brownout boot-loop by clamping restored backlight
    A saved 100% brightness restored mid-boot can sag a thin 5V feed (the
    UART link cable) below the brownout threshold, and the panel loops
    forever. If the last reset was a brownout, come up at 50% for that boot
    only; the NVS setting is untouched.
2026-09-03 feat(caps): FluidNC v4 capability model, desktop sim bench, motion page
    The Corgi runs FluidNC v4.0.3, which broke every v3 assumption about $S:
    the config tree (probe pin, limit pins) now only appears in the $CD dump.
    New src/model/caps.{h,cpp} is the one place that answers 'what can this
    machine do' — tri-state, fed by $S and $CD, unknown stays enabled because
    a failed query is not evidence of missing hardware. Home, Probe, Diag and
    the nav rail gate off it.
    Also in this batch:
    - sim/: desktop bench running the real ui/ and model/ against a fake
    FluidNC v4 with the actual Corgi config (see sim/README.md)
    - new MOTION page
    - filelist.cpp: skip the outer JSON object so the first file no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
2026-09-03 feat(ui): single tap on the state chip opens Setup
    Reaching SETUP from a running page took five taps on the rail's scroll
    arrow. The state chip sits on every DRO page and Setup hides the DRO, so
    it cannot re-fire from inside. Replaces the two-finger-hold idea outright:
    the GT911 driver is single-point, so a second finger was never seen.
2026-09-03 feat(jog): continuous jog gets its own step, decoupled from the selector
    FluidDial's button jog never couples hold distance to the dial step: the
    move is a fixed long one, only feed follows the dial. Ours refused
    hold-to-jog above 1mm and scaled feed off the selector, so a coarse step
    lost continuous entirely. Held keys now always crawl at a fixed
    1mm-equivalent rate (300mm/min, 0.75mm chunks) at any selected step.
    The discrete step moves from press to release: on press it would land
    right before a hold's crawl -- a surprise 10mm lunge at the coarse step.
    A tap still delivers its whole step; press-lost now delivers nothing.
2026-09-03 feat(jog): FluidDial-style continuous jog — one long move, cancel on release
    The chunked 150ms re-issue existed because early bring-up saw the 0x85
    JogCancel byte ignored — testing that ran over WiFi, which is the likely
    culprit. On wired UART the cancel lands, so continuous jog is now the
    pendant's own idiom: a 5000mm move at 5x-the-step-per-second, ended by
    JogCancel on release, with the cancel resent every 80ms until the state
    leaves Jog (min 250ms, max 1.5s — FluidDial's exact discipline), so one
    lost byte cannot run an axis to the end of travel.
    Feed follows the selected step again, so the selector picks creep vs
    traverse, and every step size keeps hold-to-jog.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
2026-09-05 feat(tools): gear burn-in G-code generator — ramping racetrack oval
    449m of XY-only travel around a 750x375 tangent-arc oval, feed compounding
    from F500 to the Corgi's F5000 max so step/tooth skipping surfaces at a
    known speed. Knobs for width, ramp percent and passes-per-step; the
    committed burnin_oval.nc is the ~6h default.
2026-09-05 chore(tools): regenerate burn-in at +2%/pass — the ~3 hour ramp
2026-09-07 feat(cad): switch-panel vanity plate, toggle dress nut, letter inserts
    E-stop | H100 VFD display pod with the 1/4in toggle under it | mains
    rocker, 110mm tall, all centred. Rear registration rim with compression
    tabs, back ribs, pocketed labels with press-fit colour letters, and a
    printed dress nut for the nutless toggle. Wood opening 148x98 (+slop);
    1:1 paper template generator included.
2026-09-07 feat(sim): one-app bench — panel embedded in the browser page
    fluidnc_sim.py spawns cncsim headless and proxies its new --web frame/
    touch server under /panel/*, so ./sim/run.sh brings up everything in one
    tab: live clickable panel, pinout card (hover zoom), driver toggles.
    Driver 'online' inputs ride Pn: as digits 0-4; M64/M65 on outputs 8-11
    cut/restore them so the reset flow round-trips. Shim gains putUShort.
2026-09-07 feat(ui): per-axis driver health on the DRO, reset from the tap-in card
    Pn: digits 0-4 (X Y1 Y2 Z A, present while online) drive a green dot /
    red ! badge in each DRO cell; A only earns its cell while its driver
    reports. Tap-in card grows RESET DRIVE: M64 -> G4 P0.75 -> M65 on the
    Airedale relay outputs (X=8 Y=9+10 Z=11), dwell on the controller.
    Feature stays dormant until the wiring ever reports.
2026-09-07 fix(hw): IMU presence expires after 2s of silence
    Hot-plug glitch left the sensor mute while s_ok swore it was fitted:
    reading frozen on the glass, SEARCH locked out. Two silent seconds now
    mark it absent (covers NAK-ing and rebooted-asleep sensors); SEARCH
    re-probes and recalibrates.
2026-09-07 fix(ui): splash swallowed tap-to-skip after the sweep finished
    lv_obj defaults to CLICKABLE, so the reveal window - full-screen once the
    sweep completes - sat over s_root eating every tap with no handler and no
    bubbling. Taps only worked while the sweep was still left of the finger.
    Driver logs proved presses reached LVGL; sim reproduced with a late tap
    against a dead link. Cosmetic children now pass taps through.
2026-09-07 fix(ui): splash sweep no longer repaints the whole reveal every frame
    Growing the clip window per frame invalidated the full-height region
    behind it — 800x480 through the 1/10-screen buffer collapsed the sweep
    to ~7 visible chunks. The reveal now advances in 8 quantized passes
    (each band painted once); only the 3px gantry line moves per frame.
2026-09-07 feat(ui): splash arrives — zoom-out + fade-in replaces the gantry sweep
    The sweep repainted a full-height region per frame and slideshowed on the
    panel even quantized ('king kong doo doo' - Matthew). The wordmark now
    starts oversized and transparent and settles to life size while fading in,
    touching only its own centred box per frame. Tap-to-skip unchanged.
2026-09-07 fix(ui): splash arrival animates with primitives v8 actually renders
    transform_zoom on labels blanks them for the whole animation (measured in
    the sim; LV_DRAW_COMPLEX on made no difference) — the mark popped in at
    anim end. The arrival now fades each leaf on its own opa and settles the
    pieces into place (word down, subtitle up, rule growing) — both proven
    mid-flight in captured frames this time.
2026-09-07 feat(ui): splash is now static wordmark + honest boot progress bar
    Two animation attempts fought this panel's redraw budget; per Matthew:
    'just load the screen and give a progress indicator.' Bar tracks real
    stages - 25 code up, 50 link, 75 first report, 100 config settled - and
    never creeps. Tap-to-skip unchanged.
2026-09-07 feat: adopt the settled driver-I/O contract (configurator handoff)
    Per /tmp/HANDOFF-driver-io-configurator.md findings (verified against
    FluidNC source): M64/M65 address user_outputs SLOTS - resets move from
    P8-P11 to P0-P3, plus P4 for A's new relay (Airedale out 12). X/Y1/Y2/Z
    status rides macro pins as Pn: digits 0-3 (unchanged parse); A's status
    will come via polled M66 - until that path exists A shows no badge and
    never gates, but its RESET DRIVE works. Sim mirrors the slot mapping.
2026-09-27 sim: $XS file send, sample CAM files, serial bridge for the real panel
    - fluidnc_sim.py: $XS=<path> sends real files from sim/sdcard over
    XModem-1K/CRC like FluidNC's xmodemTransmit (waits for 'C', 16 x 2 s);
    bytes are routed to XModem per byte, since the receiver's 'C' can arrive
    in the same read as the $XS line. SD listing sizes come from disk.
    - serial_bridge.py: pyserial bridge from the panel's /dev/ttyUSB0 @ 1 Mbaud
    to the sim's :2323, reconnecting on panel reset/USB drop. socat did not
    carry replies back to the panel (it sat on NO LINK).
    - sdcard samples: a VCarve-style .tap (header, 2 tools, G91.1) and a
    surfacing job, for the job-stats scan.
    - fakefluidnc.py: A no longer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
2026-09-27 feat: machine controls, job stats, alarm lockout, status bar, touch wake retry
    Controls
    - STEPPERS: green/red toggle, $MD off / $ME on. FluidNC never reports
    enable state, so it is tracked panel-side and re-armed by any motion.
    - FEED/RAPID/SPINDLE: vertical faders in the safety bar. Relative drag
    (1%/px, 10..200%, detent at 100; rapid steps 25/50/100), sent on release
    as reset-then-step, long-press (no travel) resets to 100%.
    - UNLOCK ($X) in the safety bar, amber in Alarm.
    - Alarm lockout: in Alarm/ConfigAlarm every control that would send G-code
    or motion is gated with "home or unlock" (jog, zero, probe, RUN/DRY,
    macros, offsets, cal MOVE, RESET DRIVE, GOTO). UNLOCK, RESET, HOME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
2026-09-28 cad: lean-to cabinet for the CrowPanel Advance 7.0
    Fixed wedge bolted to the table (4 x 1/4-20 up into captive nuts in the
    floor rails), face leaning back 30 degrees. The stock bezel comes off:
    a 5.58mm front wall with an LCD window holds the panel flush, clamped
    by four snap pins through the case's corner holes. Back flap on a
    snap-in pin hinge with a hairpin-spring latch (press the flush tab in to
    open), status-bar slot in the roof with a clear PLA lens, R1.5 inside
    fillets and 1mm outside chamfers. No heat-sets anywhere.
    Parametric script checked against Elecrow's STEP: clash tests with
    positive controls, flap and hairpin swing sweeps, watertight meshes.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
2026-09-29 feat(setup): status lights on/off switch
    - settings_status_led() (NVS "statusled", default on); off blanks the bar,
    on restores the machine-state colour immediately.
    - Setup: Wired UART and Status lights share one strip side by side --
    stacked, two switch rows clipped the PAGES box's second checkbox line.
    The whole card toggles, since the slider itself shrank below the touch
    floor.
2026-09-30 fix(touch): probe before reset, recover a lost GT911 in the background
    - gt911_discover() probes first and resets only on a miss (re-running the
    full STC8-250 + INT strap between attempts), before the display comes
    up; a GT911 that is already answering is not reset needlessly. The
    interrupt is attached once the chip is found, reset or not.
    - Not found at boot is no longer final: touch_poll() re-runs wake + probe
    every 2 s until it answers, so a reseated ribbon brings touch back
    without a reboot.
    - Diagnostics: FORCE_CONSOLE keeps the boot console for the whole run
    (link not started) and logs every STC8 ack, probe result and an I2C
    scan; I2C_HZ overrides the bus clock.
    Root cau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
2026-09-30 fix(model): replies and messages never reached the console; config dump never ended
    - GrblParserC consumes "ok", "error:N" and "ALARM:N" itself (show_ok /
    show_error / show_alarm), so none reached the console log. They are
    logged there now, so error and alarm names finally appear.
    - [MSG:...] lines were dropped entirely: the library's handle_msg() is an
    empty weak default and nothing overrode it. It now feeds
    model_flag_message(), so FluidNC INFO/WARN/ERR, $CI's channel list and
    the Airedale BOARD banner reach the console.
    - caps waited for an "ok" line to end the $CD dump, which never came, so
    it stayed in dump mode all session and swallowed every plain reply line
    after it ($G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
2026-09-30 feat(ui): Diag answers in place; rail arrows hide at the ends; FLIP removed
    Diag
    - Setting edits no longer jump to the full-screen console: a status line
    shows the controller's reply (ok, REJECTED with the error name, or no
    reply after 5 s), and on ok the setting is re-read so the list shows
    what stuck. Read-only Grbl/ views (error 162) say to change config.yaml.
    - SAVE CFG: a tap explains it needs a hold; the hold reports its result.
    - CHANNELS, GPIO and typed commands show their output in the list itself,
    scrollable; ALL / CHANGED return to settings.
    Shell
    - Rail scroll arrows show only while there is more that way (the old
    greying recoloured the button, never the label). Transp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
2026-09-30 sim: $GD, $CI, $CD=<file>, single-setting reads, read-only Grbl/ views
    Matches FluidNC v4 so Diag's buttons and edits behave in the sim as on the
    machine: GPIO dump and channel list in FluidNC's formats, $CD=<file> acked,
    "$name" answered as "$name=value", and error:162 for the INT_PROXY
    Grbl/ settings.
2026-10-01 feat(diag): label GPIO by config role, CONSOLE button, UART loss detector
    - caps tracks the YAML key path through the $CD dump and records what each
    gpio.<n> is used for (caps_gpio_role(), e.g. "x/motor0/limit_neg (pu
    low)"; quoted values accepted). Diag's GPIO ($GD) output shows that role
    beside each pin, or "free". Test added.
    - CONSOLE button on Diag (beside ALL / CHANGED): the full-screen log had no
    way in once Diag stopped opening it for command output.
    - UART receive losses are now visible: the driver's event queue reports
    FIFO overflow, ring-full, framing and parity errors, and the main loop
    logs "UART RX lost bytes: ..." to the console when any occur -- so a
    shredded li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
2026-10-01 feat(diag): typed setting editors - checkbox, dropdown, number pad
    ON/OFF and true/false settings get a checkbox, FluidNC's enum settings a
    dropdown, numbers the jog number pad (prefilled and sent as typed text, so
    no float rounding). A rejected write snaps the editor back. NVS writes say
    "stored"; only Grbl/ and $/ items point at SAVE CFG.
    sim: non-Grbl NVS settings accept writes and keep the value.
2026-10-01 cad: lean-to drill template, current lean-to model and switch plate print
    make_mount_template.py writes a 1:1 Letter template for the four 1/4-20
    table bolts and the cable-hole zone, taking its numbers from lean_to.py.
    README: front-to-back bolt spacing is 48.10 mm (was a stale 49.14).
2026-10-07 fix(jog): keep the last max rate when the settings table is reloaded
    Diag (All/Changed) and Motion edits clear the $S table and re-request it.
    Jog and Go-To looked MaxRate up there on every move, so in that window they
    fell back to 500 mm/min x jog% (Go-To 1000) and crawled. Remember the last
    rate the controller reported per axis.
2026-10-07 feat(update): [MSG:PANEL:UPDATE] from the controller runs the network update
    Send $LM=*PANEL:UPDATE over telnet to FluidNC (or $Msg/Channel=uart_channel2,
    PANEL:UPDATE). Refused unless Idle/Alarm; the update's tap-to-cancel
    countdown still applies.
2026-10-07 feat(jog): cap panel jog and Go-To at 7000 mm/min
    Rapids stay at the axis max_rate (10000 XY); FluidNC has no separate jog
    limit, so the panel enforces it.
2026-10-08 Record raw IMU axes to SD and the console
    The vibration guard kept only the scalar magnitude and discarded the three
    axes every sample, which cannot be rotated into the machine frame afterwards
    and cannot tell an X reversal from Z chatter. The sensor is spindle-mounted in
    an arbitrary orientation, so the frame has to be recovered in post from the
    still baseline plus a known single-axis move -- raw axes or nothing.
    New model/imu_log.{h,cpp}: a 2048-record PSRAM ring drained from loop(), to a
    CSV on the card (with FluidNC state and machine position per sample) and/or to
    the USB console (short form; the link is off by definition in console mode).
    The card never waits on the console. A full rin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
2026-10-08 Fix the log's position column for E4 builds and for no link
    Two defects, both caught by the first real build and the first real read of
    what the columns would contain.
    toMm() is declared in FluidNCModel.h unconditionally but only DEFINED in the
    non-E4 branch, and this project builds -DE4_POS_T. Calling it compiled clean
    and failed at link. Worse, it would have been wrong even if it linked: myAxes
    and myWco hold the DISPLAY unit, so a job in G20 stores e4 INCHES. Converted
    with e4_inch_to_mm() so the log is always millimetres, whatever the job was in.
    With the Setup "Wired UART" toggle off there is no controller and no position,
    and 0.000 there reads as a real measurement taken at the origi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
2026-10-08 Re-prime the link when the controller reboots under a live panel
    The settings, config, offsets and file list were requested once at first
    link and never again. A FluidNC reset that did not drop the link to
    Disconnected left the panel without axis max rates, so the jog page fell
    back to its 500 mm/min creep rate, and the $RI auto-report was lost too.
    Detect the "Grbl ... FluidNC" boot banner (the last line of startup, when
    the controller can answer) and re-run the priming plus $G and $RI=200.
    Also re-arm priming on a drop to Disconnected.
2026-10-08 fix(update): static update modal, no animation while the flash cache is off
    The spinner, bar and carriage redrew the modal constantly while WiFi and
    flash writes desynced the RGB scanout, garbling that region. Now two static
    messages: downloading, then updating/wait for reboot.
2026-10-08 Add Setup option to release the steppers when the idle screen blanks
    When the screensaver blanks an Idle machine, send $MD (same as the STEPPERS
    button) so the axes don't sit energized after the operator walks away. Off by
    default; holding torque matters while working at the machine.
2026-10-10 Homing walk-through on lost position; disarm hard limits while steppers are off
    Homing: the panel now tracks whether machine position can be trusted
    (unknown at boot/link, lost on reset or a position-losing alarm, regained
    when a homing cycle ends outside Alarm) and opens a walk-through when it
    cannot: checklist, HOME ALL, then an optional TLO run via whichever
    controller macro applies a G43.1 offset. The card leaves the safety bar
    uncovered. Jog stays the first page.
    Steppers: STEPPERS OFF now also sets hard_limits=false on every motor that
    has them, so touching a switch while pushing the gantry by hand no longer
    trips a hard-limit reset that silently re-enables the motors (idle_ms 255).
    A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
2026-10-12 Tool changes: TOOLS rack, tool-change card, TLO button; override popouts
    - Tool-change card: when a job pauses with a tool request pending (the
    post's "(MSG, Change to Tn: name)" and atc_manual's "Install tool #n"),
    show the tool number and name with one TOOL CHANGED (cycle start) button.
    - TOOLS page: T1-T13 and an IN SPINDLE readout from $G. Each tool offers
    LOAD (M6 Tn), CURRENT (M61 Q0, M61 Qn) and UNLOAD (M6 T0), gated on what
    is in the spindle, with the reason shown on whatever is unavailable.
    - Probe page: TLO FROM SENSOR runs the controller's TLO macro; the probe
    input readout shrinks to a strip to make room.
    - Feed/rapid/spindle overrides open a full-width card (slider + s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
2026-10-12 Network update: stage the download on the SD card, resume on a stall
    The image used to come down in one HTTP request into PSRAM, so a single
    stall threw the whole download away ("incomplete download"). It now goes
    to /fw/update.part on the panel's SD card; a stall or dropped connection
    reconnects and asks for the missing bytes only (HTTP Range, which Gitea
    behind Cloudflare answers with 206), up to 5 tries. Wi-Fi then goes off
    and the slot is flashed from the file; Update.end() verifies the image
    before the boot selector moves. Progress shows on screen.
2026-10-12 Network update: stage in PSRAM when there is no SD card
    With the function DIP on WM the status bar takes the SD slot's pin, so the
    card is never there and the SD-only staging refused every update. Without
    a card the download now goes to PSRAM as it used to, with the same
    reconnect-and-resume (HTTP Range) that fixes the stalls.
2026-10-12 Build the panel SD card out by default (HAS_SD_CARD)
    With the function DIP on WM the status bar owns the slot's pin, so the
    card can never be used on this panel. The card is now a build-time
    feature, off: sdcard.cpp compiles to nothing and sd_* become inline
    no-card stubs, the network update stages in PSRAM only, the wifi.txt
    bootstrap is gone (creds come from NVS or the built-in defaults), and the
    Diag IMU LOG button and the console's "r" record key are not built. The
    IMU console stream stays. Uncomment -DHAS_SD_CARD in platformio.ini (DIP
    on TF-CARD) to bring it all back; both variants build. Saves 32 KB.
2026-10-26 TOOLS page laid out as the machine: T0 by hand, OpenATC rack, off-rack tools
    T0 is the hand-fitted tool; T1-T5 are the OpenATC pockets along the far
    (high-Y) edge of the table, drawn as one outlined strip with pocket numbers;
    T6-T12 are numbered tools changed by hand. Each tool's card says which of
    the three it is. RACK_POCKETS and TOOL_MAX are the hardware's counts and
    size the grid. T0 now shows in the IN SPINDLE readout instead of "--".
2026-10-26 TOOLS: draw the OpenATC rack as it sits, right side, T1 at the front
    The rack is a column of pockets on the machine's right-hand (high-X) side,
    stacked front to back. The page now shows it that way: a column on the
    right, pocket 5 (back) at the top down to pocket 1 (front) at the bottom,
    with the hand tools on the left. TOOLS gives up the DRO strip, as Setup
    and Diag do, so five pockets stay a fingertip tall; it has its own IN
    SPINDLE readout and the safety bar is untouched.
2026-10-26 Tools: tap a tool, LOAD or CANCEL; the OpenATC macro does the rest
    The tool card is now LOAD (M6 T<n>) and CANCEL, with the plan spelled
    out from what is in the spindle -- e.g. "T3 back to pocket 3 > pick up
    T5 from pocket 5 > measure it" -- and LOAD gated on Idle, homed, and not
    already loaded. FluidNC's current tool starts at -1 after every boot and
    reset; the panel shows that as "?".
    The tool-change card learns openatc_m6.nc's stops: "Install tool T<n>"
    (FluidNC's PRINT cannot emit a literal '#') and a REMOVE TOOL variant for
    "Remove tool T<n>" / "Remove the tool in the spindle" before a rack
    pickup. toolchange gains an explicit pending flag, since T0 (the hand
    tool) and -1 (unknown) are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
2026-10-26 Run controller macros by slot number: $RM=1, never $RM=Macro1
    FluidNC 4.0.x's $RM takes the first character of its argument as a digit
    and indexes the four-slot macro table with it unchecked. The panel sent
    the macro's name, so "$RM=Macro1" read slot 29: past the end of the table,
    into whatever follows it. Every sender -- the Macro page, the homing card's
    MEASURE TLO and the probe page's TLO FROM SENSOR -- now goes through
    caps_macro_num(), which maps "MacroN" to N and refuses anything else.
2026-10-29 README, UI screenshots, and the bench simulator building again
    - README.md: what the panel does, building and flashing, both simulators,
    layout, credits. Screenshots of every page and the main cards, rendered by
    the desktop simulator, plus the FluidNC bench, in docs/screenshots/.
    - TOOLS: an unknown tool (FluidNC's -1 after boot) never painted as "?",
    because the "nothing painted yet" marker was also -1.
    - Bench simulator (make -C sim) had not built since the IMU recorder landed:
    its Serial shim lacked availableForWrite()/write(buf,n) and its hardware
    stubs lacked imu_rate()/imu_set_rate().
    - Desktop sim: --toolchange N names the tool when it is one of the sample
    job's.
    Co-Autho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
2026-11-05 Tool buttons follow what M6 really does on this controller
    The card always described the OpenATC rack, but the controller still runs
    atc_manual, where nothing goes near a pocket, and LOAD from T0 only moves to
    the change position -- no pause, no measuring. Removing CURRENT had also
    removed the step that makes atc_manual work at all.
    caps now reads atc: / m6_macro: from the config dump, and the card follows:
    macro LOAD / CANCEL, plan per openatc_m6.nc
    atc_manual LOAD / CURRENT / UNLOAD, gated on the spindle, with text saying
    what will happen, including that T0 path; the rack is labelled
    not in use
    IN SPINDLE: $G's T is the SELECTED tool, moved the mome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
2026-11-05 TOOLS: five buttons, one per cartridge; everything else is the custom tool
    There are five OpenATC cartridges, so T1-T5 are the only tool buttons, in the
    rack column, beside a large IN SPINDLE readout. Anything else in the spindle --
    T0, a number that is not a cartridge, or nothing FluidNC knows of -- is the
    custom tool: it reads CUSTOM, its plan and removal card say so, and no number
    outside the rack changes the behaviour.
2026-11-05 Host tests and the bench simulator build without PlatformIO
    test/run_host_tests.sh builds every test_* folder with plain g++ and Unity,
    using the same sources and flags as [env:native]. A CI job runs it and builds
    sim/ on every push, so each step of the rework is checked before it is flashed.
    sim/src/sim_sd.cpp redefined the inline no-card stubs hw/sdcard.h supplies
    when HAS_SD_CARD is off, which is the firmware default, so the bench simulator
    no longer built. Its card functions now follow the same switch.
    Claude-Session: https://claude.ai/code/session_01Uqr4BLDFjWoo8xWxrvcr82
2026-11-05 Spindle card: ask what is in the spindle when the controller does not know
    Imported as-is from the uncommitted work in the Gitea working copy
    (2026-11-05), so the fixes that follow are reviewable against it.
    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
2026-11-05 Spindle card: EMPTY only on the toolsetter's word; no tool query after a jog
    NONE / SKIP answered M61 Q98 (empty) on the operator's say-so. With a
    cartridge still in the collet, the next LOAD skips the put-back and drives it
    into a full pocket. EMPTY is now enabled only after the toolsetter tap found
    nothing. SKIP closes the card and leaves the tool unknown until the next link
    drop, restart or lost position; the TOOLS page shows "?" and keeps LOAD locked
    ("spindle unknown: tap IN SPINDLE"), and tapping IN SPINDLE brings the card
    back.
    The card and the TOOLS page asked for the current tool on every return to
    Idle, which includes the end of every jog step. The query queued ahead of the
    next j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
2026-11-05 Link and send-queue safety fixes: AutoZero, link loss, restarts, RESET
    AutoZero sent 28 lines one at a time into a 16-slot queue, so the last 11
    (the Y walls, G10 and the lift out of the pocket) were dropped and the bit
    stayed in the plate with the parser in G91. Multi-line actions are now
    sequences (seq_begin/seq_line/seq_send): queued whole or refused with the
    reason on screen, and stopped at the first error or alarm instead of probing
    on from the wrong place, with a cleanup line (G90) sent instead. The queue is
    48 slots. AutoZero, the flat-plate probe, the calibration move and the
    driver-reset relay pulse use it. The flat-plate probe also left G91 behind on
    success; it now ends in G90.
    T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
2026-11-06 Remove dead FluidDial and WiFi code
    No behaviour change; each removal was a symbol nothing called, checked by grep
    over src, sim and test, then by the 16 host suites and a simulator build.
    - FluidNCModel: the WiFi/Telnet/ESP-NOW jog flow-control modes and the
    un-acked jog window, the unused liveness and recovery ladder
    (fnc_is_connected, recover_link, update_rx_time, request_status_report,
    pendant_wait_for_fluidnc_ready, flush_fnc_rx, the starting/ping/disconnect
    counters; link_service() replaced all of it), previous_state, num_digits,
    intToCStr, axisNumToCStr, the non-E4 position code, errorExpire, lastError,
    and the FNC_RX_TRACE and DEV_SIMULATED_CONNECT blocks.
    - model_compat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
